srl-ethz/hydra-documentation/README.rst

Documentation for the Hydra MK1 Opensource project
=======================================

This GitHub repository includes all the files and instructions needed to build and run a Hydra MK1 3D printer.

Read the tutorial `here. <https://hydramk1.rtfd.io>`_
