srl-ethz/hydra-documentation/CAD/readme.rst

These are the CAD files of the Hydra MK1.

For your convenience the STL parts to be printed and the technical drawings to be machined have already been generated.

For more information on the machined parts, please refer to `this article. <https://hydramk1.readthedocs.io/en/latest/bom/machined.html>`_

For more information on the printed parts, please refer to `this article. <https://hydramk1.readthedocs.io/en/latest/bom/printed.html>`_
