srl-ethz/hydra-documentation/Firmware/readme.rst

These are the files that have to be edited and put on the virtual SD card of the raspberry Pi.

Please read the documentation `here. <https://hydramk1.readthedocs.io/en/latest/build/firmware.html#reprap-firmware>`_
