srl-ethz/hydra-documentation/docs/source/usage/overview.rst

################################
Hardware and Software Overview
################################

This section will give a more specific overview of the hardware and software components and their functions.

Motion System
===============
The motion system consists of the frame, the axis, including the motors, and the print bed.
The `Rat Rig <https://www.ratrig.com/>`_ is built up from 3030 aluminium profiles (Exception: The X-Axis consists of a 2020 profile). They are connected with aluminium plates in the corners, as well as 90-degree brackets for the back linear rail mounting. The Z-axis runs on three linear rails that are directly screwed to the inside of the outer profiles. It is driven via three threaded rods connected to NEMA 17 stepper motors via thrust bearings and couplers. The print bed is an aluminium plate that has three steel balls screwed into the underside. These steel balls rest between two steel rods that are inserted in 3D printed parts, running on the linear rails and connected to the threaded rods via a plastic coupler. 
The Y-axis consists of a 2020 extrustion that is mounted on two linear rails that are mounted to the underside of the top of the frame. A third linear rail is screwed to the top of the 2020 extrusion to serve as the X-axis. The X and Y axis are driven via two long belts in a core XY layout. The belts are driven by two NEMA 17 motors located in the back of the top frame.
To tension the belts a 3D printed tensioning system mounted on the X-carriage is used. 

Tool Changer
============

The `tool changer <https://e3d-online.com/pages/toolchanger>`_ is directly mounted to the X-carriage, and consists of the tool plate, that interfaces with the receivers, a shaft to lock in the receivers, and a stepper motor to drive the shaft. The receivers have a slanted middle section, so they are pulled towards the tool plate when the shaft turns. To always apply the same force pulling the receivers towards the tool plate, the shaft is spring-loaded.

Electronics
============

The machine can be interfaced with via the web interface, hosted by a Raspberry Pi 3B running `DuetPi <https://github.com/Duet3D/DuetPi>`_ . The main Reprap 3 firmware runs on the `Duet <https://www.duet3d.com/>`_ 3 6HC. It offers connections for the X/Y stepper motors, the three Z stepper motors, the heated bed temperature sensor, the heated bed control output, and the microswitches, which are used to home the printer. It offers an additional stepper driver output, several connectors for 12-24V power outputs, and inputs for temperature sensors. To accommodate for the additional extruders and the stepper needed for the tool changer, a Duet 3 Expansion Board 3HC and a Duet 3 Tool Board are used. These boards are connected to the mainboard using a CAN connection. All boards have to be supplied with 24V which is provided by a power supply that is included in the Rat Rig kit. To switch the 230V needed for the heated bed a solid-state relay is used.
For more information on the wiring in the back of the printer, please check the section "Electronics and Wiring" under "Building Instructions".

Duet Pi
========

The Raspberry Pi hosts a web interface, which can be used to easily interface with the printer. It also makes it possible to connect to the printer via SSH. This streamlines updates to the firmware of the printer.

Duet Firmware
==============

The Hydra MK1 uses the most recent RepRap firmware. To configure the printer several .g-files are needed in the virtual SD card repository (The SD card is virtual since it is using storage on the Raspberry Pi and not a physical SD card). You can find the files on the github repository. Some are detailed in the section "Firmware and Slicer" in "Building Instructions". Here only a brief overview is given:

:config.g: The config.g file contains the initialisation process of the printer. Here all inputs and outputs are defined. Additionally, the parameters for motors, heaters, and sensors are set, and the hotends are defined.
:home.g: Homes the respective axis. In case of homeall.g the X and Y-axis are homed simultaneously, with the Z-axis following and the C-axis (coupler) being homed last. homeall.g can be run via the gcode command G28.
:bed.g: This file is called via the gcode command G32. It probes the bed at three locations close to the Z-axis leadscrews and adjusts the three axis to accommodate for any tilt in the bed.
:tfree.g: This file is called when the respective tool is deselected. It drives back to the parking spot, disengages the coupler, and clears the print head.
:tpre.g: This file is called when a tool is selected. It drives to the parking spot and couples the tool. It then moves the print bed a fixed amount to make sure the print head has enough clearance, after which it will move out.
:tpost: This file is called after tpre.g. It preheats, the print head, sets the correct offset, and moves out a bit further.

Prusa Slicer
============

Slicing files for the Hydra MK1 can be done in any slicer that can accommodate multiple printheads. This guide provides config files for PrusaSlicer. In the slicer, different extruders can be chosen for parts of the structure and for each extruder a different material can be selected.

Tools
=========

Depending on the configuration of the machine you can have multiple different tools in the back of the machine, that can be collected by the tool changer. In the standard configuration, the printer features two filament printing heads and two pellet printing heads.
