srl-ethz/hydra-documentation/docs/source/index.rst

.. doc_demo documentation master file, created by
   sphinx-quickstart on Fri Dec  3 21:49:37 2021.
   You can adapt this file completely to your liking, but it should at least
   contain the root `toctree` directive.

####################################
The Hydra MK1 Documentation
####################################

.. toctree::
   :maxdepth: 2
   :caption: Introduction

   What is a Hydra MK1? <intro/whatis>
   What Components are Used in the Hydra MK1? <intro/components>
   
.. toctree::
   :maxdepth: 2
   :caption: Bill of Materials (BOM)
   
   Overview <bom/overview>
   Machined Parts <bom/machined>
   Printed Parts <bom/printed>
   Crimped Wires <bom/wires>

.. toctree::
   :maxdepth: 2
   :caption: Building instructions
   
   Rat Rig <build/ratrig>
   X Carriage and Toolchanger <build/carriage>
   Electronics and Wiring <build/electronics>
   Firmware and Slicer <build/firmware>
   
.. toctree::
   :maxdepth: 2
   :caption: Tools
   
   E3D Hemera <tools/hemera>
   Pellet Extruder v4 <tools/pellet>
   
.. toctree::
   :maxdepth: 2
   :caption: Usage
   
   Hardware and Software Overview <usage/overview>
   Powering Up and Connecting to the Printer <usage/power>
   Homing <usage/homing>
   Preheating and Swapping Tools <usage/preheat>
   Loading Material <usage/loading>
   Slicing and Printing <usage/slicing>
   
.. toctree::
   :maxdepth: 2
   :caption: Maintenance
   
   Updating Firmware <maintenance/update>
   Calibrating Tool Offsets <maintenance/offset>
   Calibrating Parking Spot <maintenance/parking>
   Unclogging Hemera <maintenance/unclogghemera>
   Unclogging Pellet Extruder <maintenance/uncloggpellet>
