srl-ethz/hydra-documentation/docs/source/tools/pellet.rst

################################
Pellet Extruder V4
################################

In case your pellet extruder came preassembled please disassemble it until it looks like the one in this image. This can be done intuitively or by following several steps of this build guide backwards.

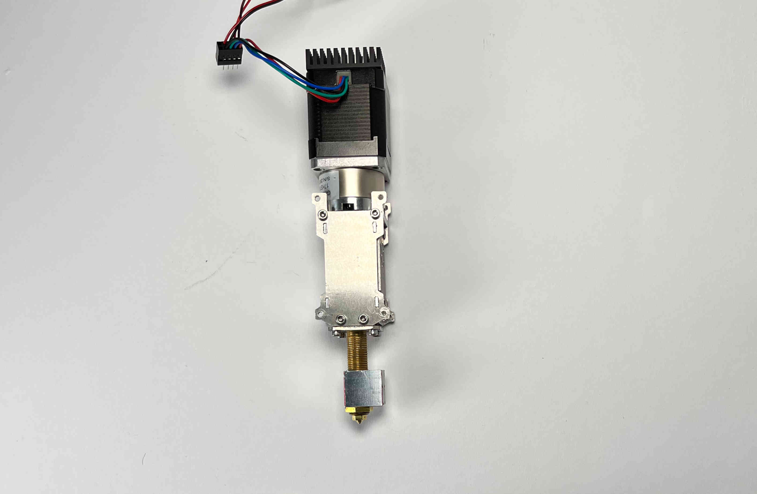
[picture p9: docs/source/tools/img/Pellet1.jpg]

   
Heating Element
===============

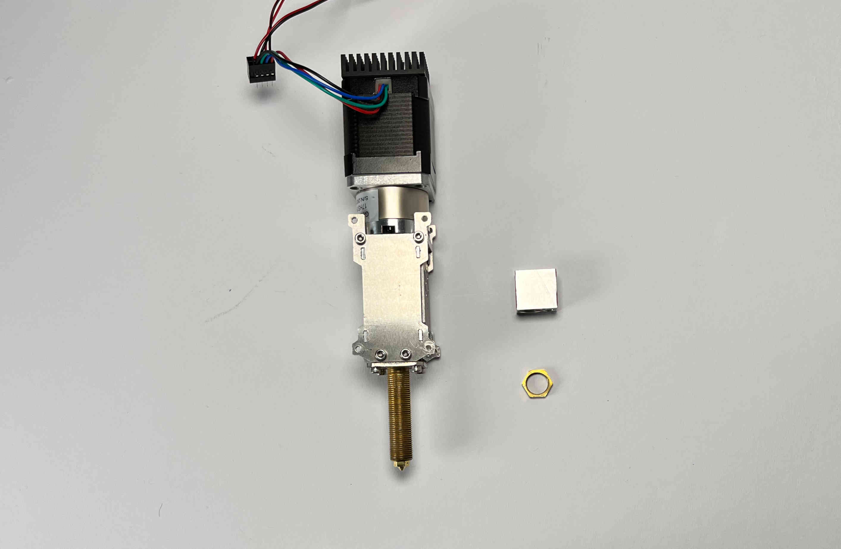
[picture p10: docs/source/tools/img/Pellet2.jpg]


| Remove the hex nut and the heater block from the hot end

| 

| 

| 

----------------------------

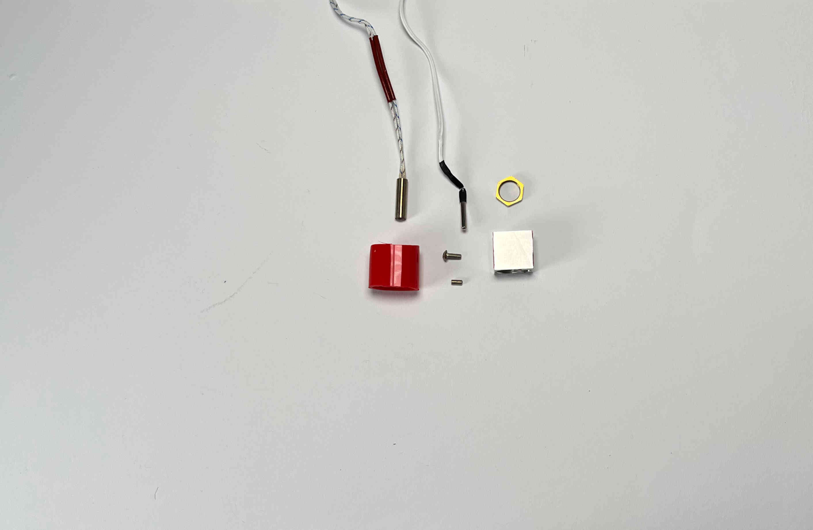
[picture p11: docs/source/tools/img/Pellet3.jpg]


| Prepare the heat cartridge, the thermistor and the silicone tube

| 

|

| 

----------------------------

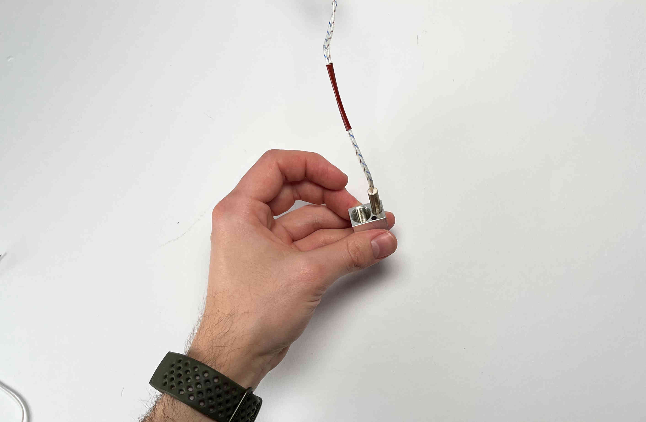
[picture p12: docs/source/tools/img/Pellet4.jpg]


| Insert the heat cartridge

|

| 

| 

| 

----------------------------

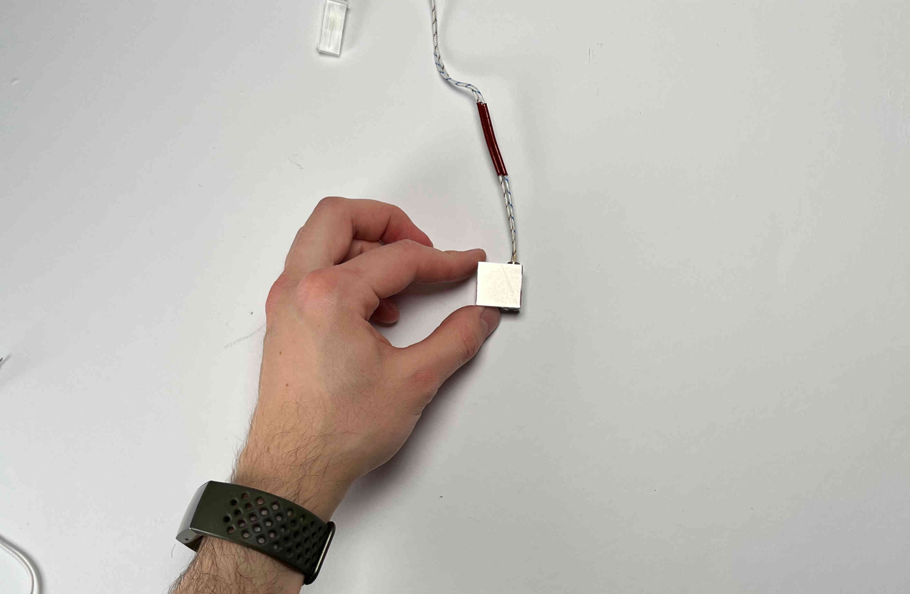
[picture p13: docs/source/tools/img/Pellet5.jpg]


| Make sure the heat cartridge is flush with the bottom of the heater block.

|

| 

| 

----------------------------

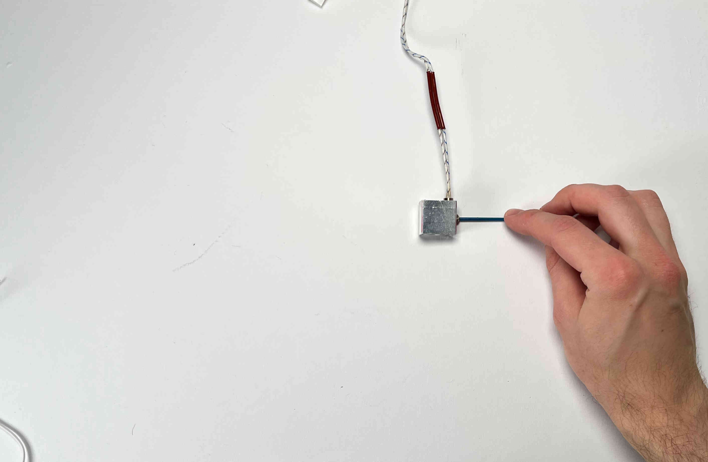
[picture p14: docs/source/tools/img/Pellet6.jpg]


| Carefully clamp the heat cartridge using the provided screw.

| 

| 

| 

----------------------------

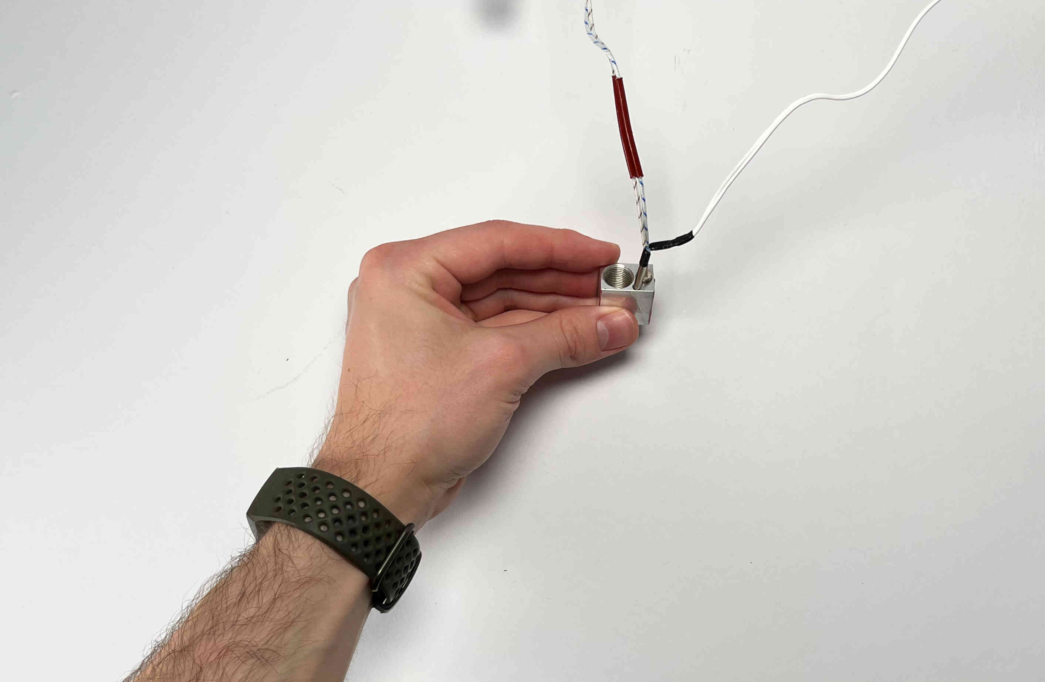
[picture p15: docs/source/tools/img/Pellet7.jpg]


| Insert the thermistor (It makes sense to check the thermistor by mearing its resistance. It should be around 100 kOhm)

|

| 

| 

----------------------------

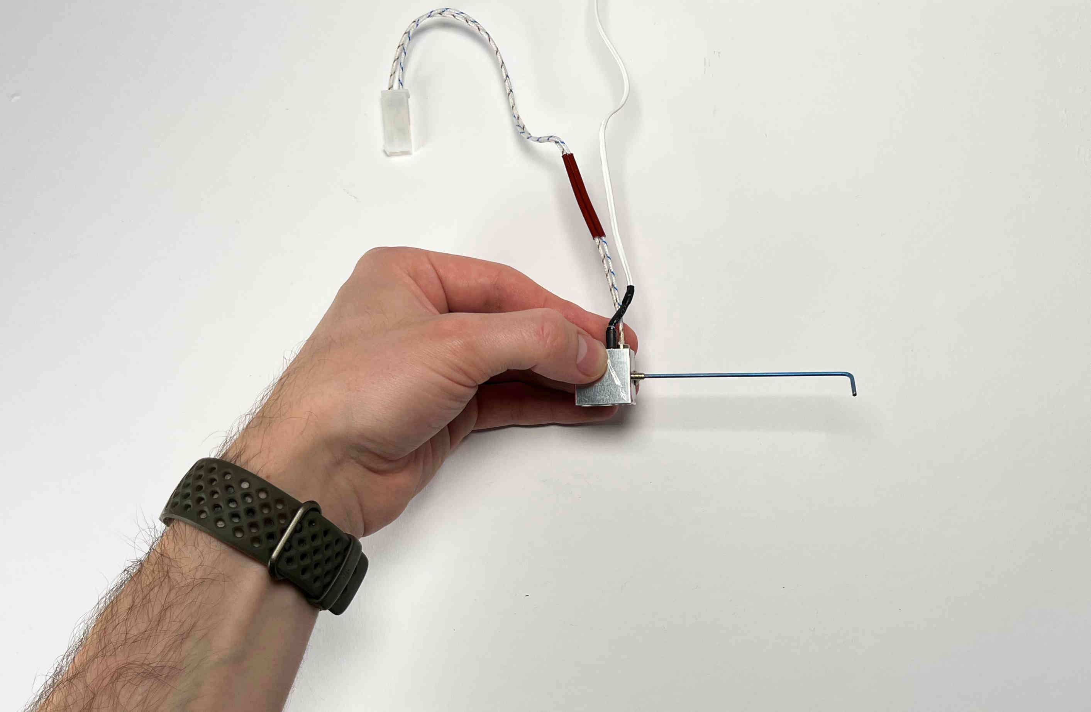
[picture p16: docs/source/tools/img/Pellet9.jpg]


| Carefully clamp the thermistor using the provided set screw.

| 

| 

|

| 

----------------------------

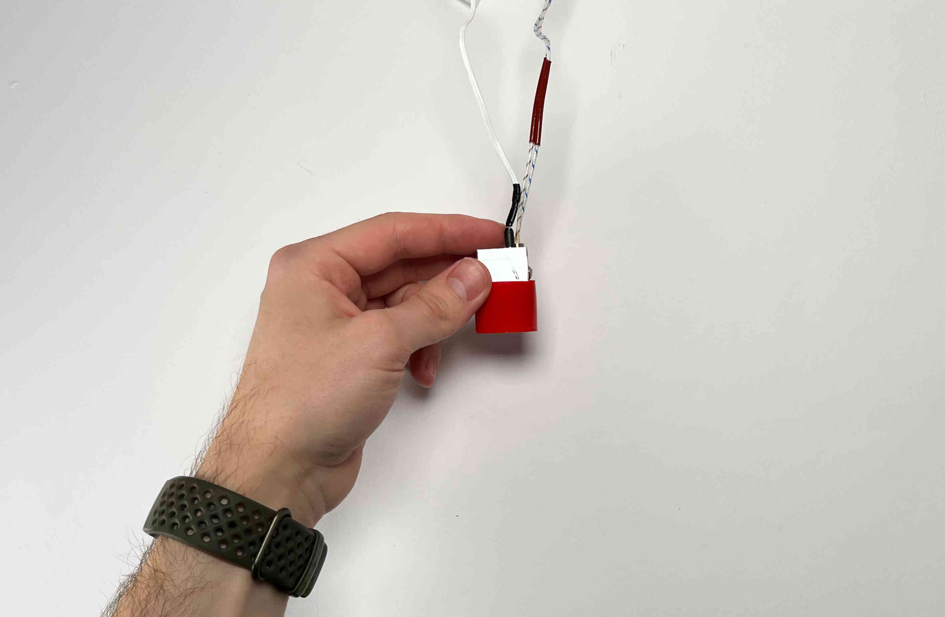
[picture p17: docs/source/tools/img/Pellet10.jpg]


| Cover the heater block with the silicone tube.

| 

| 

| 

|

----------------------------

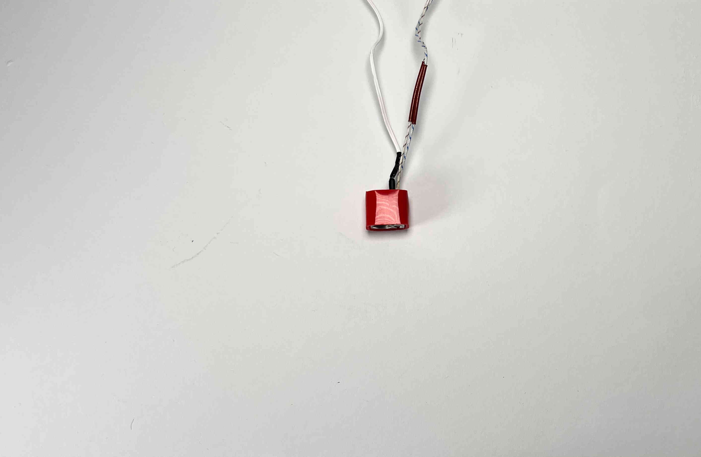
[picture p18: docs/source/tools/img/Pellet11.jpg]


| Make sure the silicone sock is flush with the lower side of the heater block.

| 

| 

|

----------------------------

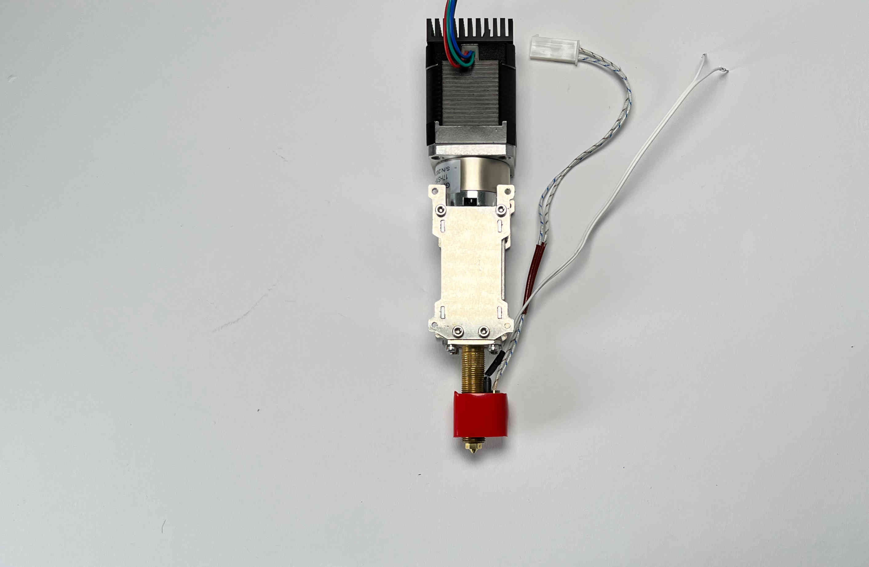
[picture p19: docs/source/tools/img/Pellet12.jpg]


| Carefully reinstall the heater block on the Pellet Extruder.

| 

| 

|

----------------------------

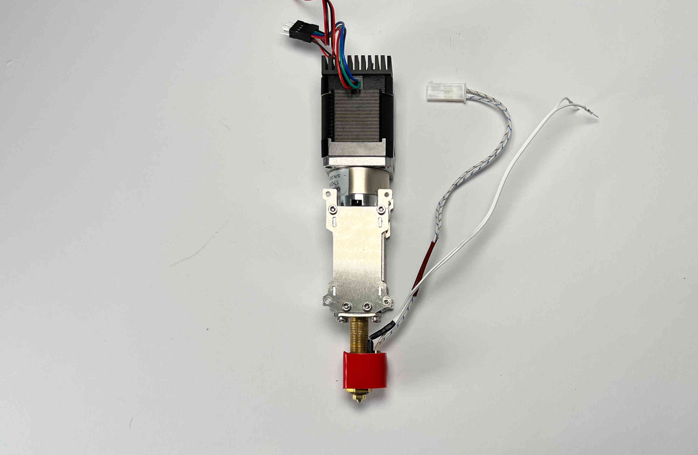
[picture p20: docs/source/tools/img/Pellet13.jpg]


| Tighten the heater block in place with the hex nut.

| 

| 

|

| 

----------------------------

Pellet Parking Spot
===================

Prepare the printed part “pellet_parking”, the machined part “pellet_bracket”, two M3 locking nuts, one M3x5 screw, two pins, the small magnet, and two M3x16 screws (The last three items are included in the “blank toolplate and dock” kit from E3D).

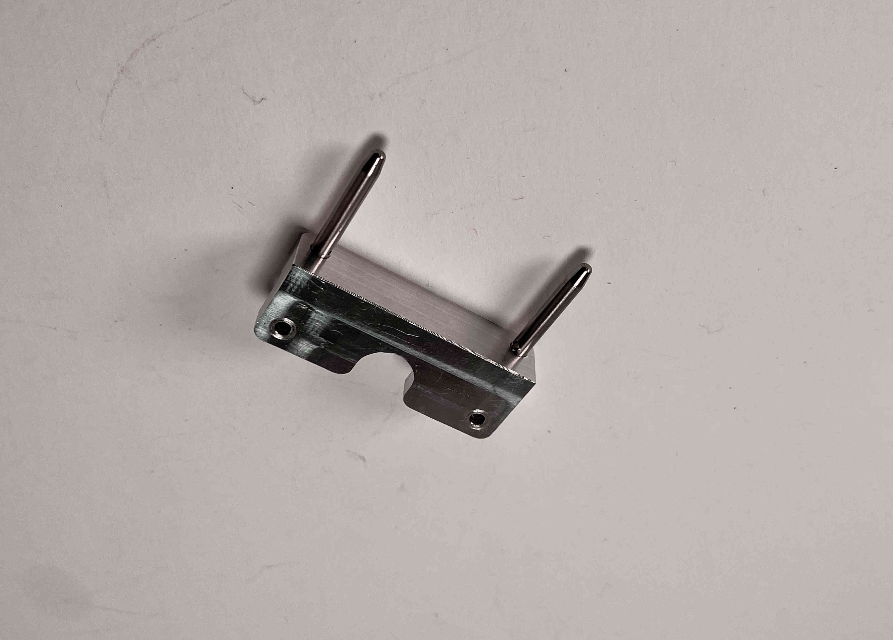
[picture p21: docs/source/tools/img/PelPark2.jpg]


| Screw the two pins into the pellet_bracket. If the fit is too tight carefully loosen up the outer hole with a 4mm drill bit. 

| 

|

| 

----------------------------

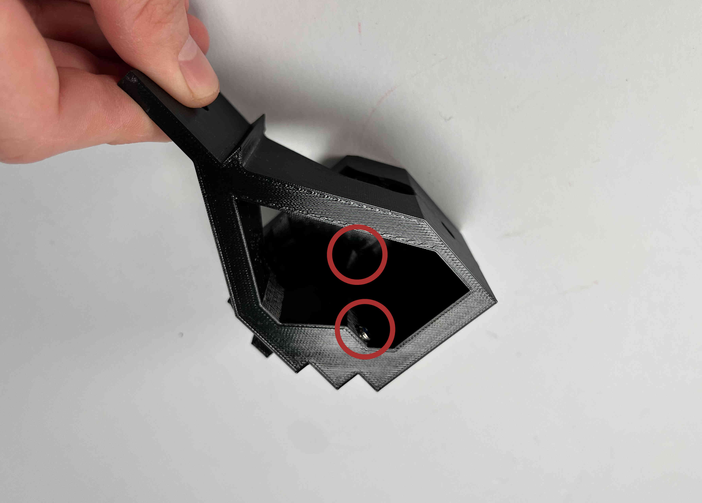
[picture p22: docs/source/tools/img/PelPark1.jpg]


| Insert two M3 locking nuts into the pellet_parking part

| 

| 

|

|

----------------------------

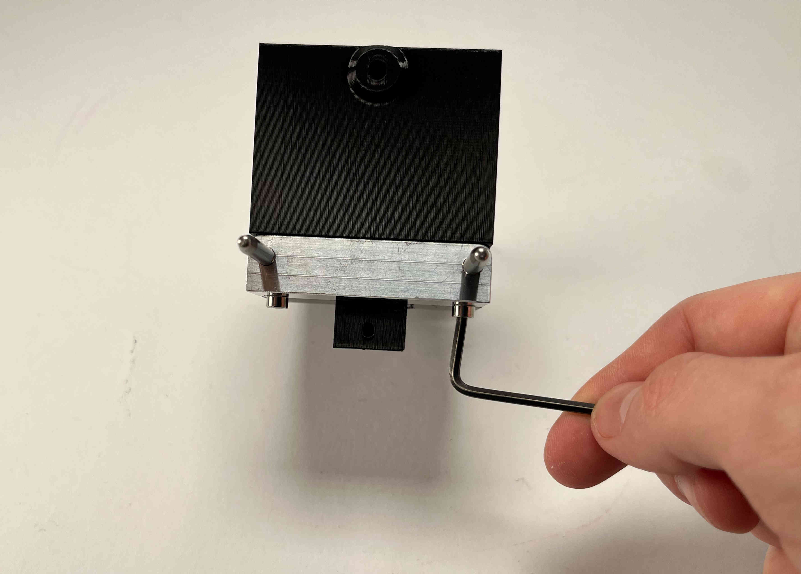
[picture p23: docs/source/tools/img/PelPark3.jpg]


| Tighten the bracket to the parking spot using the two M3x16 screws.

| 

|

| 

|

----------------------------

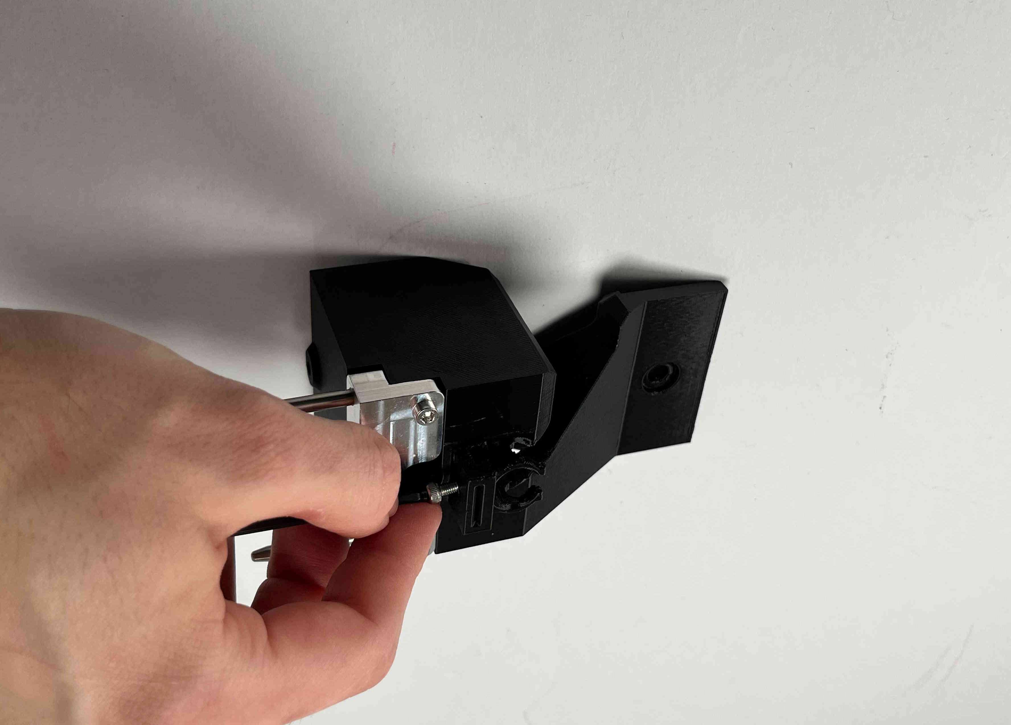
[picture p24: docs/source/tools/img/PelPark5.jpg]


| Carefully tap an M3 thread into the plastic part using the M3x5 screw. This is later used to clamp the cable brace.

| 

|

| 

----------------------------

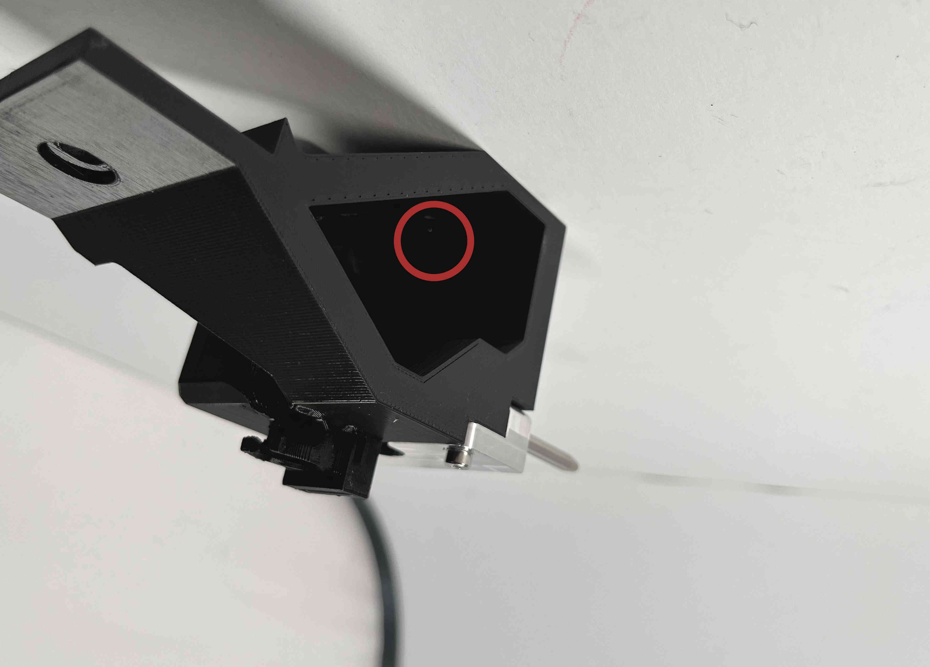
[picture p25: docs/source/tools/img/PelPark4.jpg]


| Push in the magnet until it is up against the outer plastic holding it in place. 

| 

| 

|

|

----------------------------

Receiving Bracket
==================

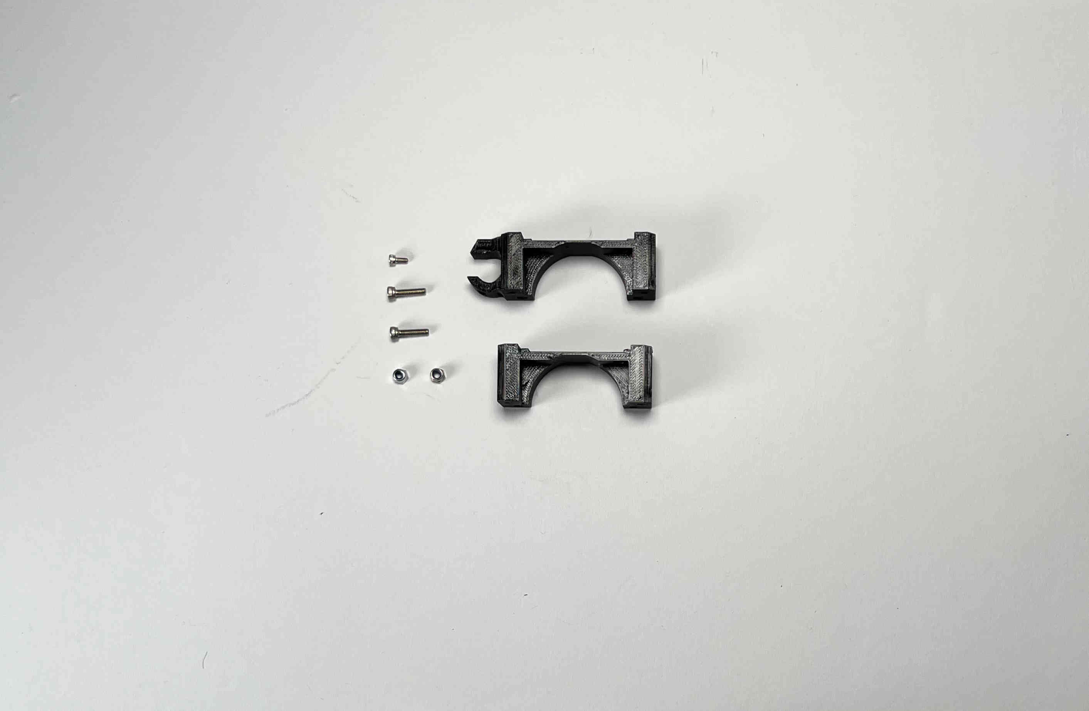
[picture p26: docs/source/tools/img/Pellet14.jpg]


| Prepare two M3 locking nuts, two M3x16 screws, one M3x5 screw, and the two parts of the “pellet_receiver”.

| 

| 

|

----------------------------

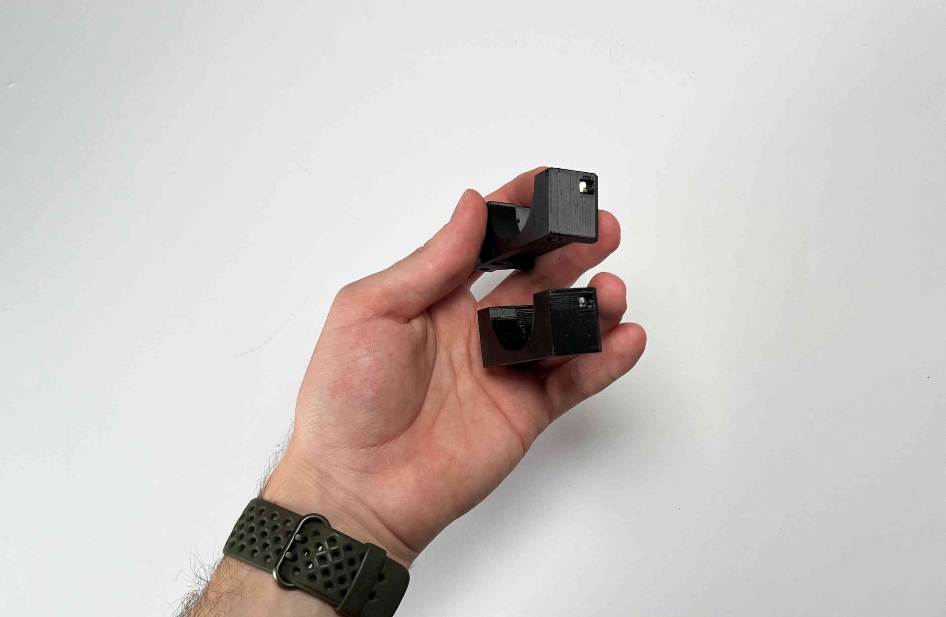
[picture p27: docs/source/tools/img/Pellet15.jpg]


| Insert one M3 locking nut into each of the two pieces of the “pellet_receiver” part.

| 

| 

|

----------------------------

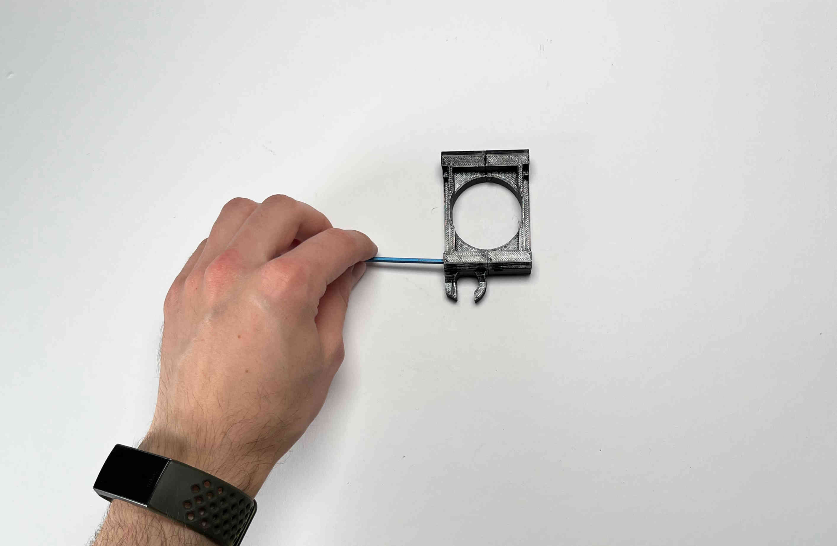
[picture p28: docs/source/tools/img/Pellet17.jpg]


| Place both parts upside down on a flat surface and join them using two M3x16 screws

| 

| 

|

----------------------------

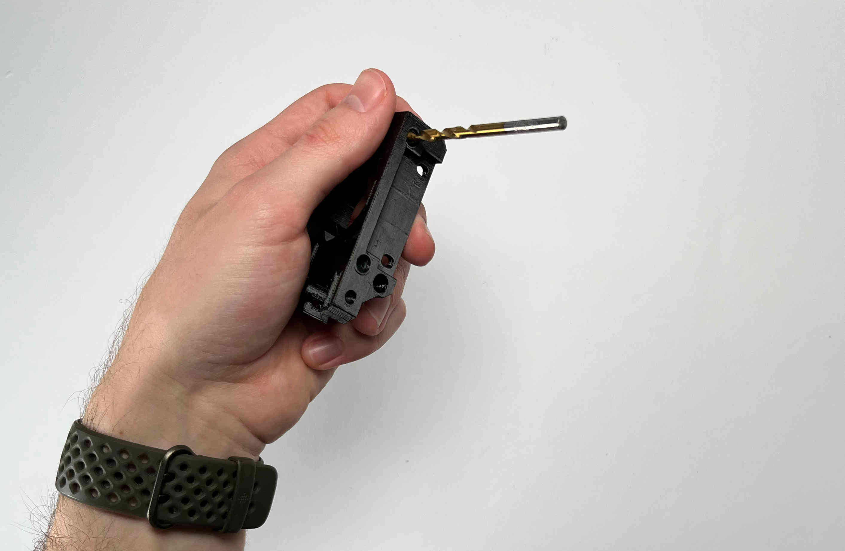
[picture p29: docs/source/tools/img/Pellet18.jpg]


| Using a 4mm drill bit carefully widen the receiver holes for the pins. Constantly check the fit using the already assembled parking spot

| 

| 

|

----------------------------

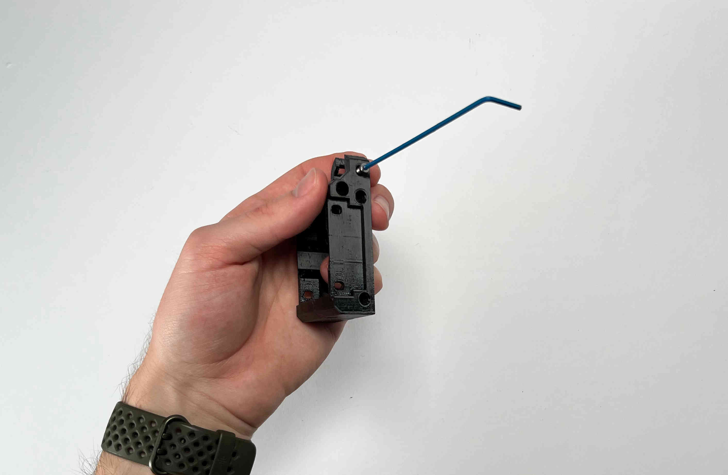
[picture p30: docs/source/tools/img/Pellet20.jpg]


| Carefully tap an M3 thread into the plastic part using the M3x5 screw. This will later be used to clamp the cable brace.

| 

| 

|

----------------------------

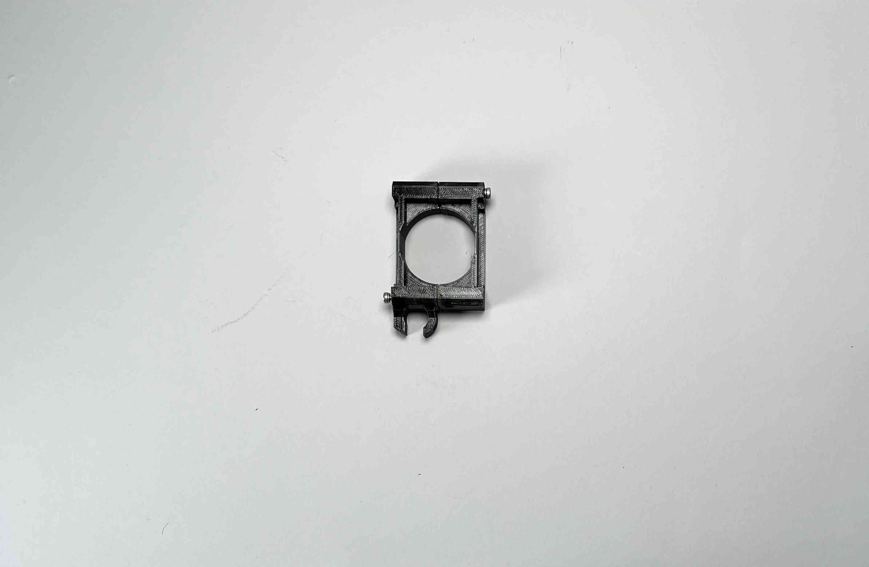
[picture p31: docs/source/tools/img/Pellet16.jpg]


| Unscrew the two parts and set them aside for future steps.

|

| 

| 

----------------------------
	
Body Assembly
=============

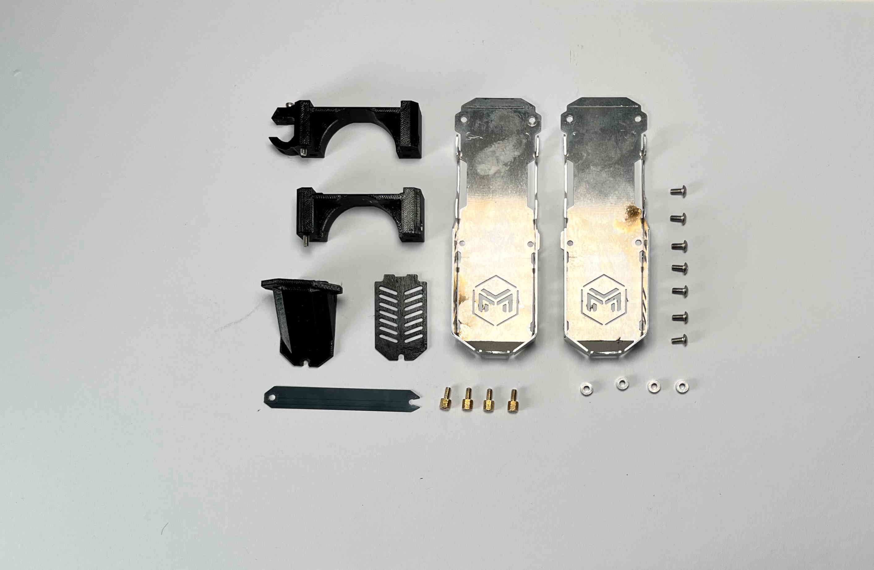
[picture p32: docs/source/tools/img/Pellet21.jpg]


| Prepare the two parts of the “pellet_receiver”, the “pellet_fan_grate”, the “pellet_guide”, the cut and predrilled steel strip, and the two outer aluminium brackets of the pellet head including the screws, that held it down.

|

| 

----------------------------

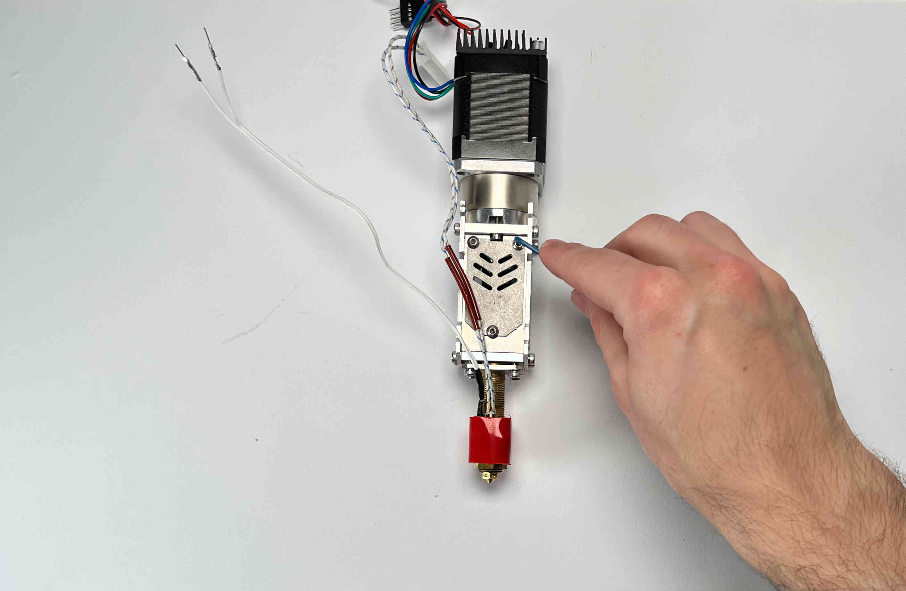
[picture p33: docs/source/tools/img/Pellet22.jpg]


| Remove the aluminium grate from the pellet extruder.

|

| 

| 

----------------------------

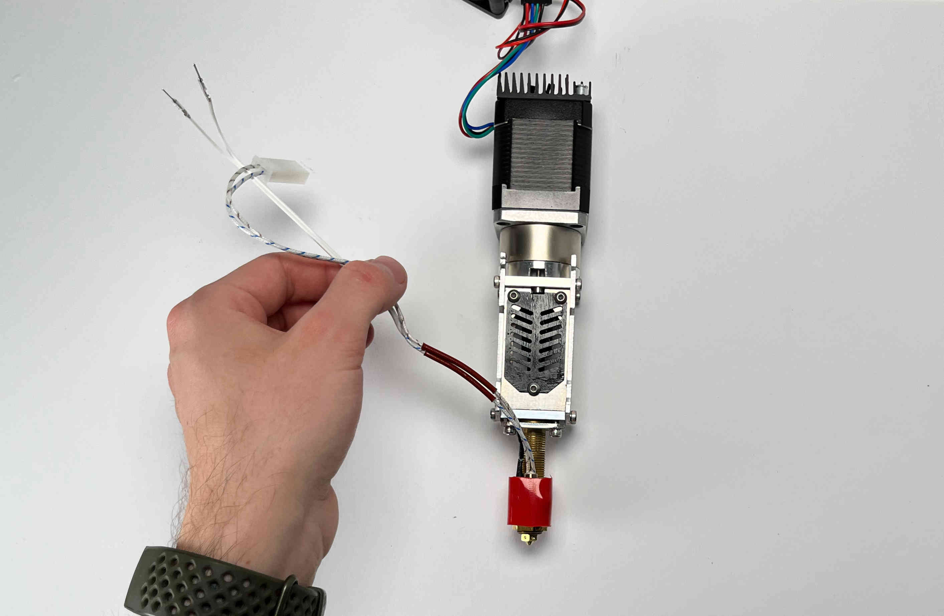
[picture p34: docs/source/tools/img/Pellet24.jpg]


| Add the “pellet_fan_grate” using the screws you just removed.

|

| 

| 

----------------------------

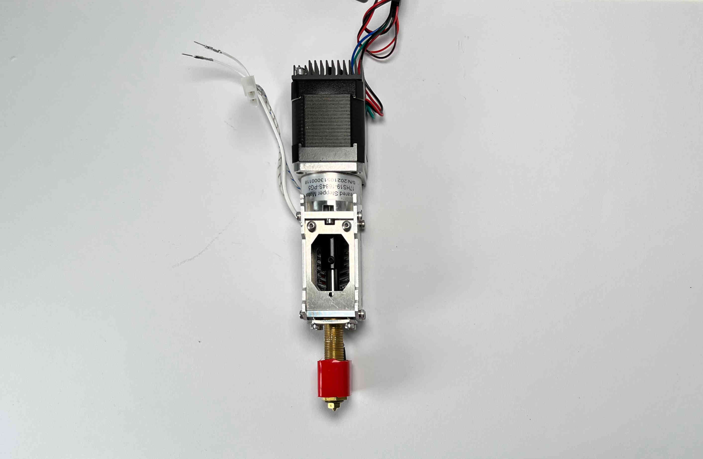
[picture p35: docs/source/tools/img/Pellet25.jpg]


| On the other side insert two of the same kind of screws. Do not tighten them yet.

|

| 

| 

----------------------------

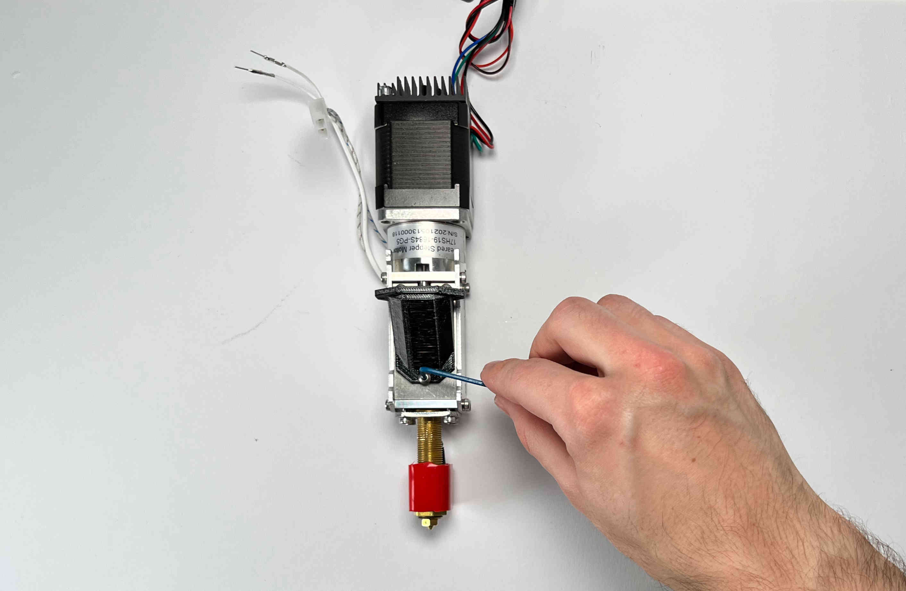
[picture p36: docs/source/tools/img/Pellet27.jpg]


| Align the "pellet_guide" using the two upper screws and fasten it down using all three screws.

|

| 

| 

----------------------------

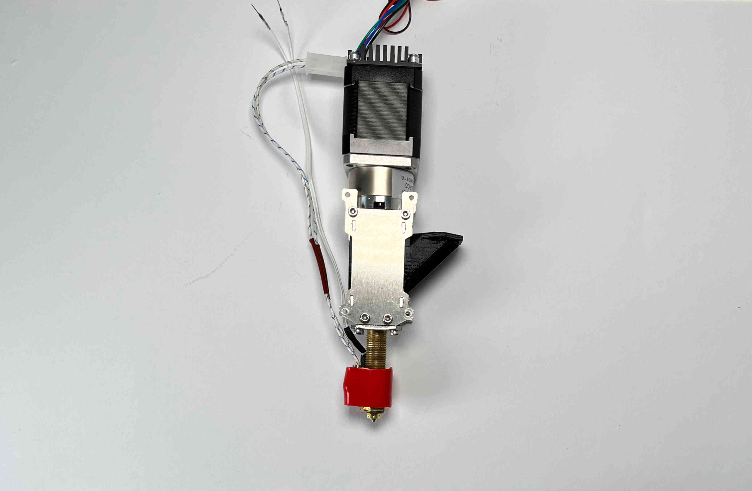
[picture p37: docs/source/tools/img/Pellet28.jpg]


| Place the pellet extruder on its side, so the pellet guide is facing the right, and the heater cables are facing the left.

|

| 

| 

----------------------------

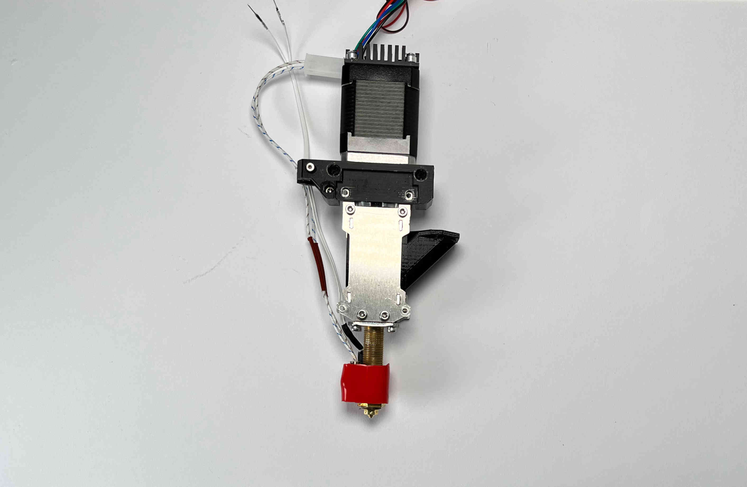
[picture p38: docs/source/tools/img/Pellet29.jpg]


| Place the “pellet_bracket_A” (the one with the cable brace) on the side of the extruder. 

|

| 

| 

----------------------------

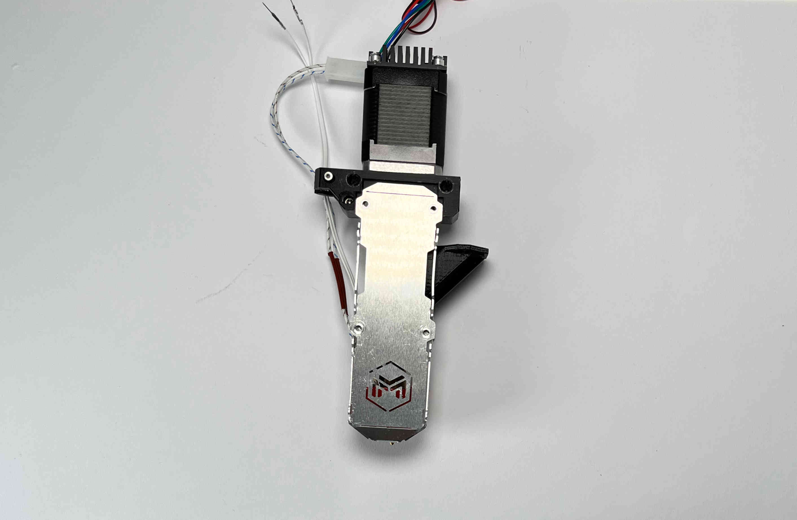
[picture p39: docs/source/tools/img/Pellet30.jpg]


| Place one of the outer aluminium brackets on top of the pellet_bracket_A.

|

| 

| 

----------------------------

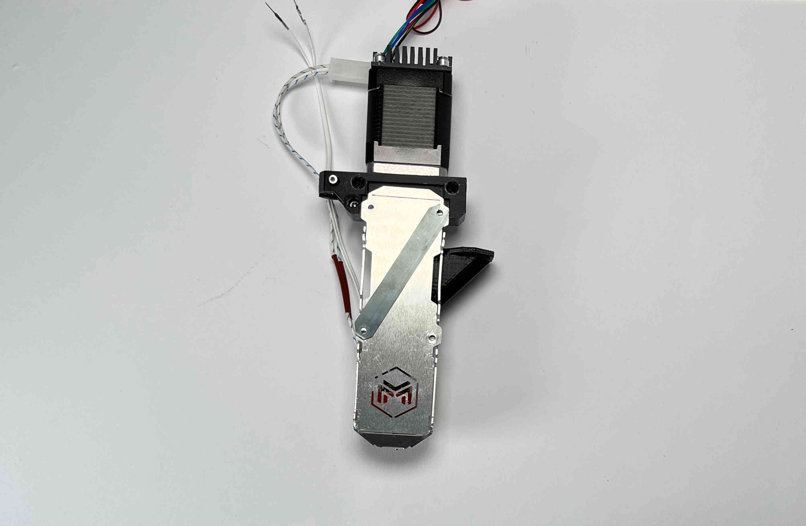
[picture p40: docs/source/tools/img/Pellet31.jpg]


| Place the steel strip on top of the aluminium bracket.

|

| 

| 

----------------------------

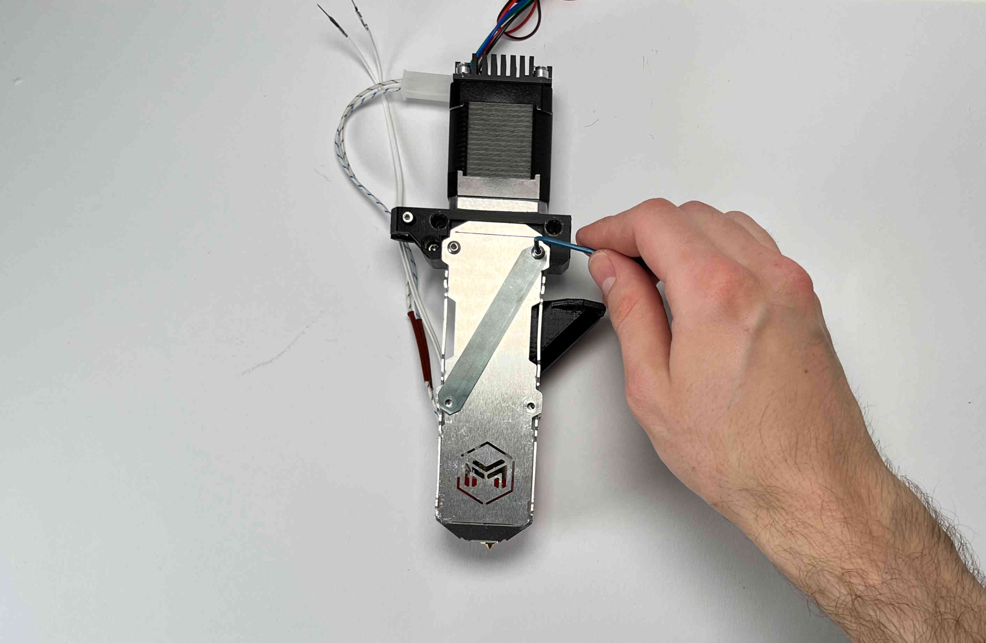
[picture p41: docs/source/tools/img/Pellet32.jpg]


| Insert the M3 screws. Do not tighten yet.

|

| 

| 

|

----------------------------
	
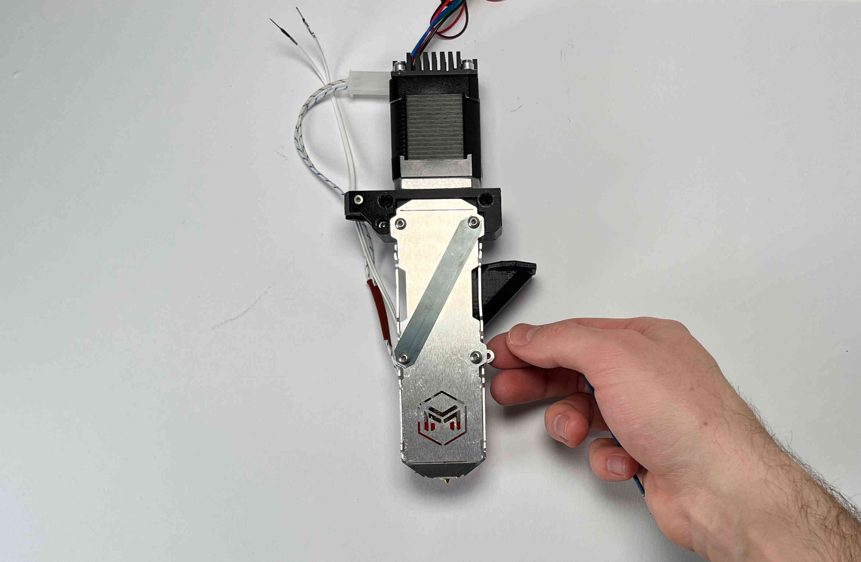
[picture p42: docs/source/tools/img/Pellet33.jpg]


| Insert two aluminium spacers and the other two M3 screws. Do not tighten yet.

|

| 

| 

----------------------------

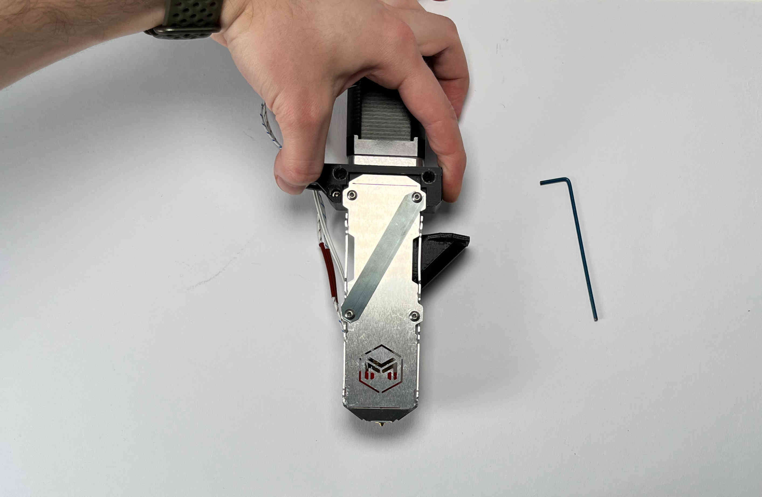
[picture p43: docs/source/tools/img/Pellet35.jpg]


| Push the pellet_bracket_A all the way up against the motor and tighten down the two upper M3 screws. This is essential for a good fit with the parking spot once installed on the printer.

|

| 

----------------------------

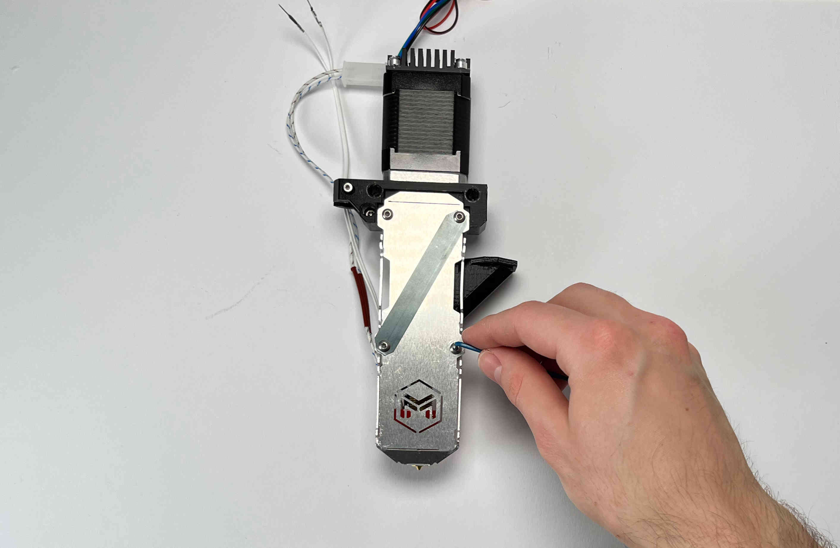
[picture p44: docs/source/tools/img/Pellet36.jpg]


| Tighten the other two screws.

|

| 

|

| 

----------------------------

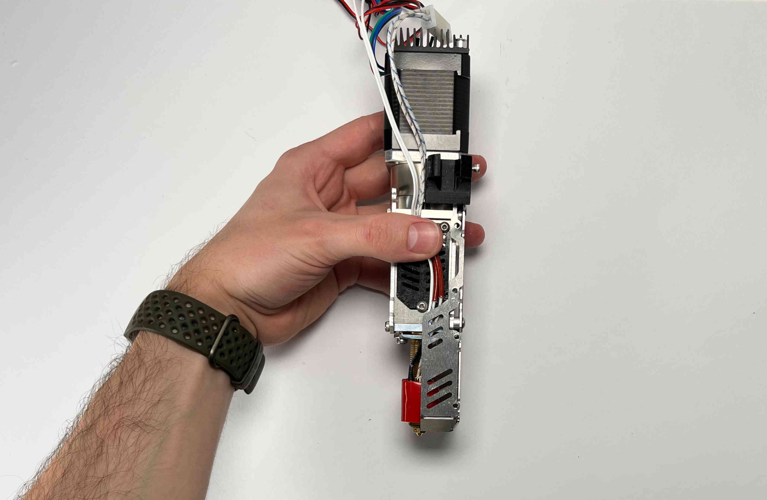
[picture p45: docs/source/tools/img/Pellet37.jpg]


| For future steps make sure the heater cables are tucked inside the aluminium bracket.

| 

| 

|

----------------------------

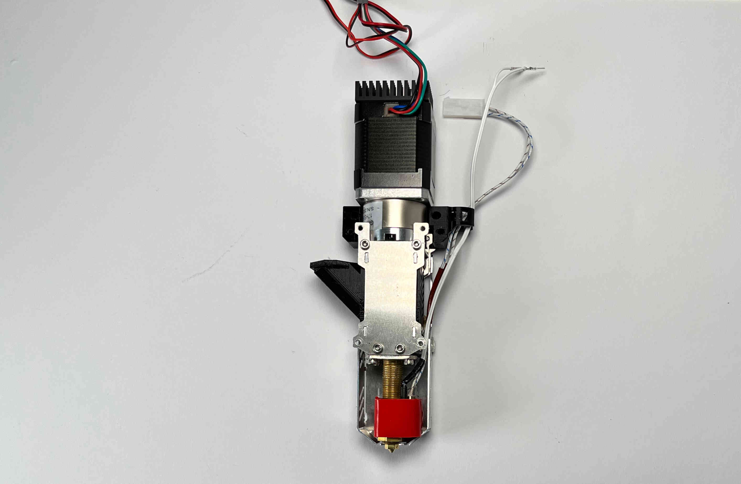
[picture p46: docs/source/tools/img/Pellet38.jpg]


| Turn the extruder around.

|

|

| 

| 

----------------------------

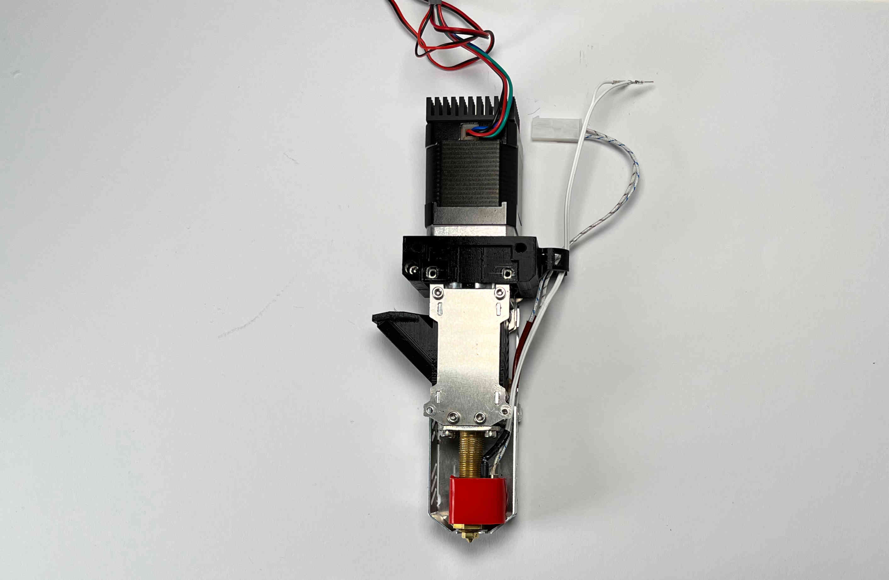
[picture p47: docs/source/tools/img/Pellet39.jpg]


| Place the “pellet_bracket_B” on the extruder.

|

|

| 

| 

----------------------------

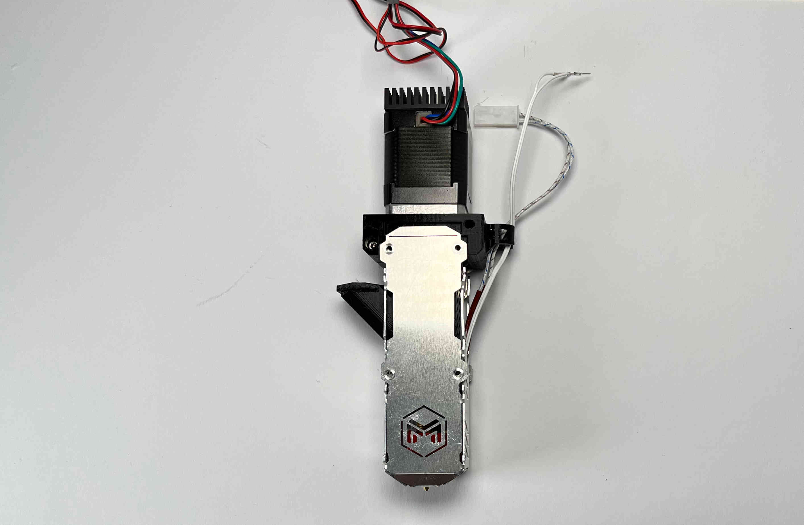
[picture p48: docs/source/tools/img/Pellet40.jpg]


| Place the other outer aluminium brackets on top of the pellet_bracket_B. Make sure the heater cables are still guided inside the lower part of the aluminium bracket.

|

| 

----------------------------

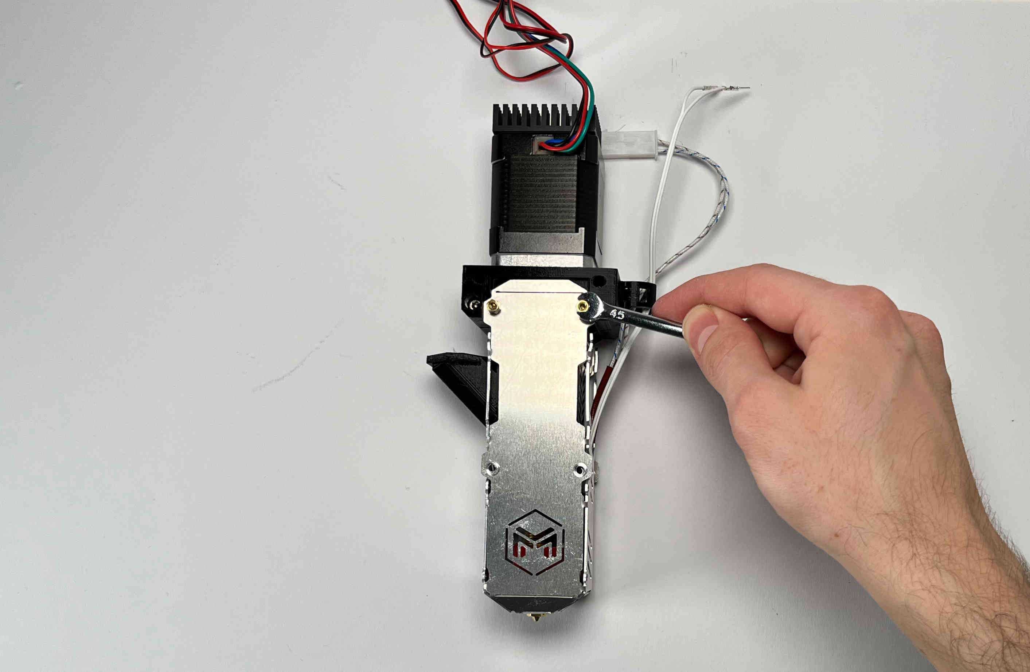
[picture p49: docs/source/tools/img/Pellet41.jpg]


| Insert the M3 standoffs. Do not tighten yet.

|

|

| 

| 

----------------------------

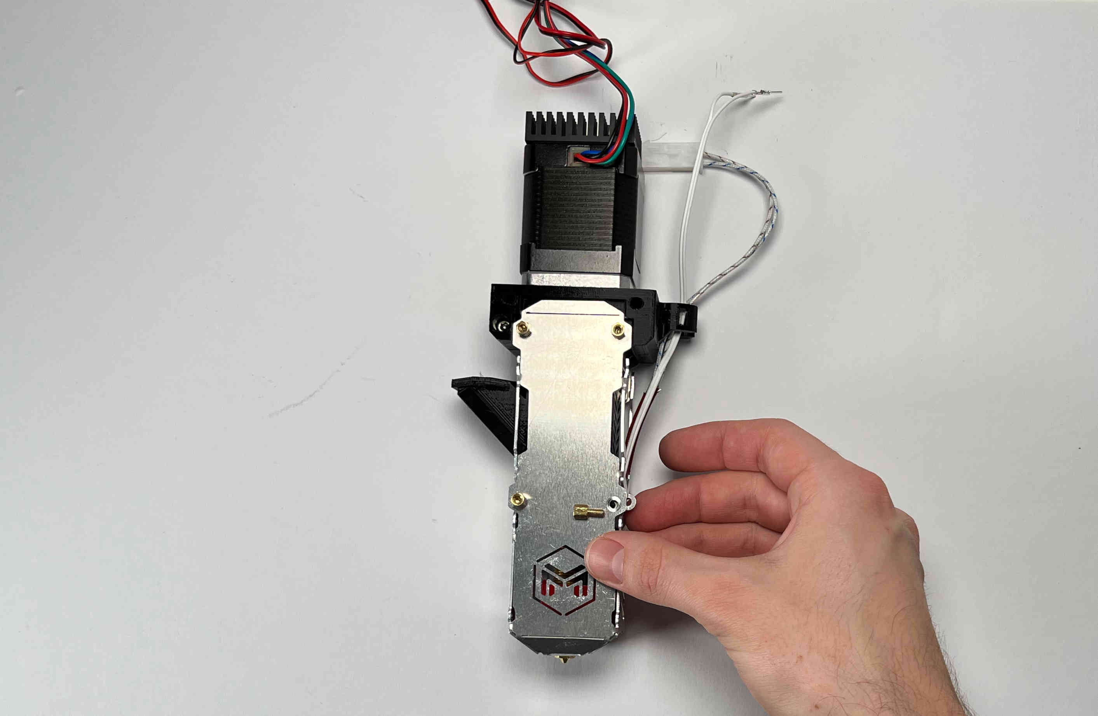
[picture p50: docs/source/tools/img/Pellet42.jpg]


| Insert two aluminium spacers and the other two M3 standoffs. Do not tighten yet.

|

| 

| 

----------------------------

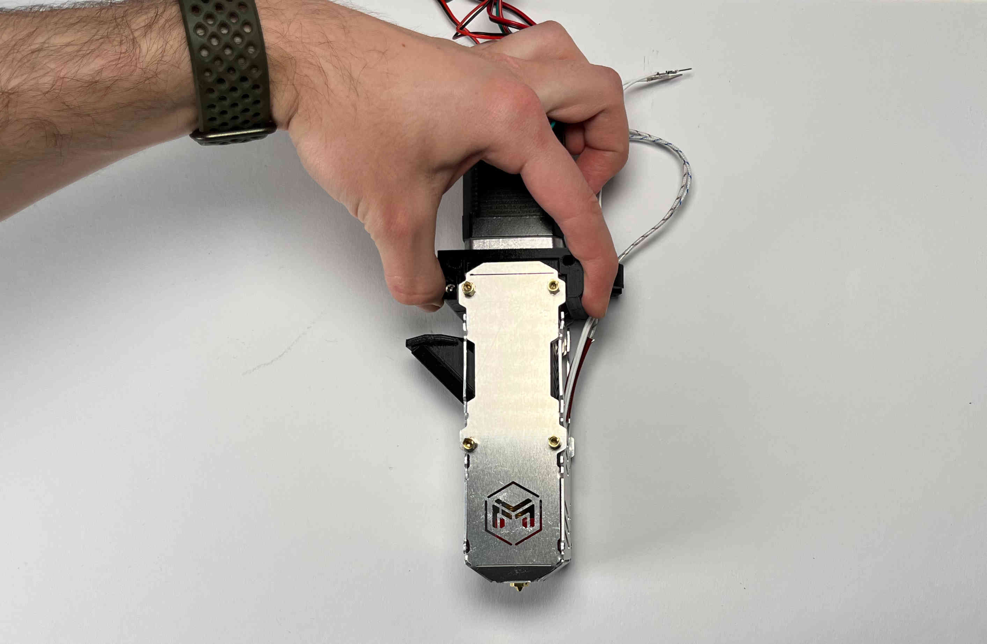
[picture p51: docs/source/tools/img/Pellet43.jpg]


| Push the pellet_bracket_B all the way up against the motor and tighten down the two upper M3 standoffs. 

|

|

|

----------------------------

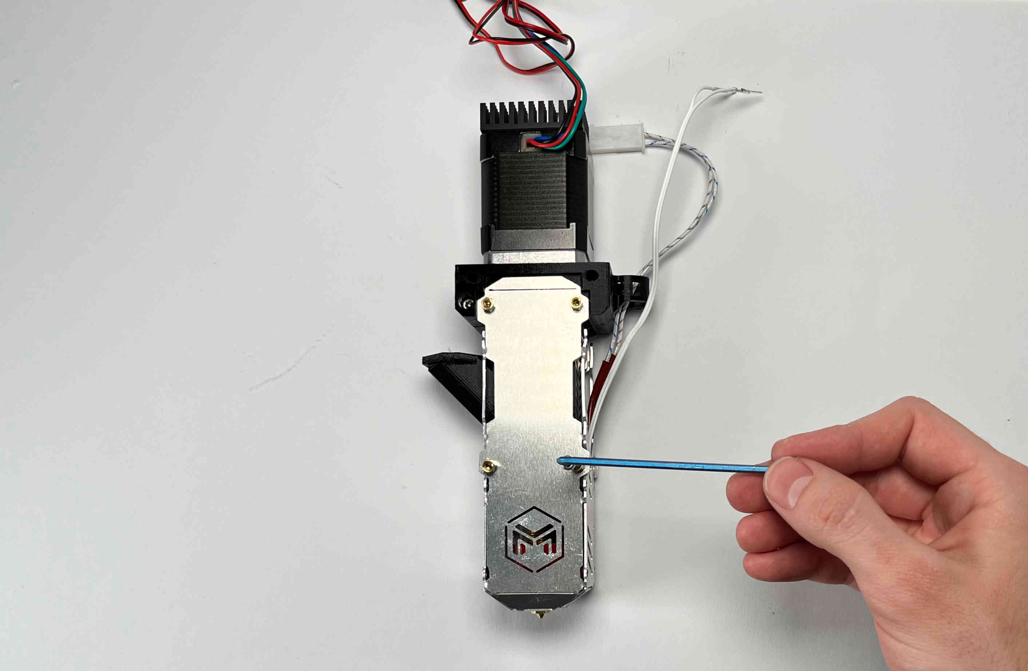
[picture p52: docs/source/tools/img/Pellet44.jpg]


| Tighten the other two standoffs. (TIP: if you don’t have a wrench handy, insert a short M3 screw into the standoffs and use it to tighten them down.)

|

|

| 

----------------------------

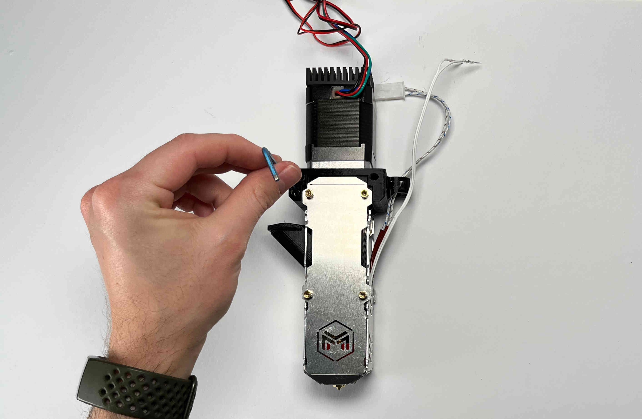
[picture p53: docs/source/tools/img/Pellet45.jpg]


| Tighten the two M3 screws inside the pellet bracket.

|

| 

| 

----------------------------
	
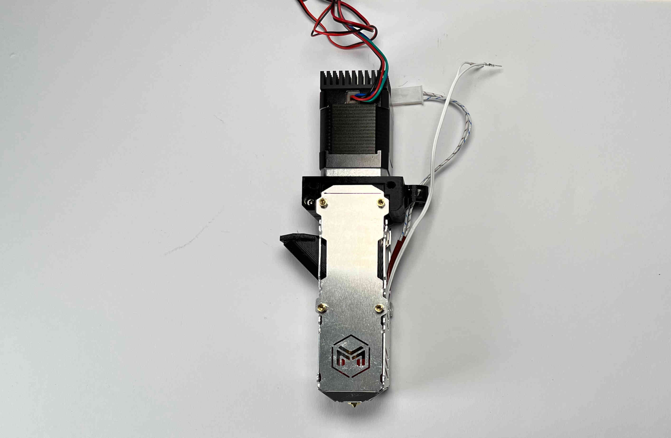
[picture p54: docs/source/tools/img/Pellet46.jpg]


| Note: there should be no gap between the motor and the bracket.

|

| 

| 

----------------------------

Fans
======

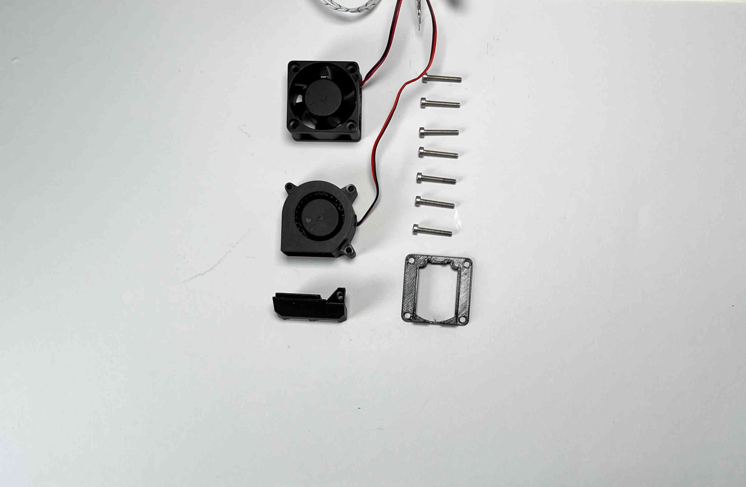
[picture p55: docs/source/tools/img/Pellet47.jpg]


| Prepare the “pellet_fan_shroud”, the “pellet_fan_guide”, the two fans, and the seven M3 screws that were holding down the fans.

|

| 

| 

----------------------------

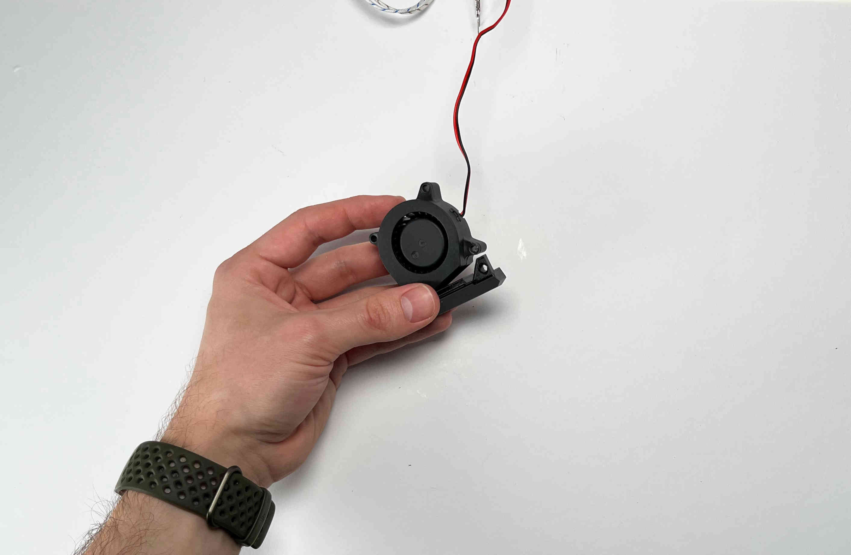
[picture p56: docs/source/tools/img/Pellet48.jpg]


| Insert the “pellet_fan_shroud” into the turbo/print fan.

|

| 

| 

----------------------------

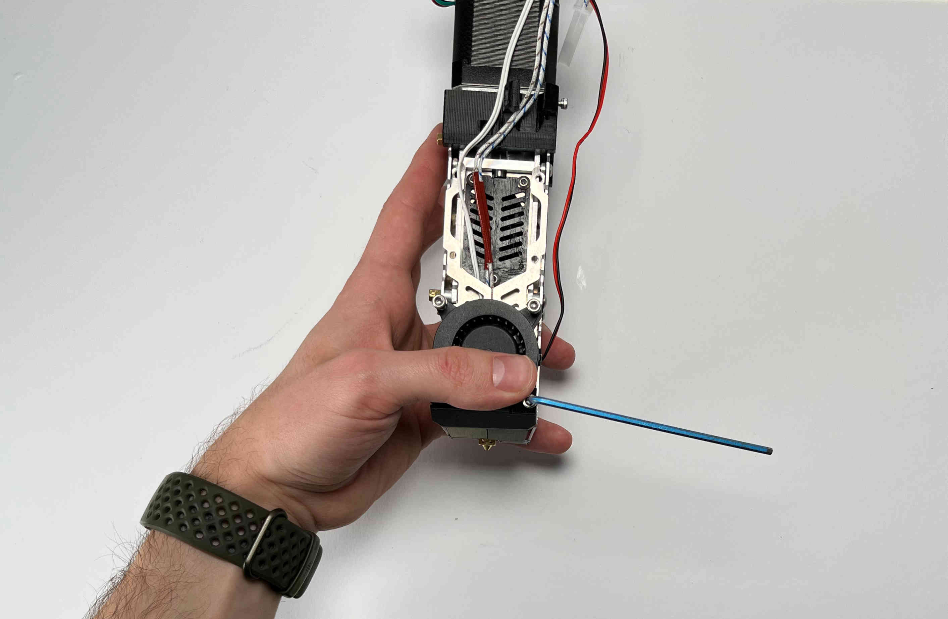
[picture p57: docs/source/tools/img/Pellet50.jpg]


| Fasten the print fan to the extruder using three M3 screws.

|

| 

| 

----------------------------

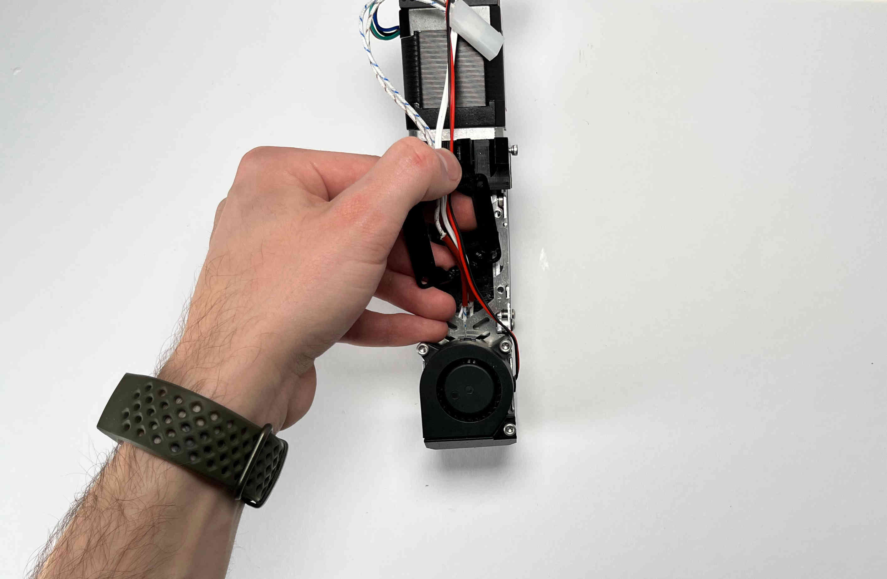
[picture p58: docs/source/tools/img/Pellet51.jpg]


| Take the “pellet_fan_guide” and rout the print fan cable and hot end cables through the notches.

|

| 

| 

--------------------------
	
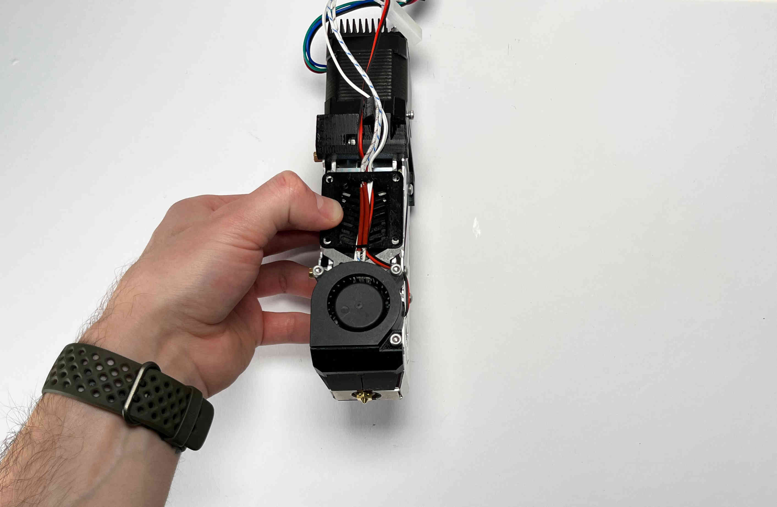
[picture p59: docs/source/tools/img/Pellet52.jpg]


| Place the fan guide on the extruder.

|

|

| 

| 

----------------------------
	
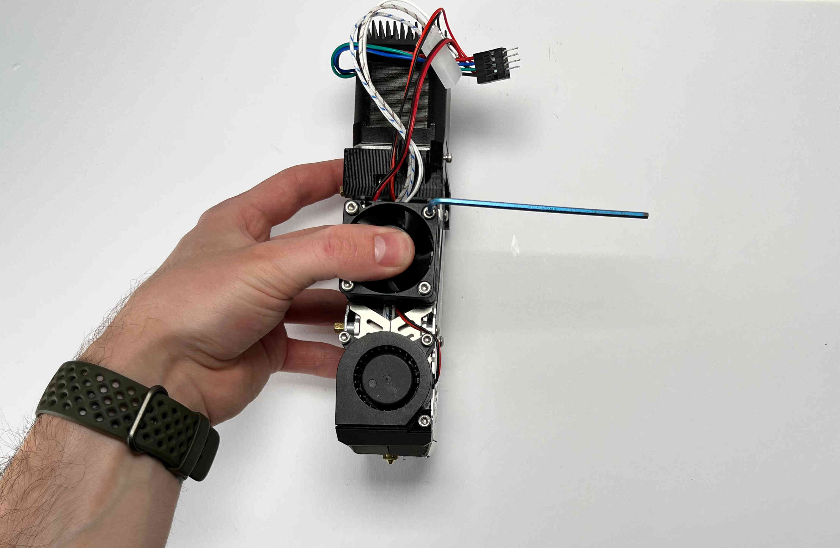
[picture p60: docs/source/tools/img/Pellet54.jpg]


| Place the fan on the fan guide making sure the cable is facing upwards and fasten using four M3 screws.

|

| 

| 

----------------------------

Receiver Plate
==============

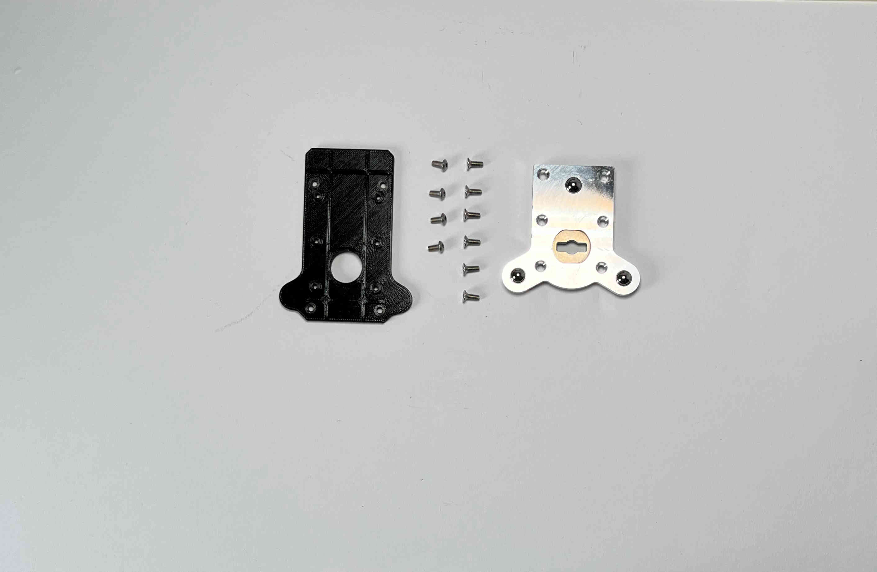
[picture p61: docs/source/tools/img/Pellet56.jpg]


| Prepare the “pellet_plate”, the M3 screws that were inserted into the standoffs, and the E3D Toolplate including its six countersunk mounting screws.

|

| 

| 

----------------------------

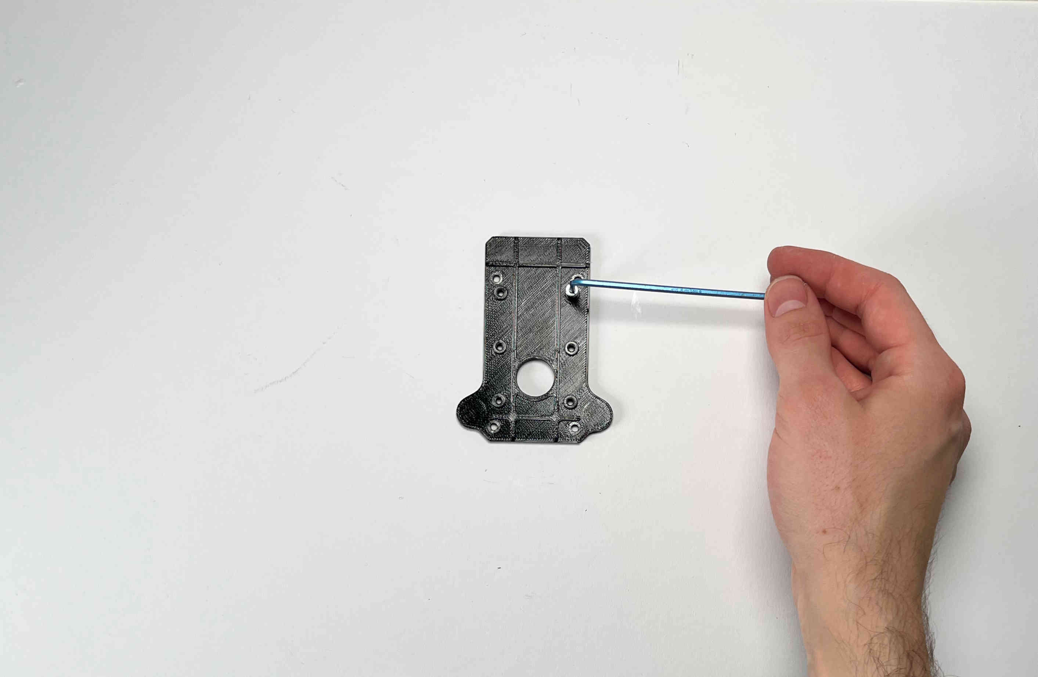
[picture p62: docs/source/tools/img/Pellet57.jpg]


| Tap into the plastic part using an M3 screw. (We recommend using a caphead screw to do this to avoid damaging the screw or allen key)

|

| 

| 

----------------------------

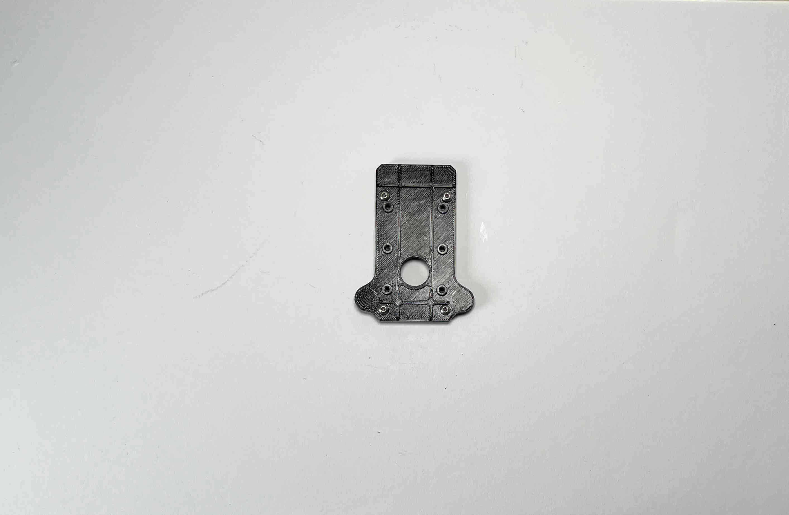
[picture p63: docs/source/tools/img/Pellet58.jpg]


| Insert the M3 screws from the pellet extruder in the pellet_plate.

|

| 

| 

----------------------------

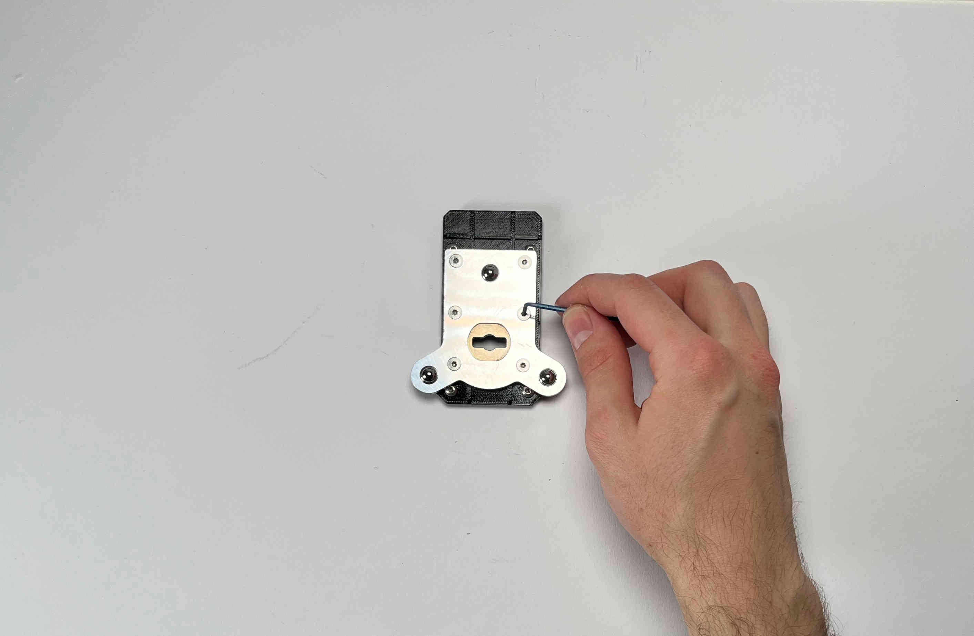
[picture p64: docs/source/tools/img/Pellet60.jpg]


| Place the toolplate on the pellet_plate and fasten it using the tapped holes and screws provided by E3D.

|

| 

| 

----------------------------

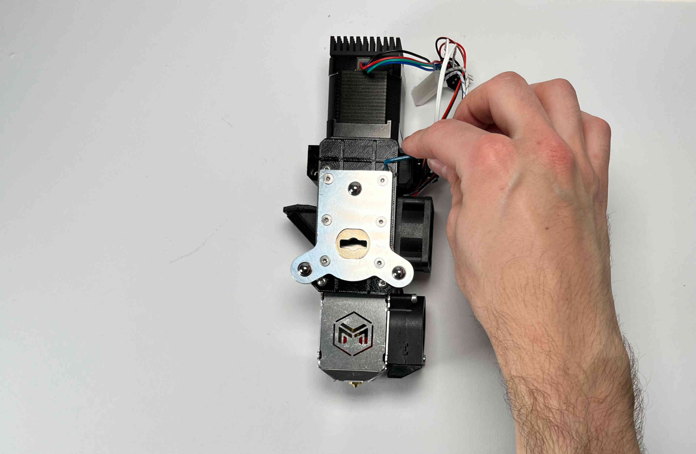
[picture p65: docs/source/tools/img/Pellet61.jpg]


| Fasten the plates onto the extruder using the standoffs. 

|

| 

| 

----------------------------

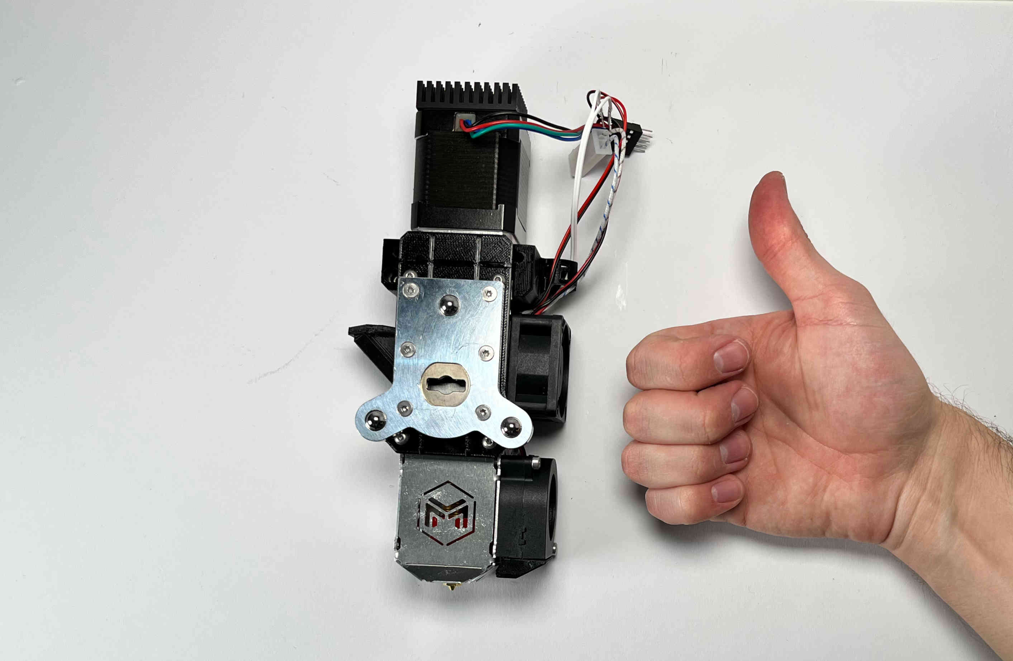
[picture p66: docs/source/tools/img/Pellet62a.jpg]


| Congratulations! Your Pellet Extruder V4 is ready to be mounted on the Hydra MK1.

|

| 

| 

----------------------------

We recommend shortening the cables and crimping connectors on the ends. This is so the printhead can easily be removed from the machine for maintenance.
