srl-ethz/hydra-documentation/docs/source/tools/hemera.rst

################################
E3D Hemera
################################

Please follow the hotend assembly instructions found `on the E3D website <https://e3d-online.zendesk.com/hc/en-us/articles/360017204078-Hemera-Direct-Assembly-Guide-New->`_ .
If you are using a different sized metal strip. You will have to modify the "bracket", "Cable relief", and "Parking spot" parts.

Main Tool
===========

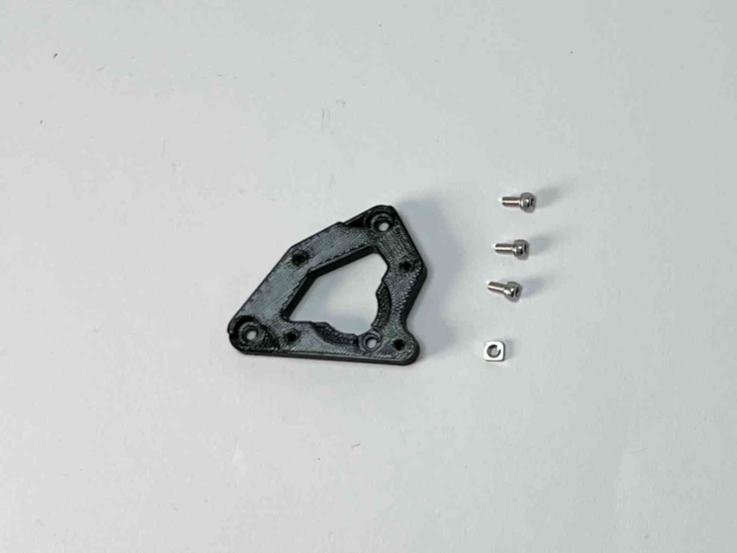
[picture p67: docs/source/tools/img/Hemera1.jpg]


| Prepare "Hemera adapter", three M3x6 caphead screws, and an M3 square nut.

|

| 

| 

| 

----------------------------

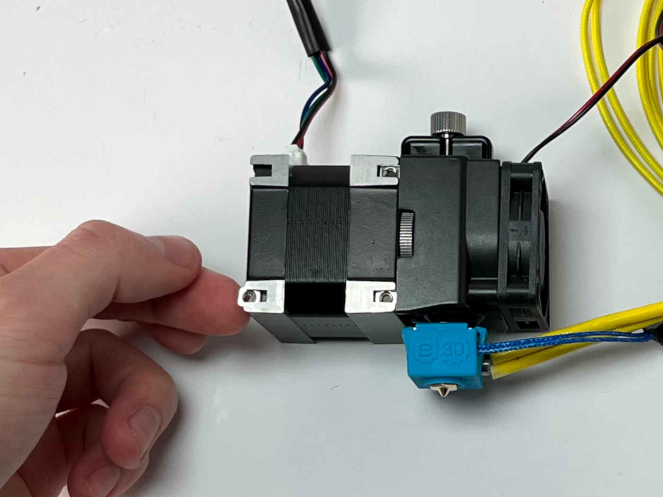
[picture p68: docs/source/tools/img/Hemera2.jpg]


| Insert the square nut into the T-slot on the extruder motor. Note the orientation of the assembly.

|

| 

| 

----------------------------

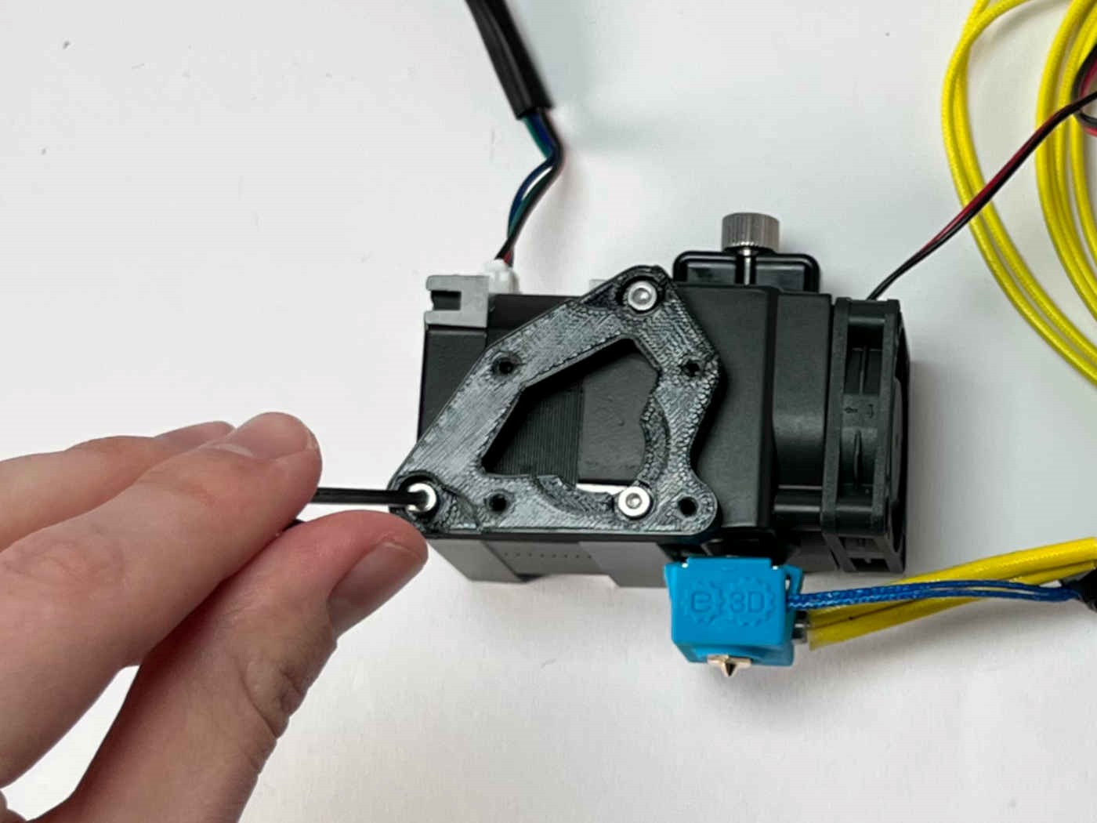
[picture p69: docs/source/tools/img/Hemera3.jpg]


| Fasten the adapter to the extruder motor using the M3 screws.

| 

| 

| 

----------------------------

.. WARNING:: Do not use longer screws! They could damage the extruder motor.

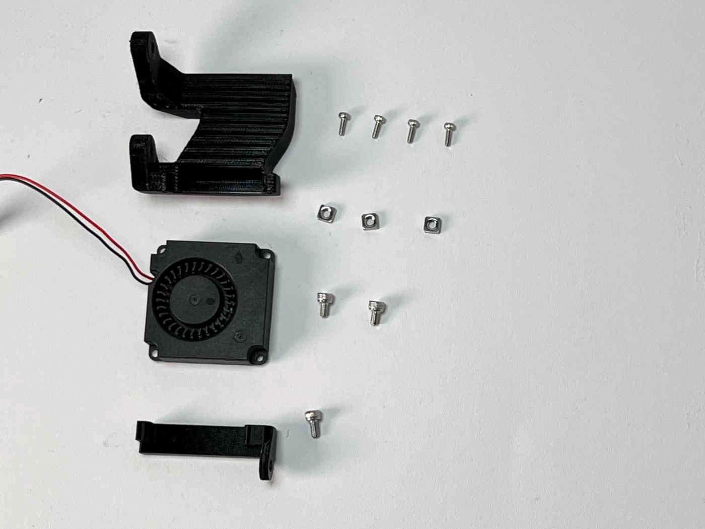
[picture p70: docs/source/tools/img/Hemera4.jpg]


| Prepare the print fan, the "PCF bracket", the "PCF duct", four M2x8 caphead screws, three M3 square nuts, two M3x5 caphead screws, and one M3x6 caphead screw.

| 

| 

| 

----------------------------

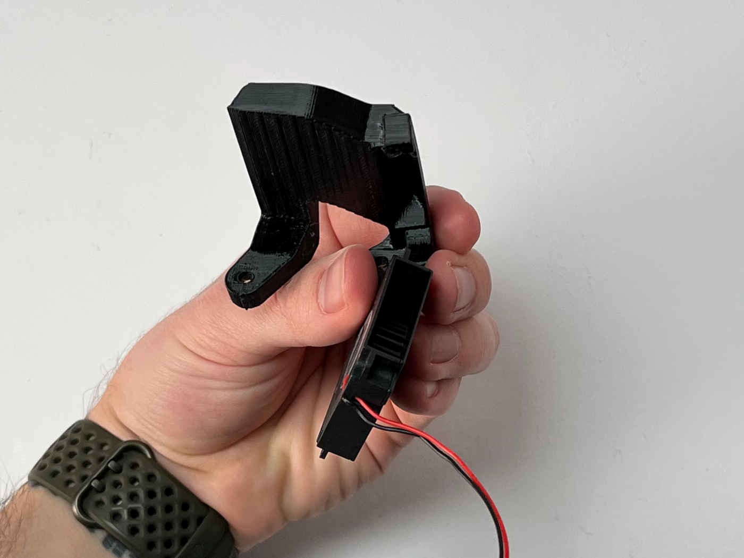
[picture p71: docs/source/tools/img/Hemera5.jpg]


| Note the orientation of the print fan.

| 

|

| 

| 

----------------------------

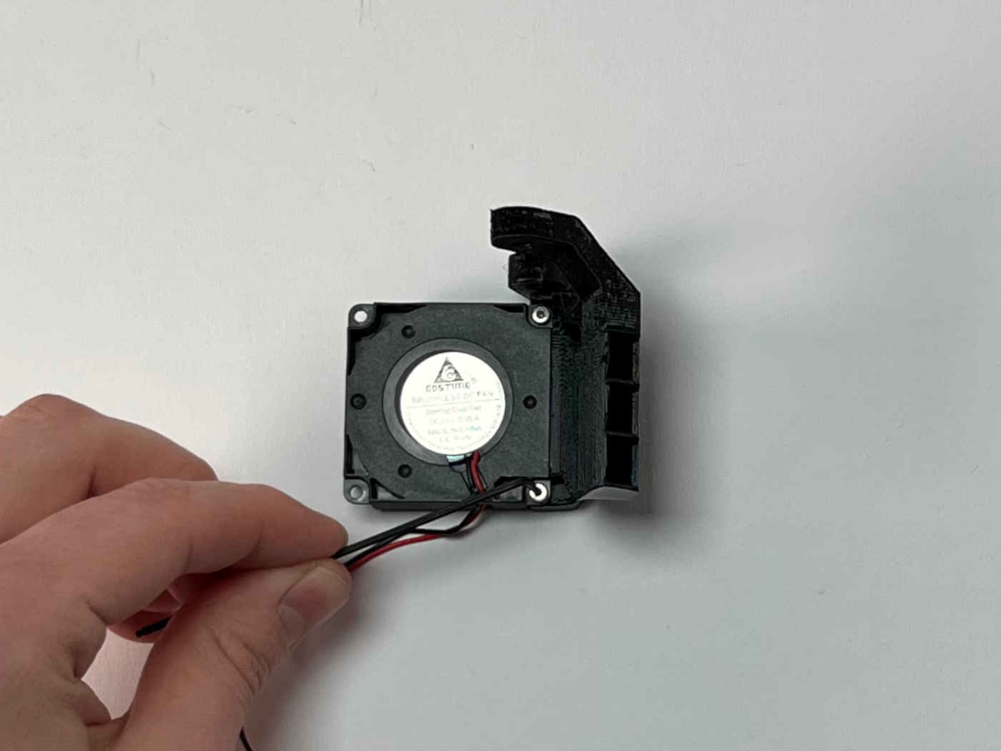
[picture p72: docs/source/tools/img/Hemera6.jpg]


| Attach the print fan to the PCF duct using two M2x8 screws. 

| 

| 

| 

|

----------------------------

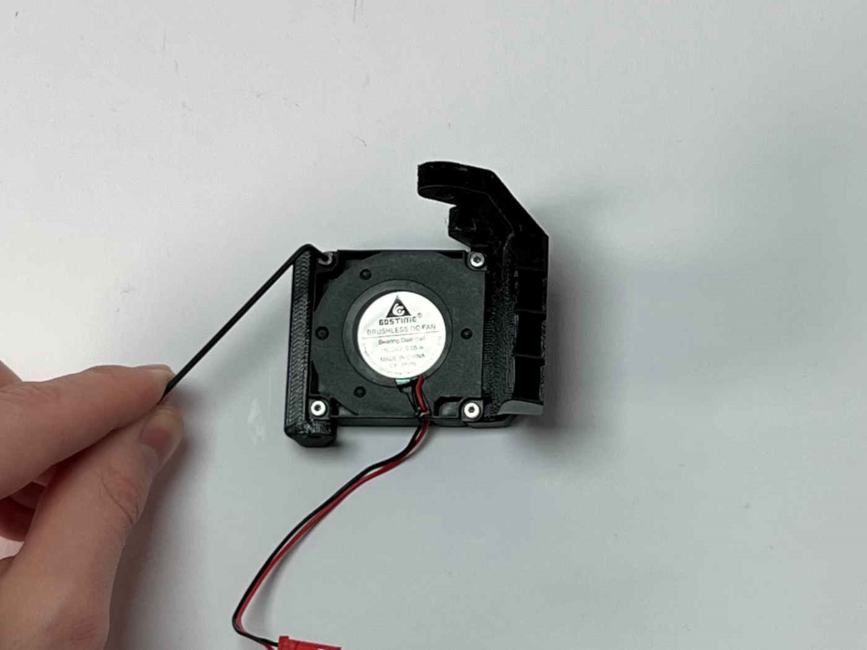
[picture p73: docs/source/tools/img/Hemera7.jpg]


| Attach the PCF bracket using two M2x8 screws.

| 

|

| 

| 

----------------------------

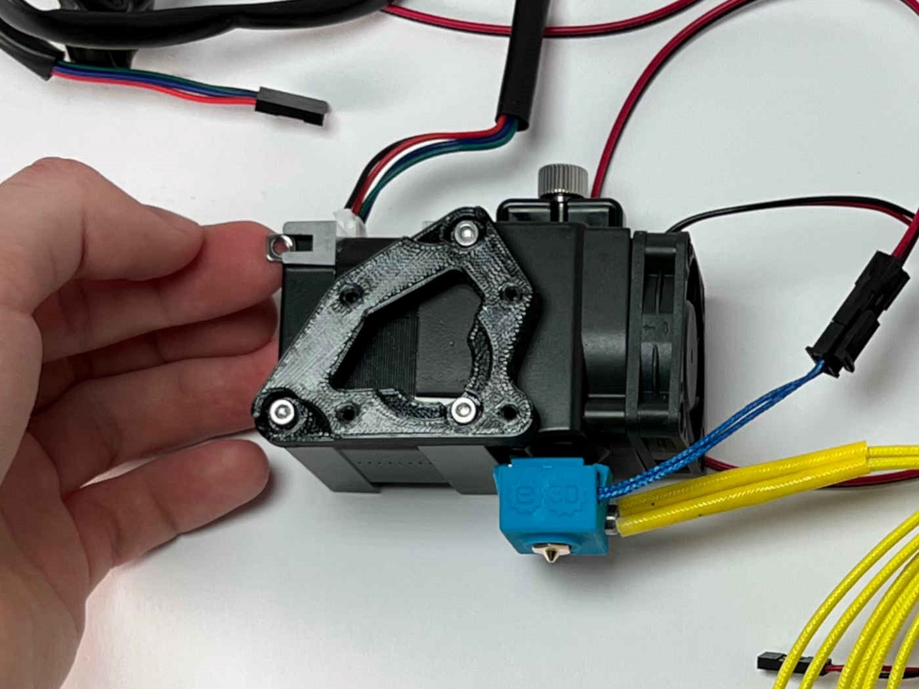
[picture p74: docs/source/tools/img/Hemera8.jpg]


| Insert the square nuts into the remaining T-slots on the extruder motor.

| 

| 

| 

|

----------------------------

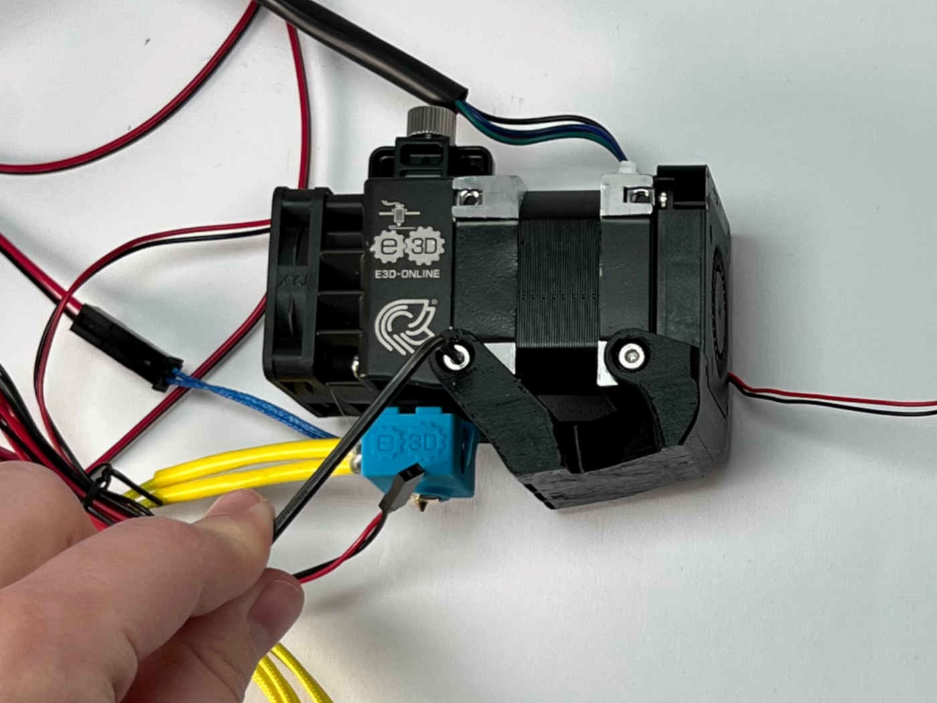
[picture p75: docs/source/tools/img/Hemera9.jpg]


| Attack the PCF duct to the extruder motor using two M3x5 screws.

| 

| 

|

| 

----------------------------

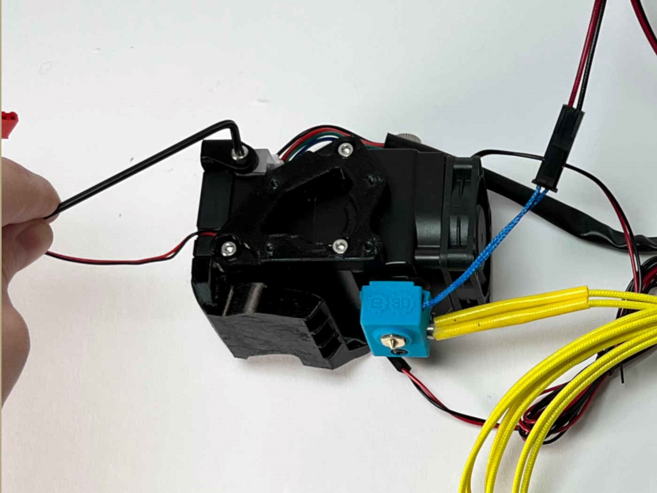
[picture p76: docs/source/tools/img/Hemera10.jpg]


| Attach the PCF bracket to the extruder motor using the M3x6 screw.

| 

| 

|

| 

----------------------------

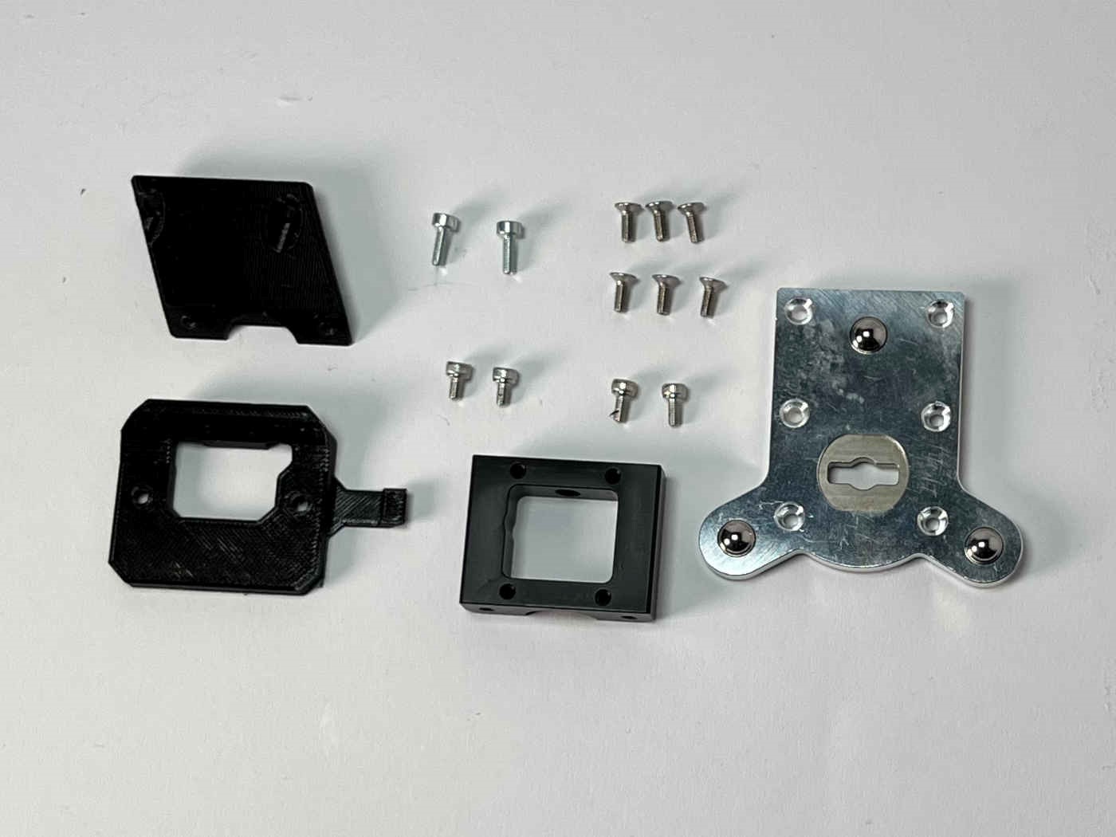
[picture p77: docs/source/tools/img/Hemera11.jpg]


| Prepare the Toolchanger Toolplate, including the six countersunk screws for fastening, the Toolchanger receiver, the "brace", the "bracket", two M3x8 caphead screws, two M3x6 caphead screws, and two M3x5 caphead screws.

| 

| 

----------------------------

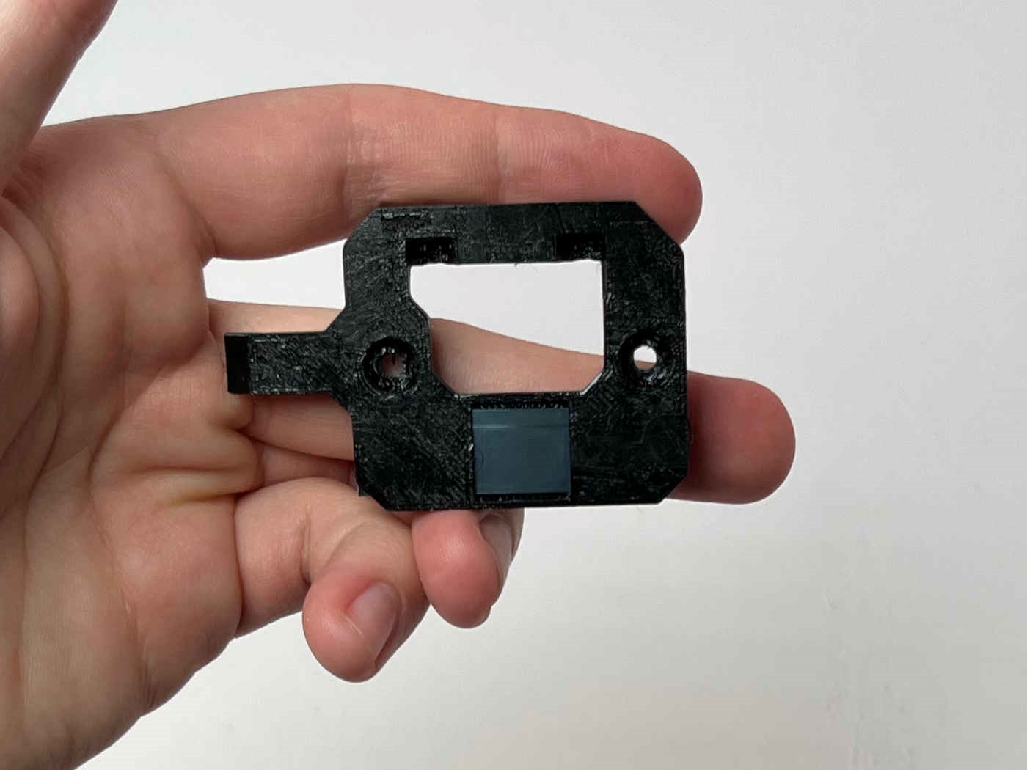
[picture p78: docs/source/tools/img/Hemera12.jpg]


| Insert a short length of the metal strip into the bracket part through the slot on the side. This will be used to hold the tool in its parked spot with a magnet.

| 

| 

| 

----------------------------

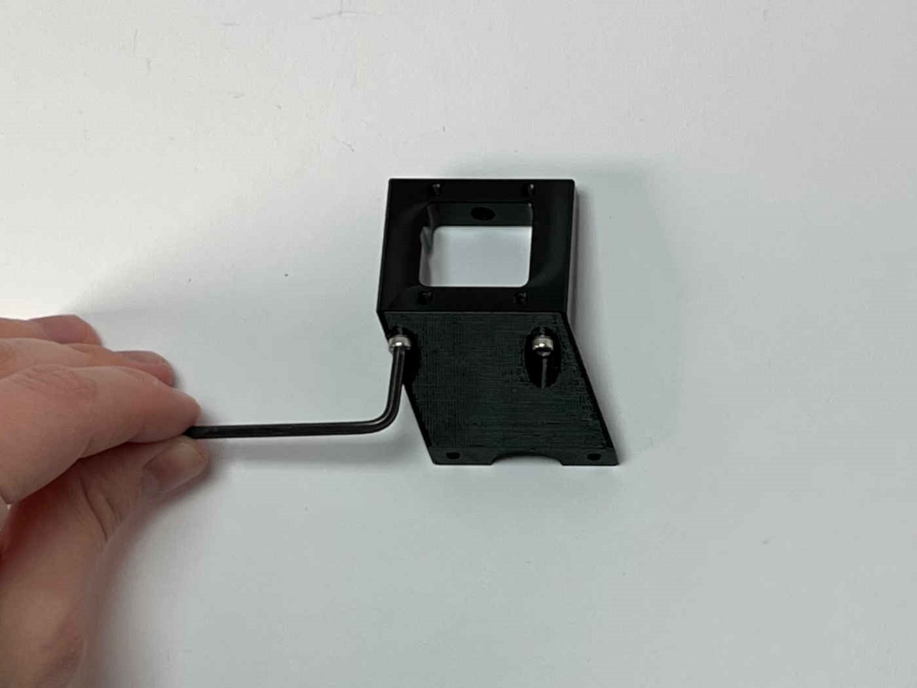
[picture p79: docs/source/tools/img/Hemera13.jpg]


| Attach the brace to the receiver using the two M3x6 screws.

| 

| 

| 

|

----------------------------

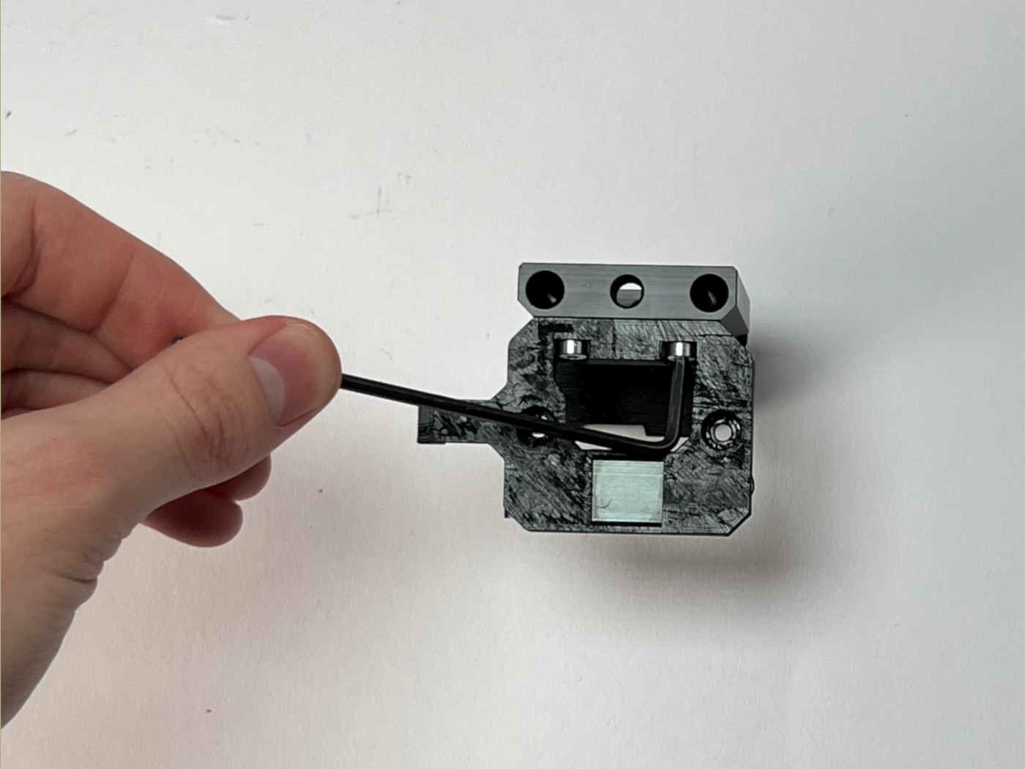
[picture p80: docs/source/tools/img/Hemera14.jpg]


| Attach the bracket to the receiver using the two M3x6 screws.

| 

| 

| 

|

----------------------------

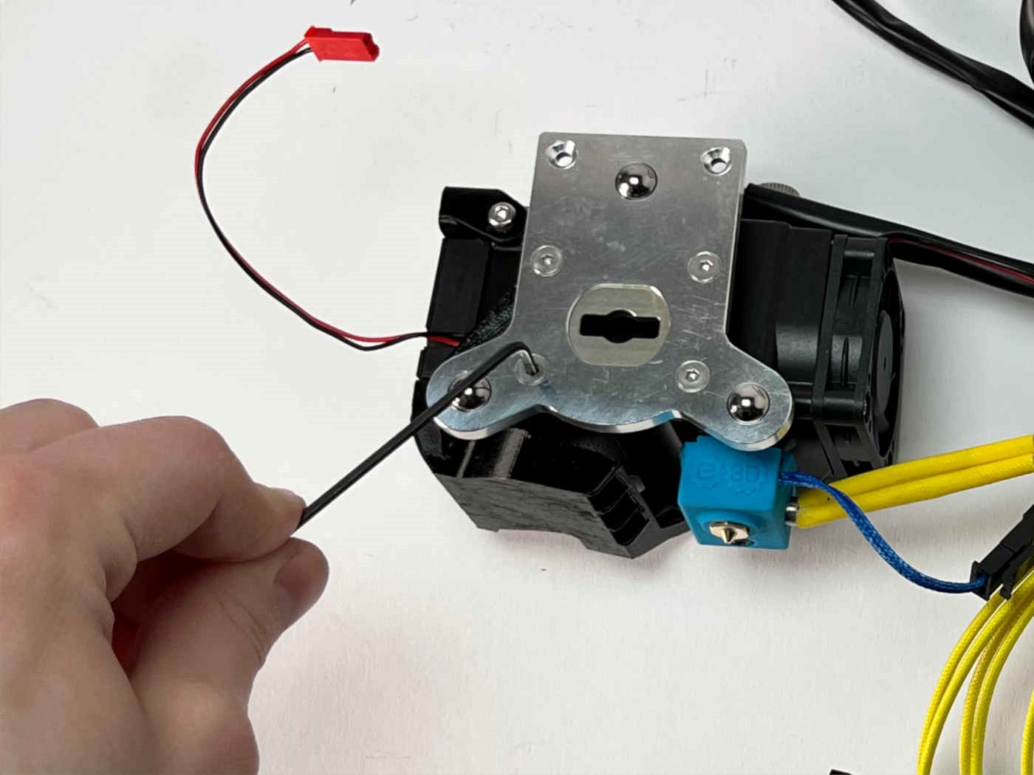
[picture p81: docs/source/tools/img/Hemera15.jpg]


| Attach the toolplate to the adapter using four of the provided countersunk screws.

| 

| 

|

| 

----------------------------

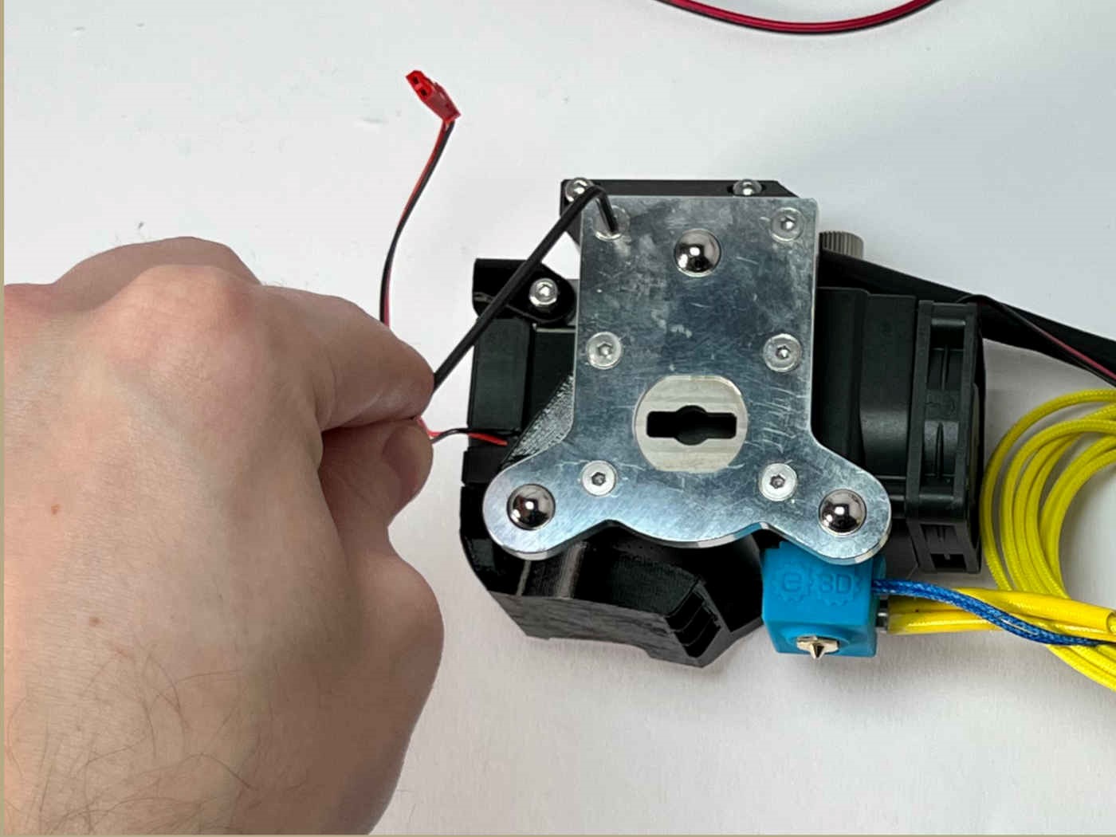
[picture p82: docs/source/tools/img/Hemera16.jpg]


| Attach the brace to the toolplate using the two remaining countersunk screws.

| 

| 

| 

|

----------------------------

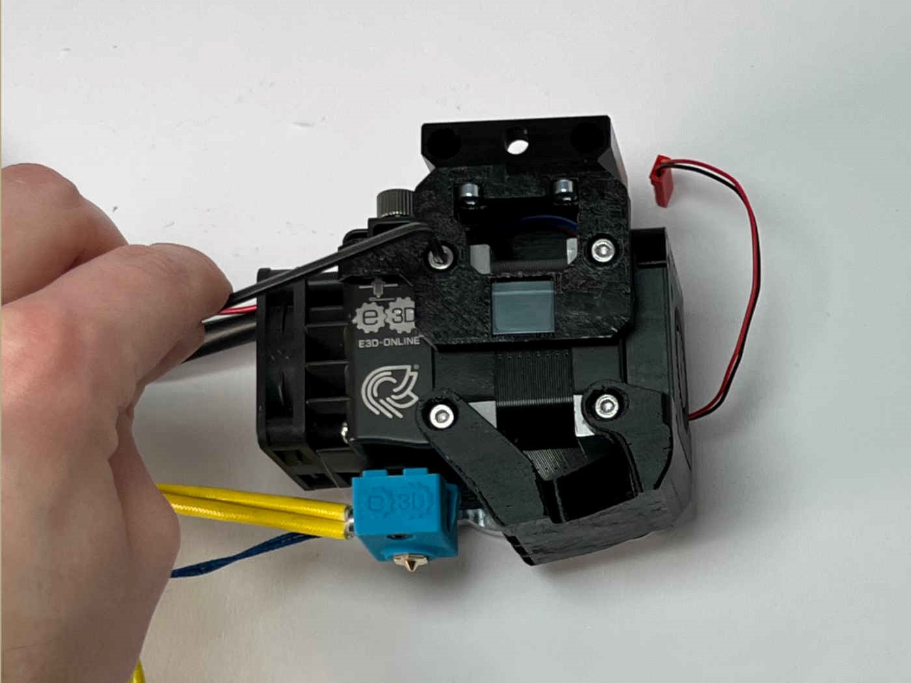
[picture p83: docs/source/tools/img/Hemera17.jpg]


| Attach the bracket to the extruder moto using the two M3x5 screws.

| 

| 

| 

|

----------------------------

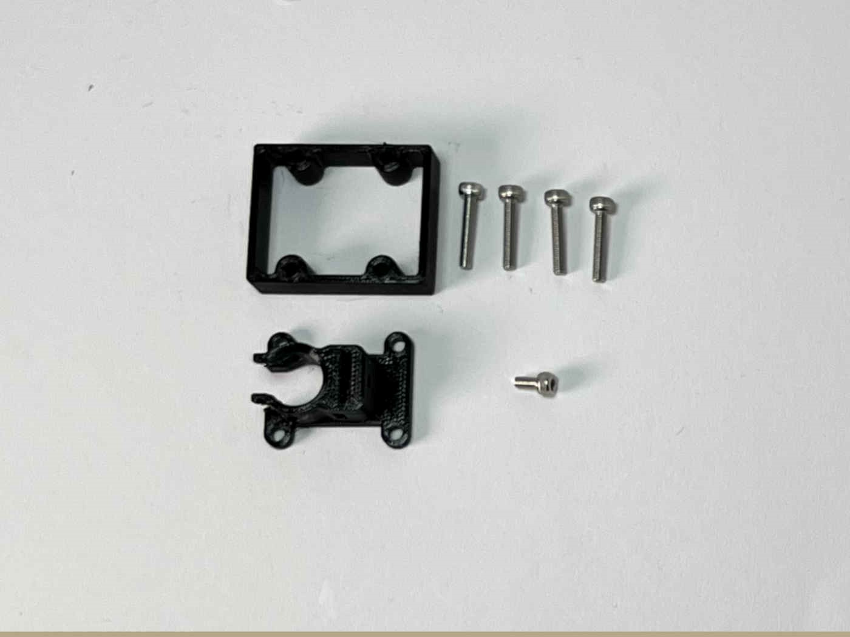
[picture p84: docs/source/tools/img/Hemera18.jpg]


| Prepare the "Receiver Top", the "Cable Relief", Four M3x16 caphead screws, and one M3x5 caphead screw.

| 

| 

| 

----------------------------

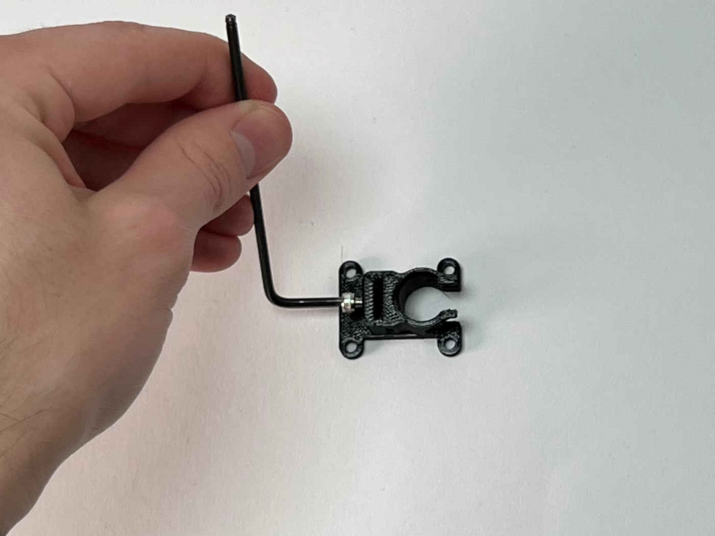
[picture p85: docs/source/tools/img/Hemera19.jpg]


| Tap the M3x5 screw into the cable relief. This will be used to hold the metal strip later.

| 

|

| 

| 

----------------------------

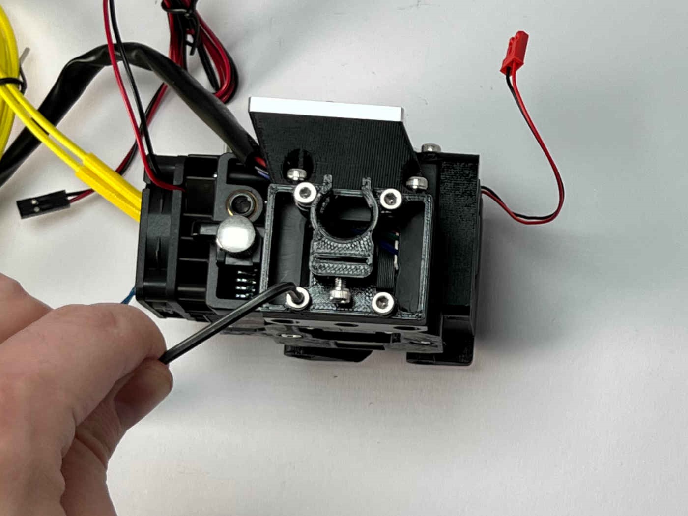
[picture p86: docs/source/tools/img/Hemera20.jpg]


| Attach the cable relief on top of the receiver top to the receiver using the four M3x16 screws. note the orientation of the cable relief. The slot for the metal strip should be facing away from the toolplate.

| 

| 

| 

Parking spot
====================

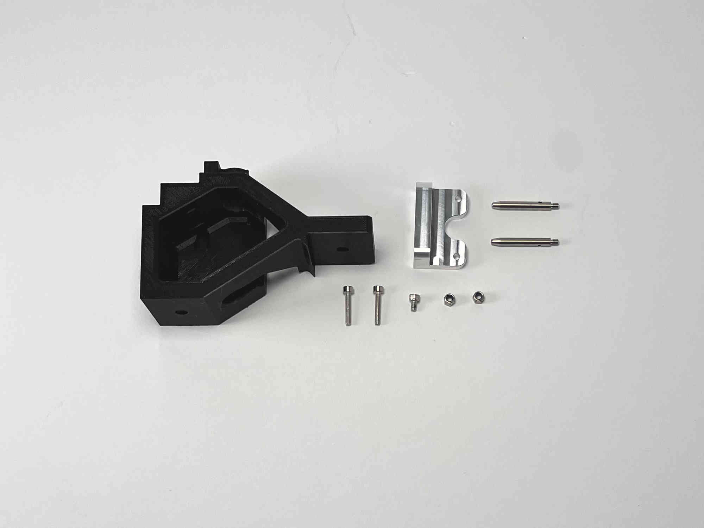
[picture p87: docs/source/tools/img/HemeraPark1.jpg]


| Prepare the "Hemera_Parking_spot", one M3x5 caphead screw, two m3 locking nuts, the parking bracket, two pins, the small magnet, and two M3x16 screws (The last four items are included in the "blank toolplate and dock" kit from E3D).

| 

| 

----------------------------

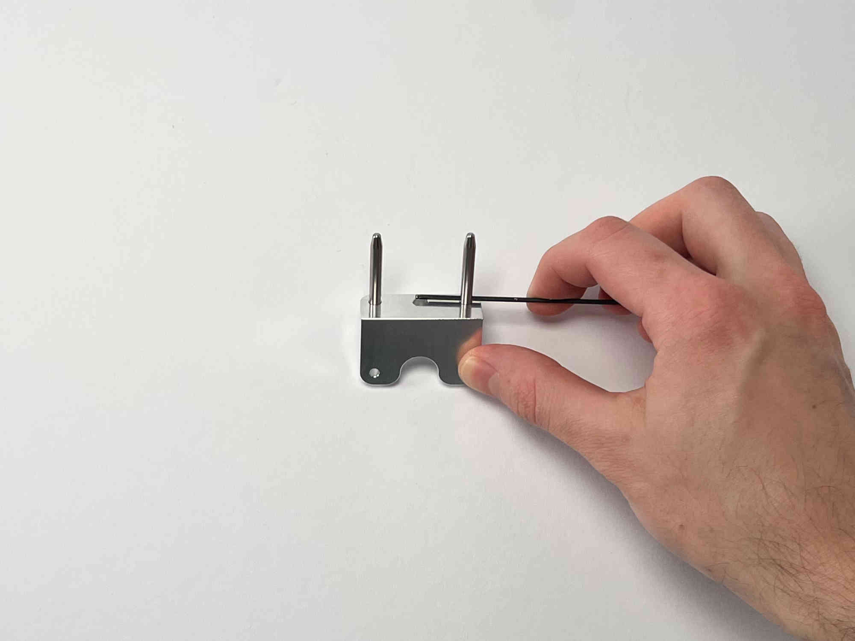
[picture p88: docs/source/tools/img/HemeraPark2.jpg]


| Attach the two pins to the bracket and tighten by slotting a small allenkey through the hole in the pin.

| 

| 

| 

----------------------------

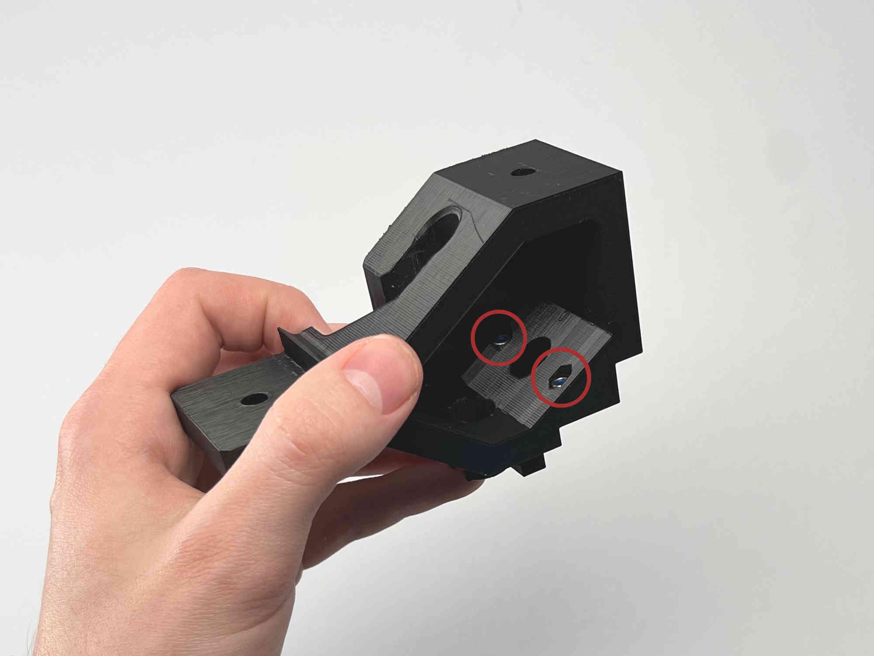
[picture p89: docs/source/tools/img/HemeraPark3.jpg]


| Insert the two M3 nuts into the slots on the parking spot.

| 

|

| 

| 

----------------------------

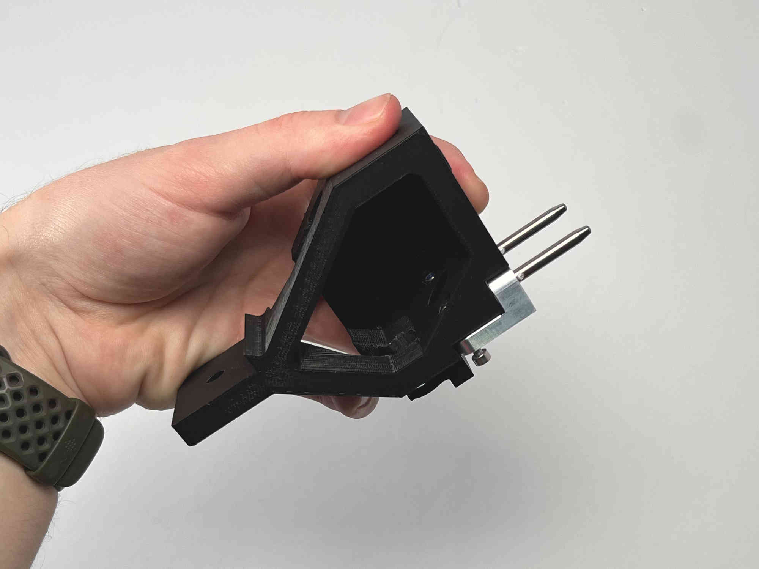
[picture p90: docs/source/tools/img/HemeraPark4.jpg]


| While still holding the part upside down attach the bracket by inserting the two M3x16 screws.

| 

|

| 

| 

----------------------------

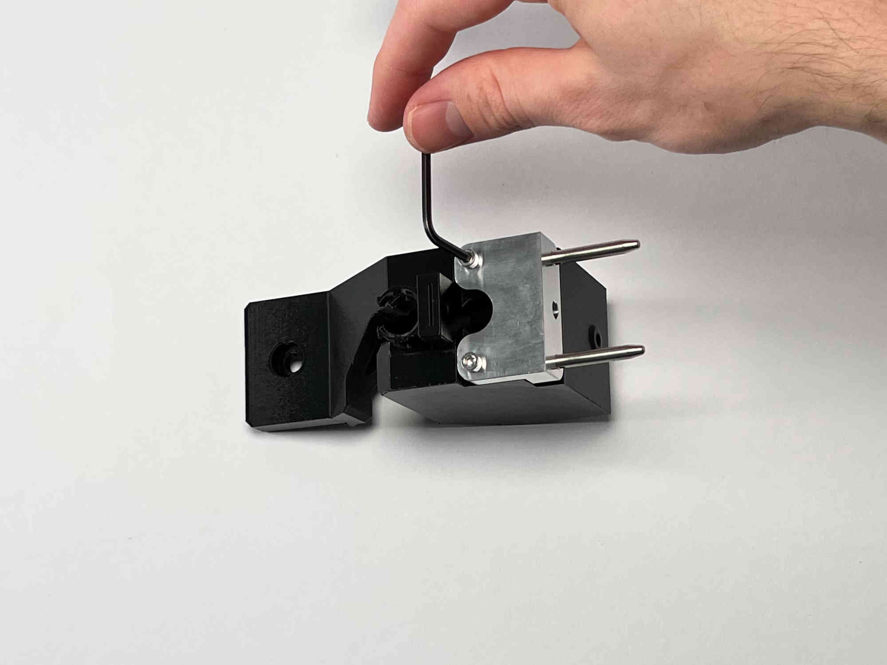
[picture p91: docs/source/tools/img/HemeraPark5.jpg]


| Tighten the M3 screws.

|

| 

| 

| 

----------------------------

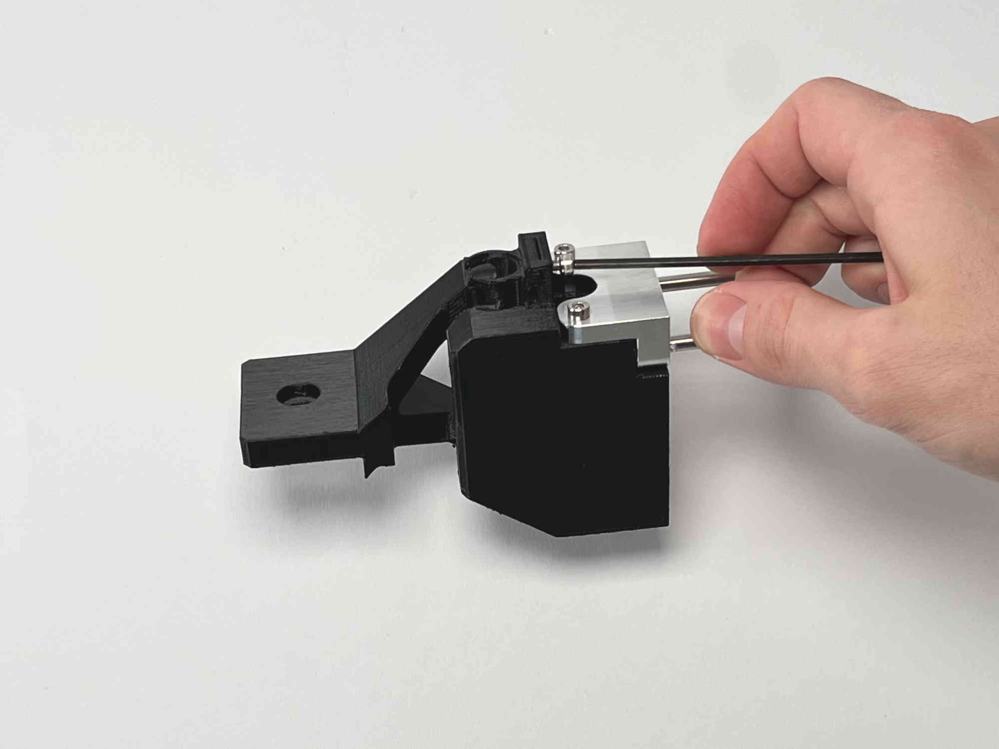
[picture p92: docs/source/tools/img/HemeraPark6.jpg]


| Thread the M3x5 screw into the top of the part. This will later be used to clamp the cable brace.

| 

|

| 

| 

----------------------------

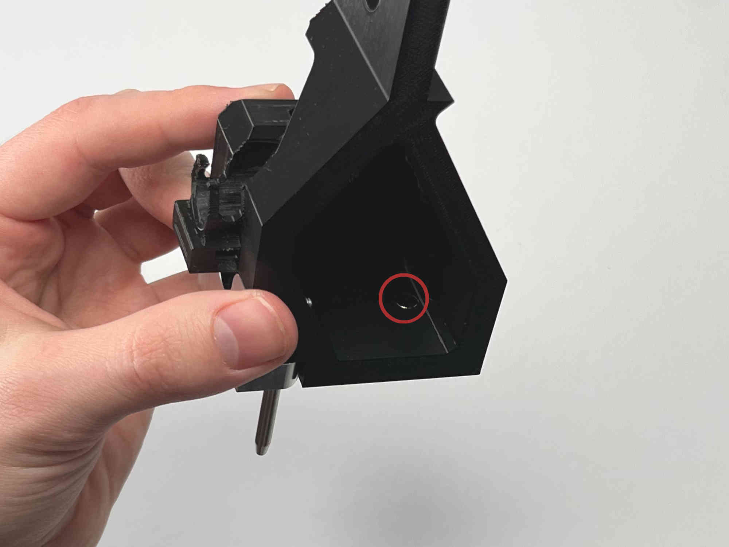
[picture p93: docs/source/tools/img/HemeraPark7.jpg]


| Insert the magnet into the slot in the middle of the part.

| 

| 

|

| 

----------------------------

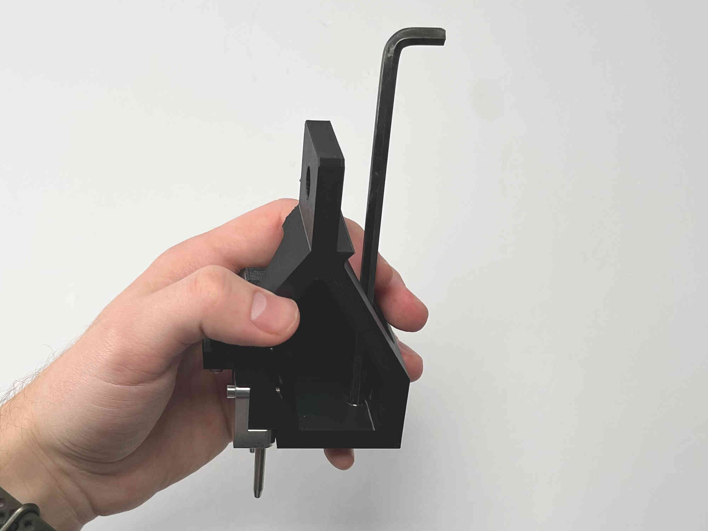
[picture p94: docs/source/tools/img/HemeraPark8.jpg]


| Press the magnet all the way to the front. This can easily be done by using an allenkey or similar object.

| 

| 

| 

----------------------------

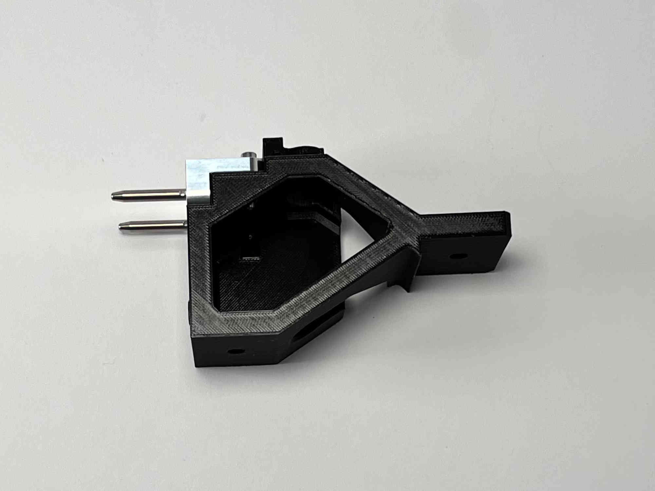
[picture p95: docs/source/tools/img/HemeraPark9.jpg]


| You are now ready to mount the parking spot on the machine. Please follow the guide in the RatRig assembly.

| 

| 

|
