srl-ethz/hydra-documentation/docs/source/intro/img/HydraIso.png

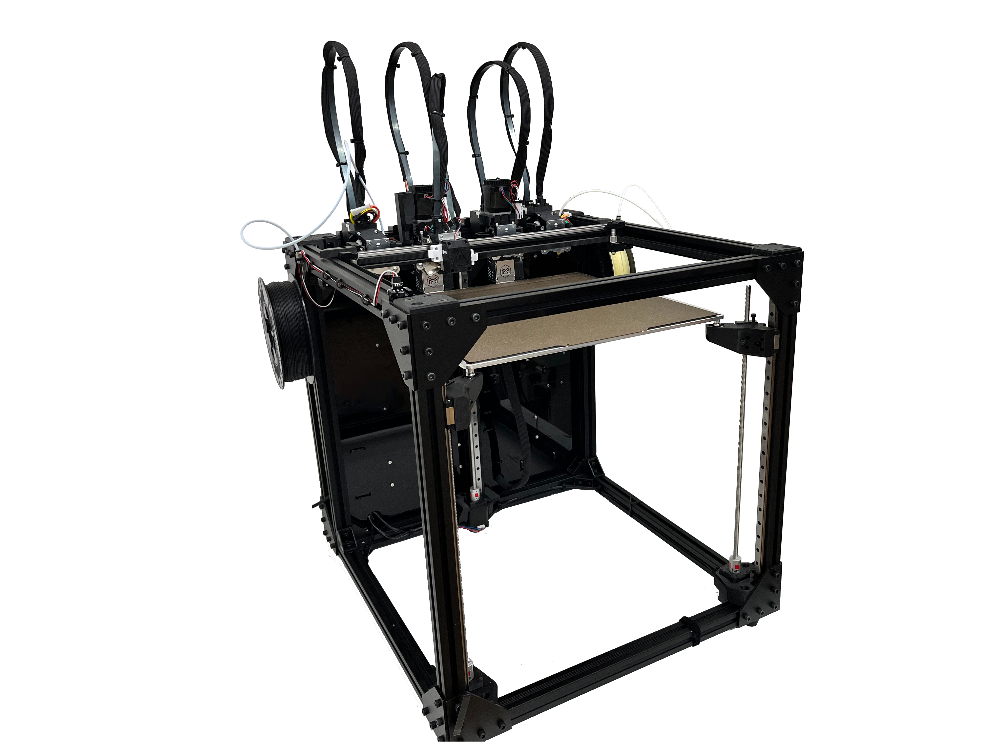
docs/source/intro/img/HydraIso.png
