srl-ethz/hydra-documentation/docs/source/tools/img/Pellet8.jpg

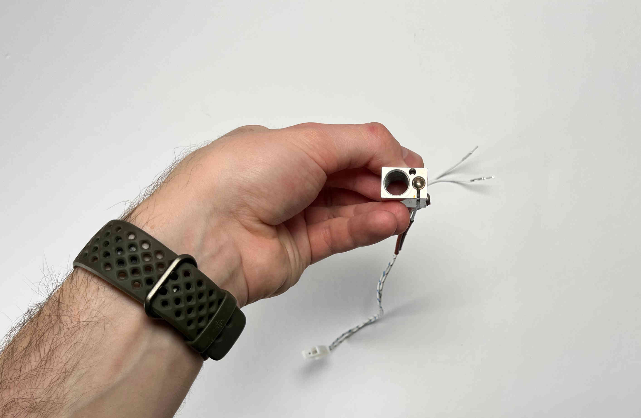
docs/source/tools/img/Pellet8.jpg
