srl-ethz/hydra-documentation/docs/source/tools/img/Pellet19.jpg

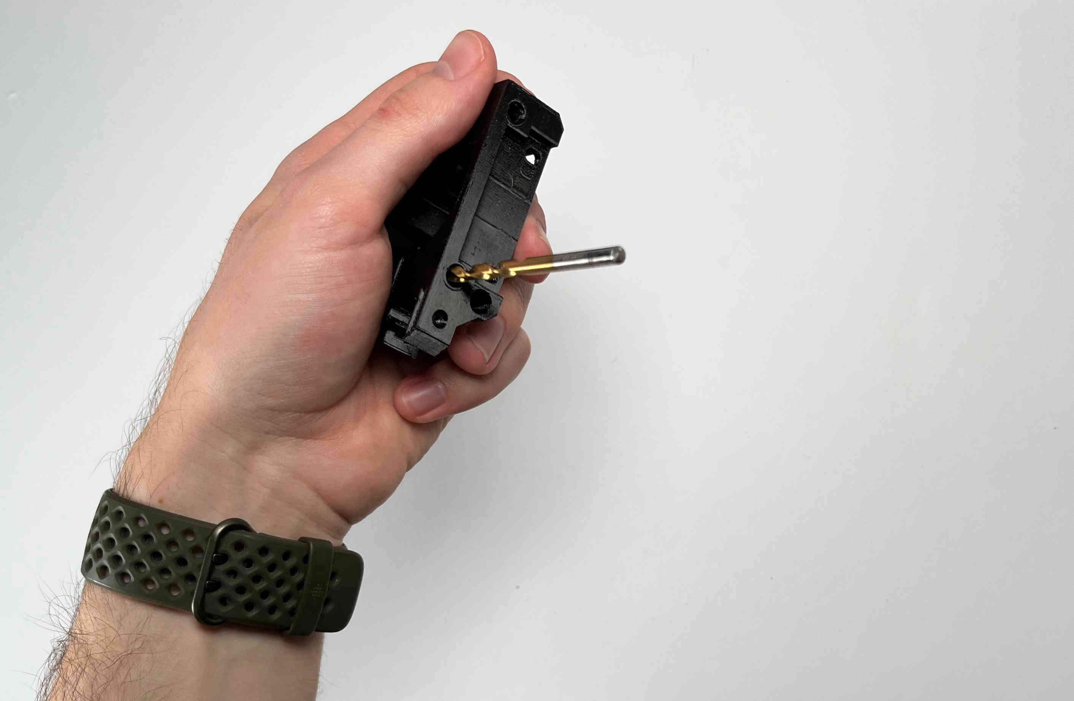
docs/source/tools/img/Pellet19.jpg
