srl-ethz/hydra-documentation/docs/source/tools/img/Pellet23.jpg

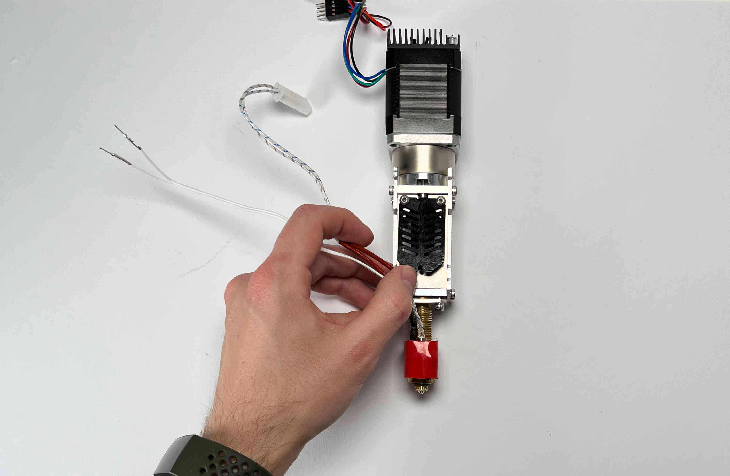
docs/source/tools/img/Pellet23.jpg
