srl-ethz/hydra-documentation/docs/source/tools/img/Pellet26.jpg

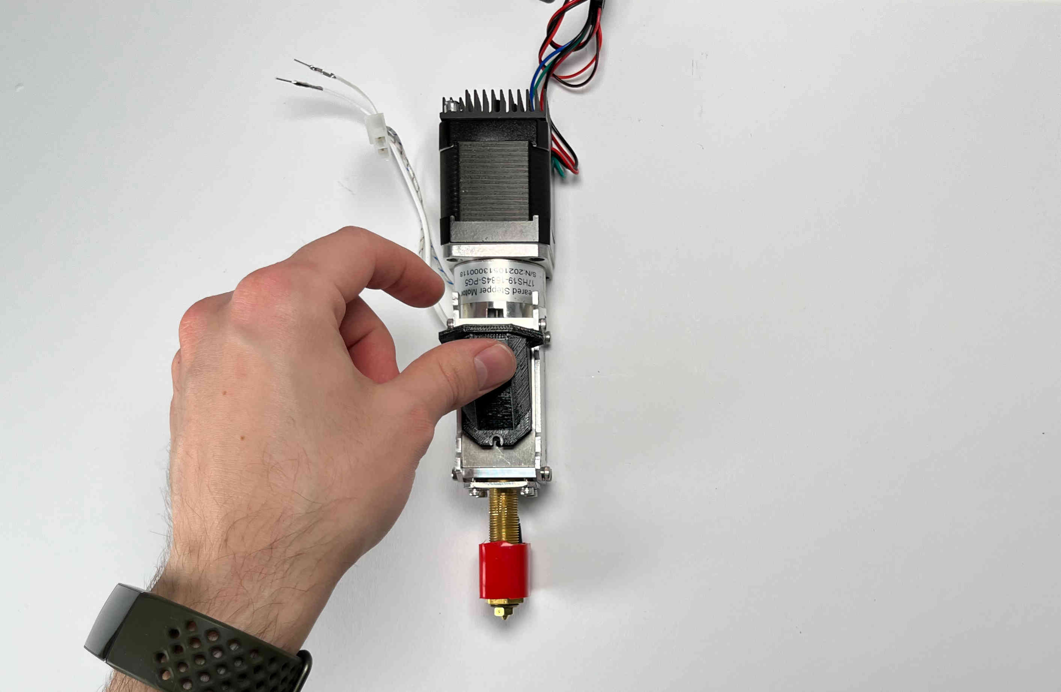
docs/source/tools/img/Pellet26.jpg
