srl-ethz/hydra-documentation/docs/source/tools/img/Pellet34.jpg

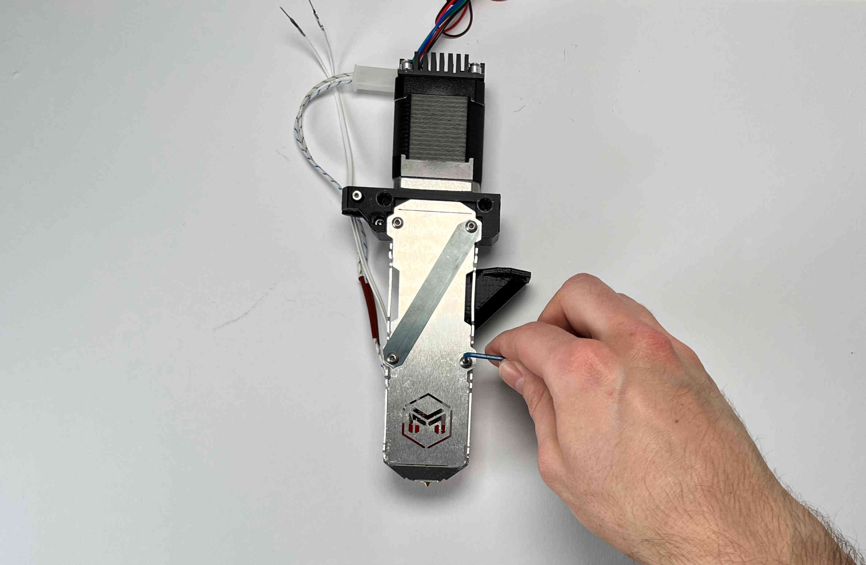
docs/source/tools/img/Pellet34.jpg
