srl-ethz/hydra-documentation/docs/source/tools/img/Pellet49.jpg

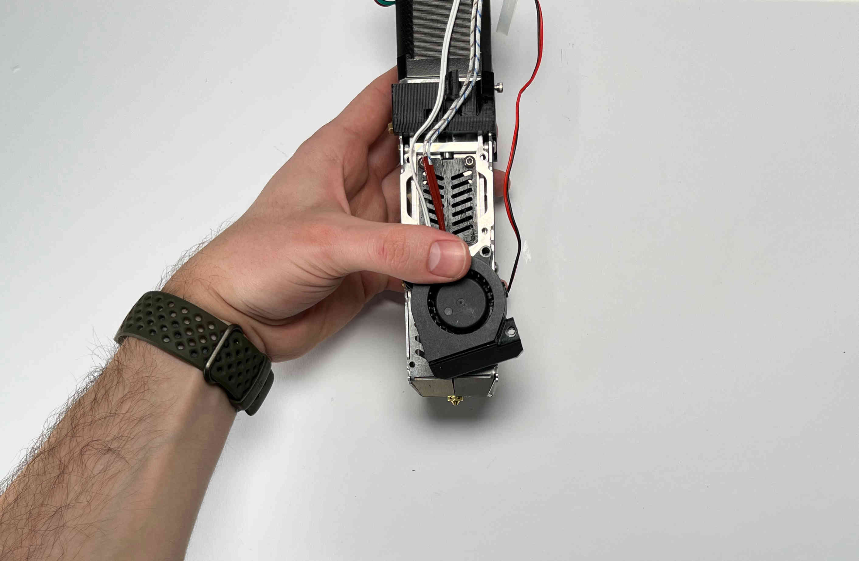
docs/source/tools/img/Pellet49.jpg
