srl-ethz/hydra-documentation/docs/source/tools/img/Pellet53.jpg

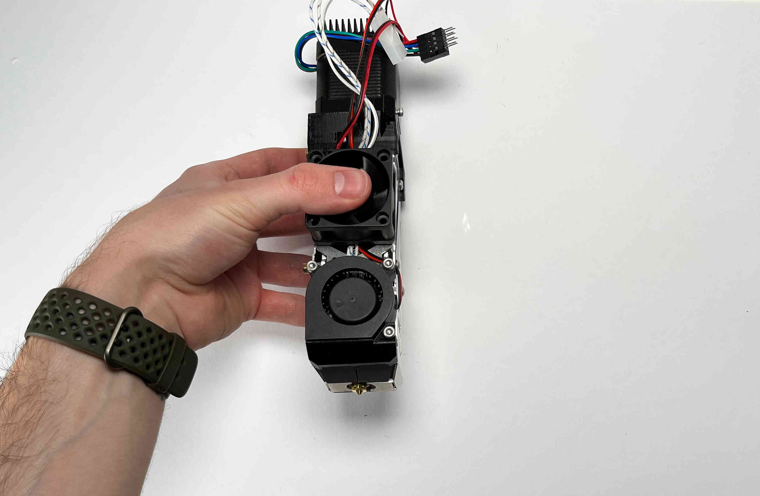
docs/source/tools/img/Pellet53.jpg
