srl-ethz/hydra-documentation/docs/source/tools/img/Pellet55.jpg

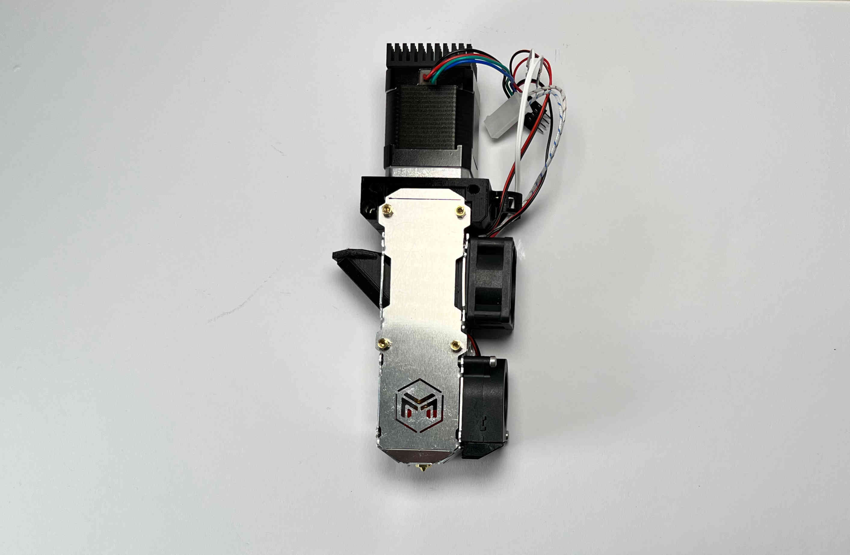
docs/source/tools/img/Pellet55.jpg
