srl-ethz/hydra-documentation/docs/source/tools/img/Pellet59.jpg

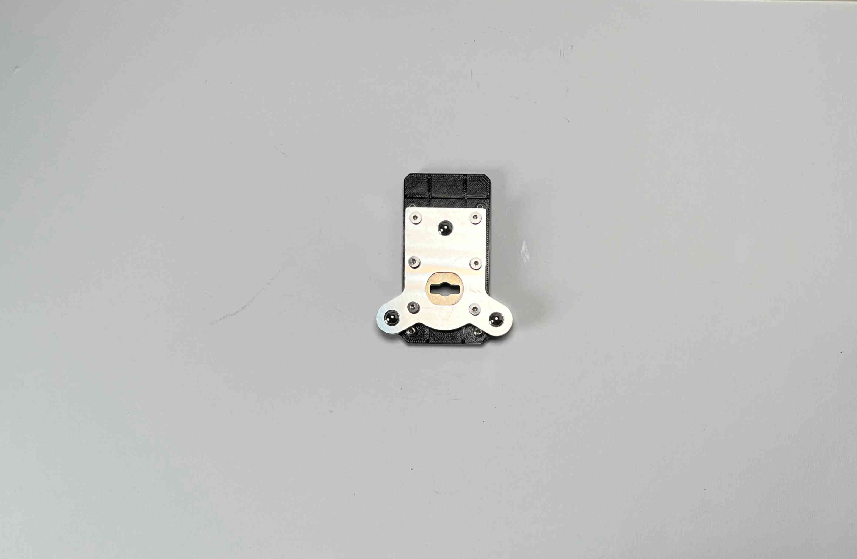
docs/source/tools/img/Pellet59.jpg
