srl-ethz/hydra-documentation/docs/source/tools/img/Pellet62b.jpg

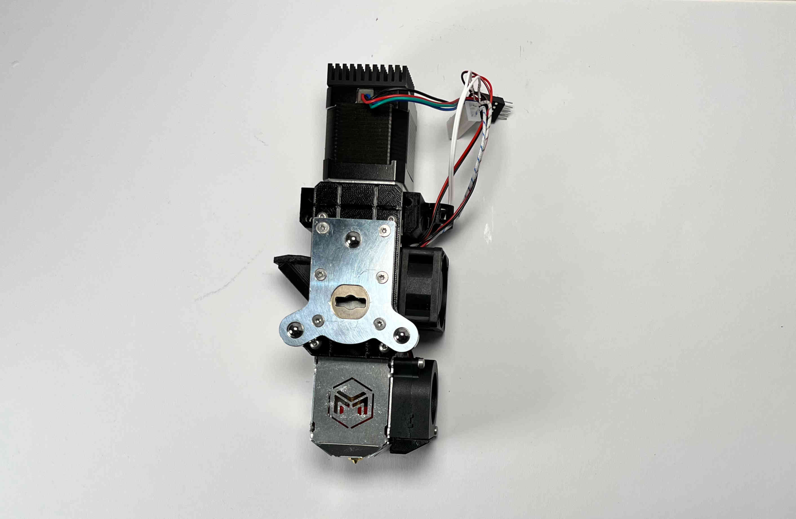
docs/source/tools/img/Pellet62b.jpg
