srl-ethz/hydra-documentation/CAD/Machined Parts/V4_PelletClamp_TD.pdf

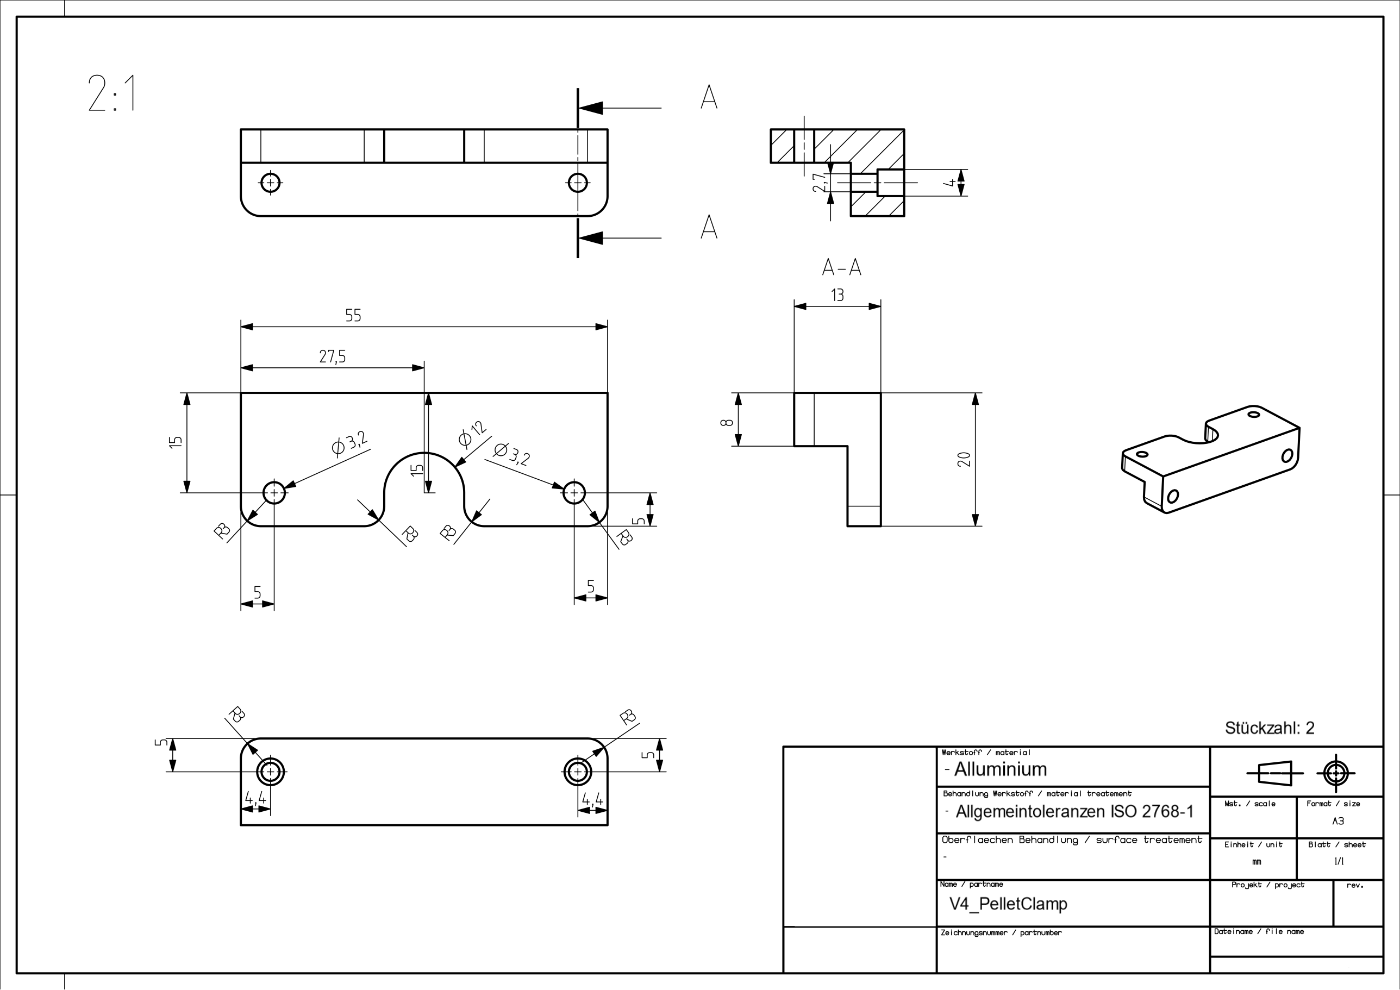
[picture p112: page 1]
