srl-ethz/hydra-documentation/CAD/Machined Parts/TC_Plate.step

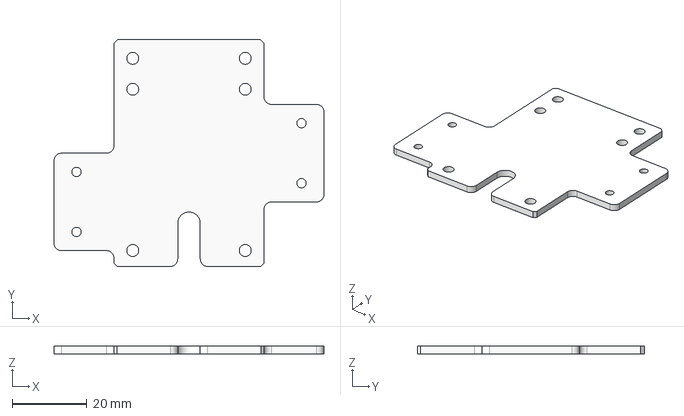
[picture p113: CAD file, 2022-01-28]
CAD/Machined Parts/TC_Plate.step
72.0 x 60.5 x 2.00 mm
