srl-ethz/hydra-documentation/CAD/STLs/TC_Top_Block.stl

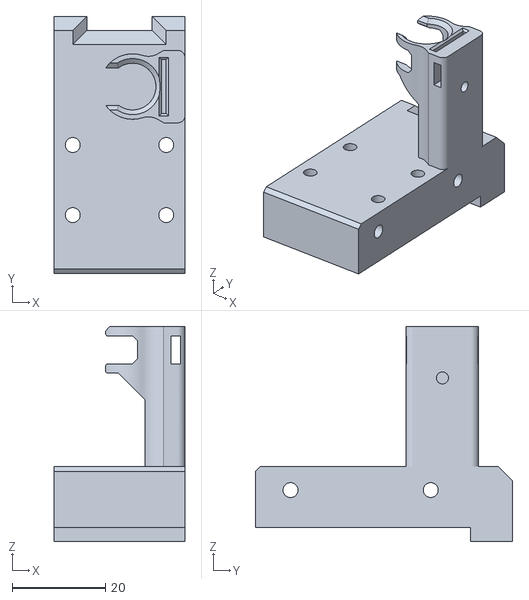
[picture p114: CAD file, 2022-02-17]
CAD/STLs/TC_Top_Block.stl
28.0 x 55.0 x 46.0
