srl-ethz/hydra-documentation/Calibration/X_Y_Calibration_Comb.stl

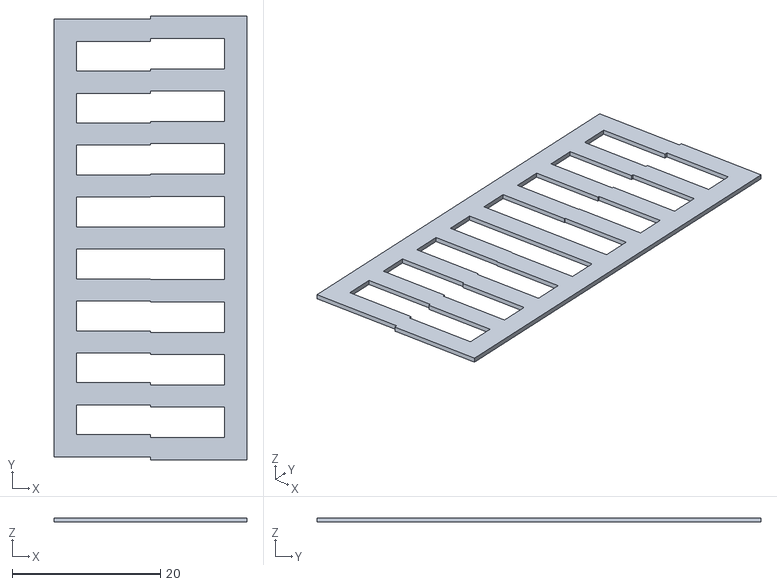
[picture p115: CAD file, 2022-02-28]
Calibration/X_Y_Calibration_Comb.stl
26.0 x 59.8 x 0.6
