srl-ethz/hydra-documentation/CAD/Machined Parts/V4_PelletClamp.step

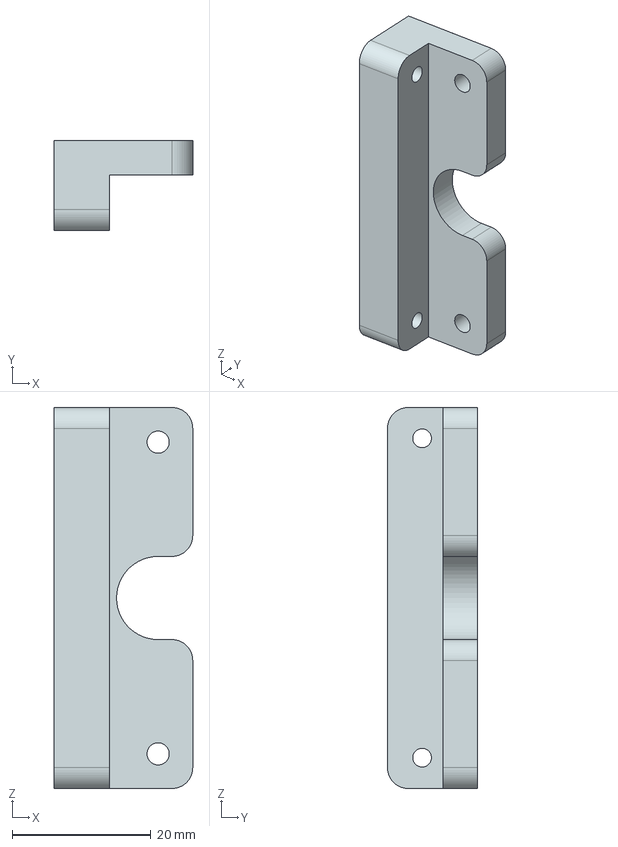
[picture p116: CAD file, 2022-01-28]
CAD/Machined Parts/V4_PelletClamp.step
20.0 x 13.0 x 55.0 mm
