srl-ethz/hydra-documentation/CAD/STLs/Hemera_PCF_Bracket.stl

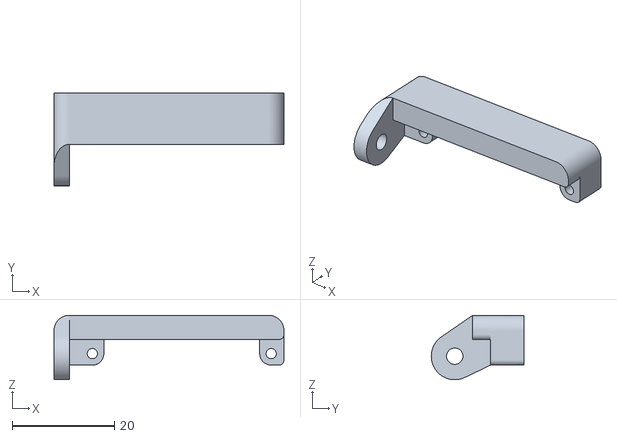
[picture p117: CAD file, 2022-02-17]
CAD/STLs/Hemera_PCF_Bracket.stl
45.0 x 18.1 x 12.6
