srl-ethz/hydra-documentation/CAD/Machined Parts/TC_Shaft.step

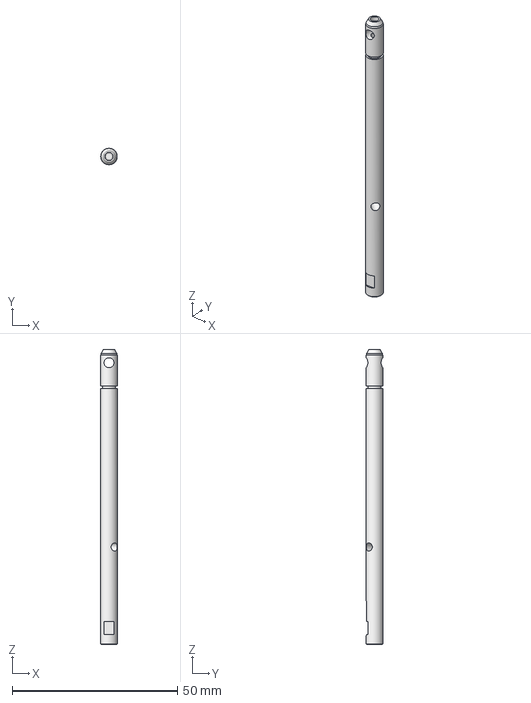
[picture p118: CAD file, 2022-01-28]
CAD/Machined Parts/TC_Shaft.step
5.00 x 5.00 x 89.2 mm
