srl-ethz/hydra-documentation/CAD/STLs/TC_Tensioner.stl

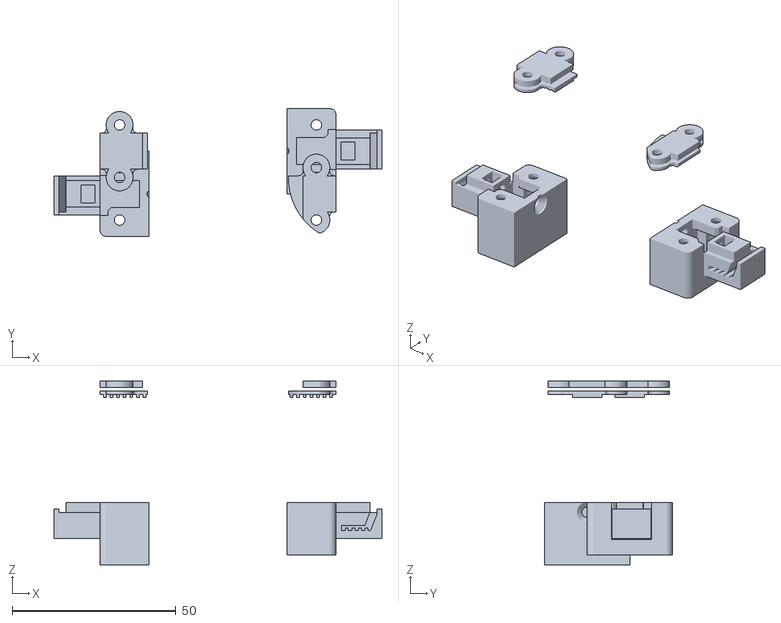
[picture p119: CAD file, 2022-02-17]
CAD/STLs/TC_Tensioner.stl
100.0 x 39.0 x 56.0
