srl-ethz/hydra-documentation/CAD/STLs/V4_Plate.stl

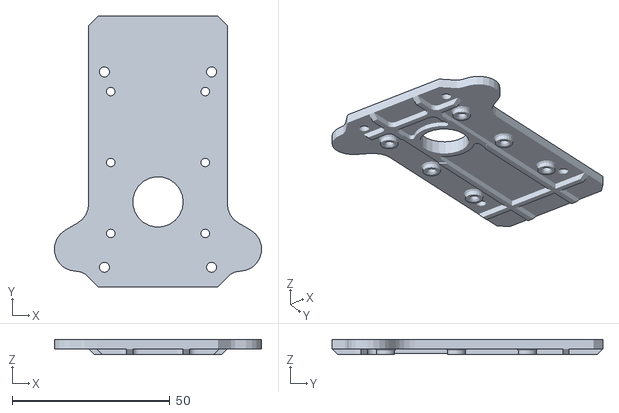
[picture p120: CAD file, 2022-02-17]
CAD/STLs/V4_Plate.stl
65.7 x 86.0 x 4.80
