srl-ethz/hydra-documentation/CAD/STLs/V4_Hopper.stl

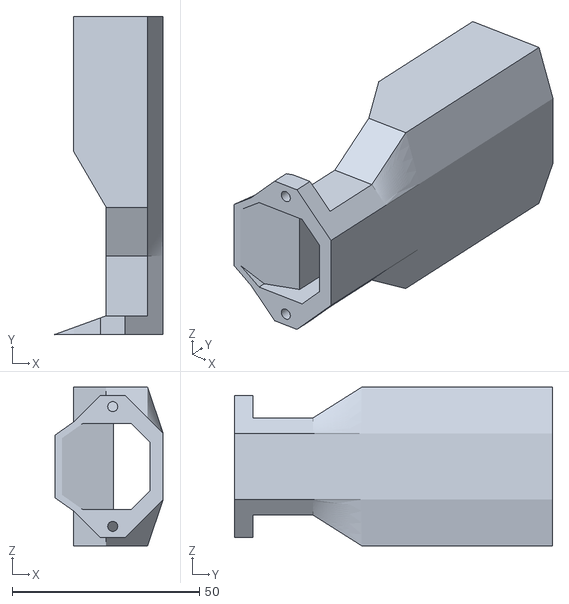
[picture p121: CAD file, 2022-02-17]
CAD/STLs/V4_Hopper.stl
29.0 x 85.0 x 42.4
