srl-ethz/hydra-documentation/CAD/STLs/TC_Brace.stl

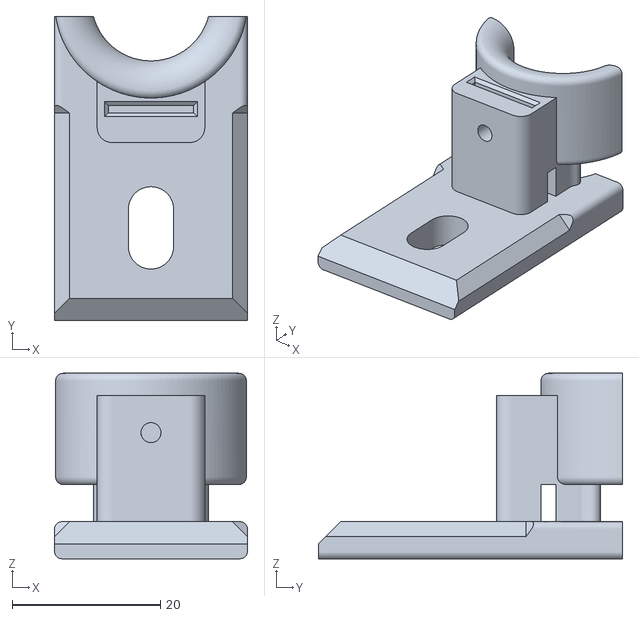
[picture p122: CAD file, 2022-02-17]
CAD/STLs/TC_Brace.stl
26.0 x 41.0 x 25.0
