srl-ethz/hydra-documentation/CAD/STLs/TC_Cover.stl

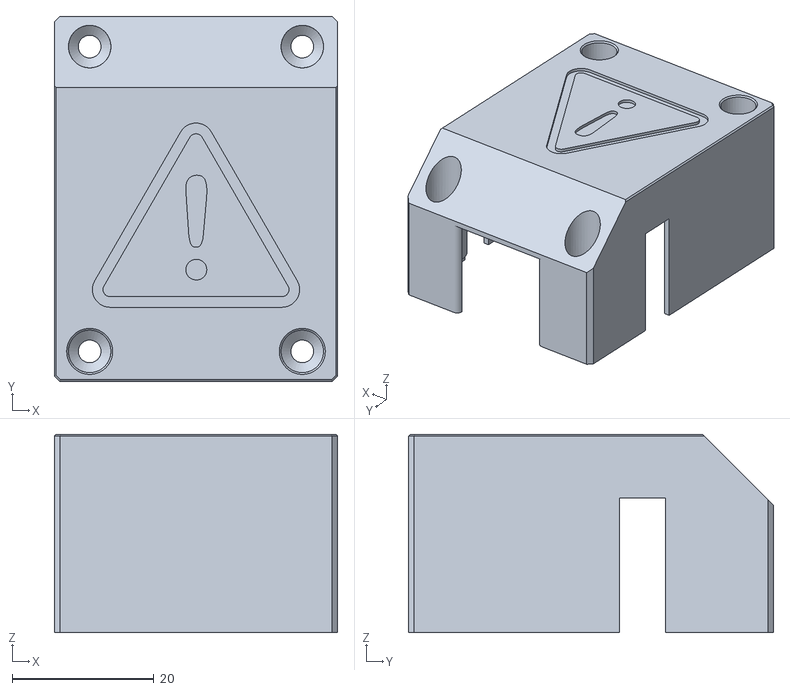
[picture p123: CAD file, 2022-02-17]
CAD/STLs/TC_Cover.stl
40.0 x 51.5 x 28.0
