srl-ethz/hydra-documentation/CAD/STLs/V4_Dock.stl

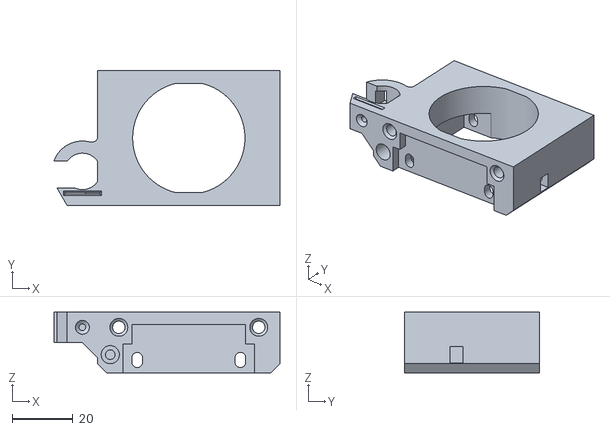
[picture p124: CAD file, 2022-02-17]
CAD/STLs/V4_Dock.stl
74.5 x 44.4 x 20.0
