srl-ethz/hydra-documentation/CAD/STLs/CableClip_Large.stl

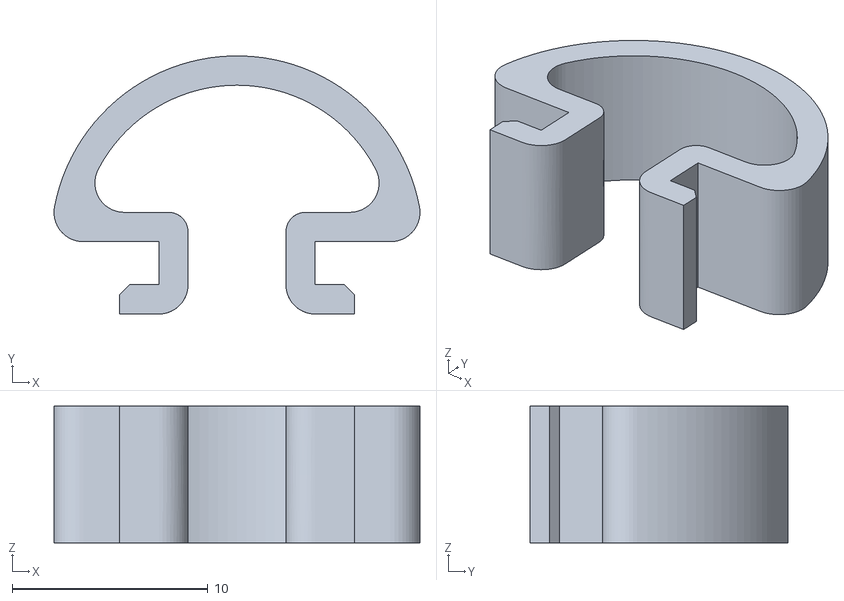
[picture p125: CAD file, 2022-02-17]
CAD/STLs/CableClip_Large.stl
18.7 x 13.2 x 7.00
