srl-ethz/hydra-documentation/CAD/STLs/Hemera_PCF_Duct_-_V6.stl

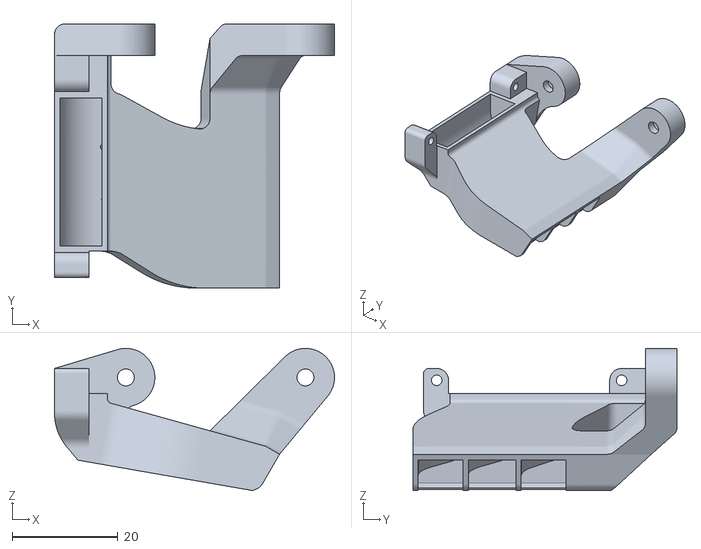
[picture p126: CAD file, 2022-02-17]
CAD/STLs/Hemera_PCF_Duct_-_V6.stl
53.0 x 50.0 x 26.9
