srl-ethz/hydra-documentation/CAD/STLs/V4_Hopper_Adapter_V2.stl

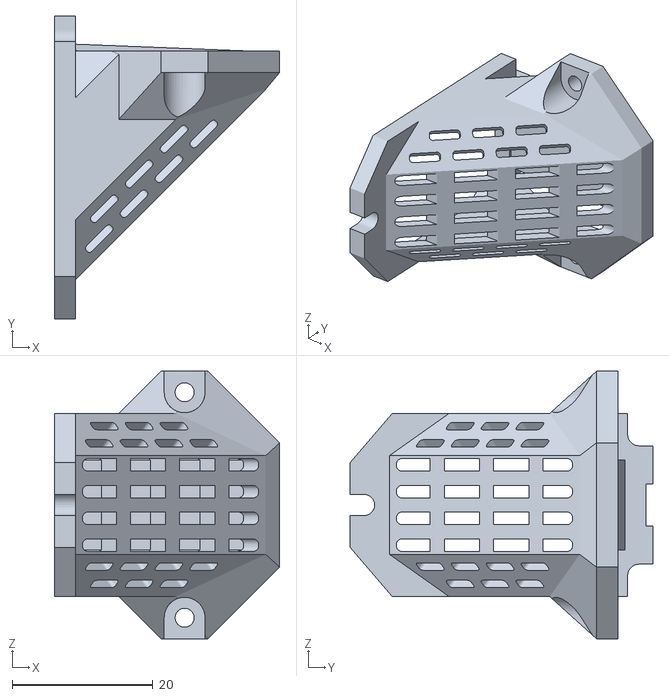
[picture p127: CAD file, 2022-02-17]
CAD/STLs/V4_Hopper_Adapter_V2.stl
32.0 x 43.0 x 38.0
