srl-ethz/hydra-documentation/CAD/STLs/V4_fanduct.stl

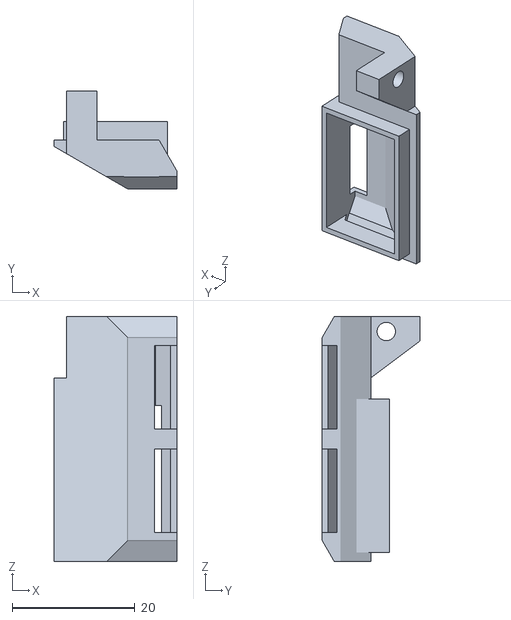
[picture p128: CAD file, 2022-02-17]
CAD/STLs/V4_fanduct.stl
20.0 x 16.0 x 40.0
