srl-ethz/hydra-documentation/CAD/STLs/V4_CoolingGrid.stl

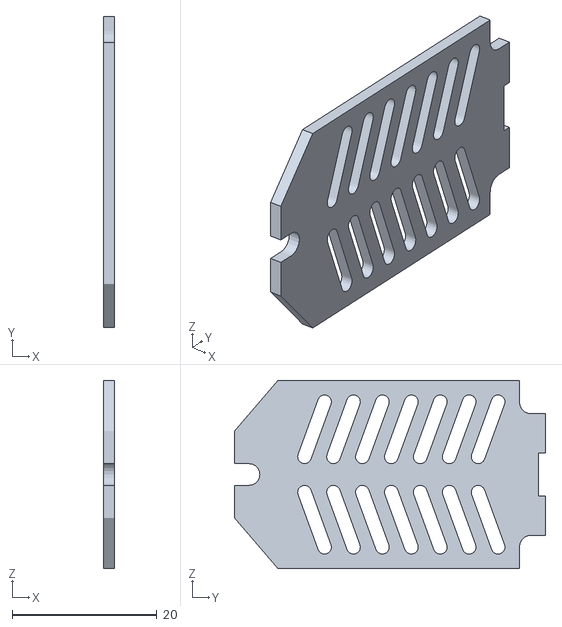
[picture p129: CAD file, 2022-02-17]
CAD/STLs/V4_CoolingGrid.stl
1.50 x 43.0 x 26.0
