srl-ethz/hydra-documentation/CAD/STLs/V4_Hopper_Adapter.stl

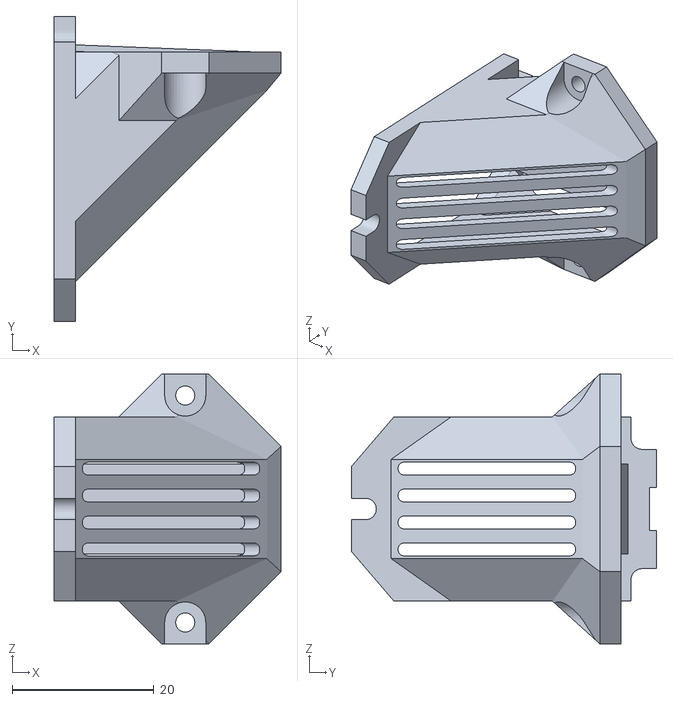
[picture p130: CAD file, 2022-02-17]
CAD/STLs/V4_Hopper_Adapter.stl
32.0 x 43.0 x 38.0
