srl-ethz/hydra-documentation/CAD/STLs/V4_ParkingSpot.stl

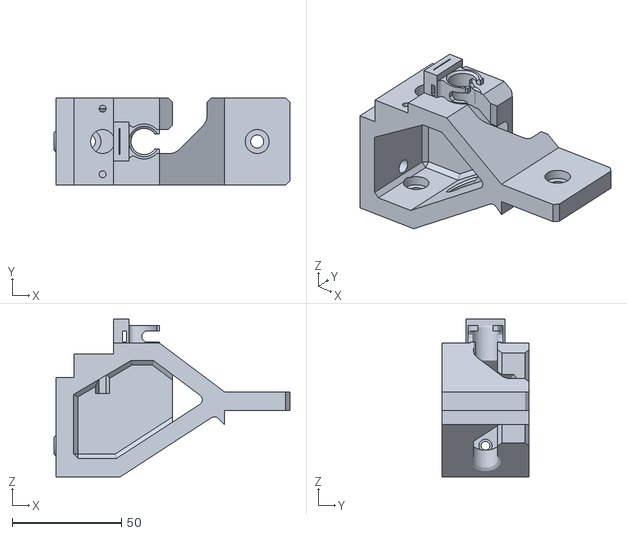
[picture p131: CAD file, 2022-02-17]
CAD/STLs/V4_ParkingSpot.stl
108.0 x 40.0 x 72.3
