srl-ethz/hydra-documentation/CAD/STLs/HemeraBracket.stl

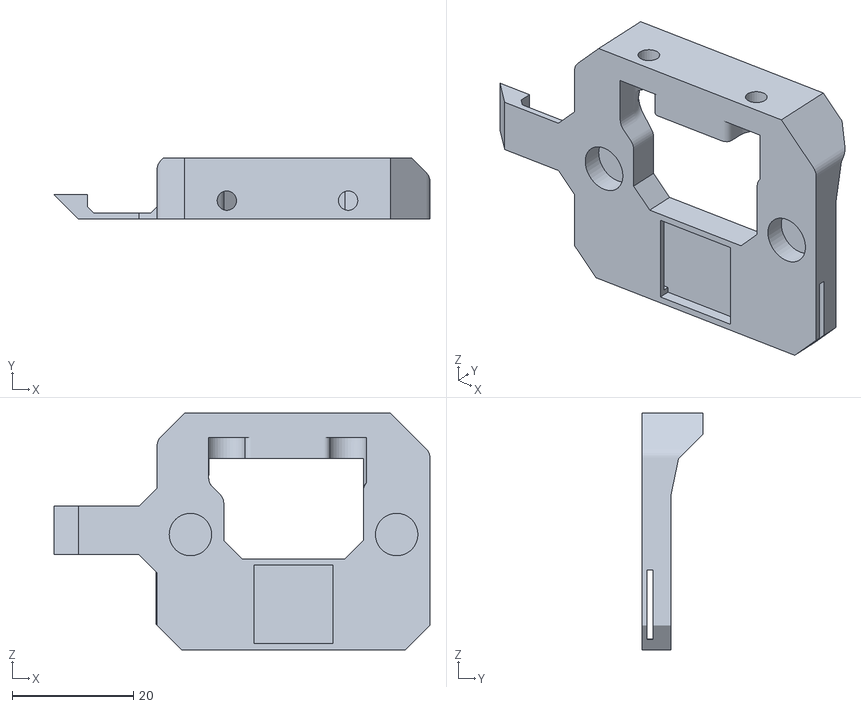
[picture p132: CAD file, 2022-02-17]
CAD/STLs/HemeraBracket.stl
62.0 x 10.0 x 39.0
