srl-ethz/hydra-documentation/CAD/STLs/Hemera_Brace.stl

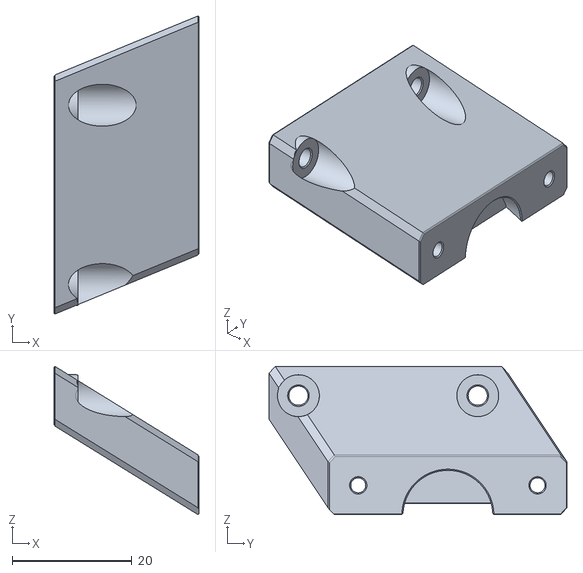
[picture p133: CAD file, 2022-02-17]
CAD/STLs/Hemera_Brace.stl
24.2 x 49.8 x 24.8
