srl-ethz/hydra-documentation/CAD/STLs/FilamentHolder.stl

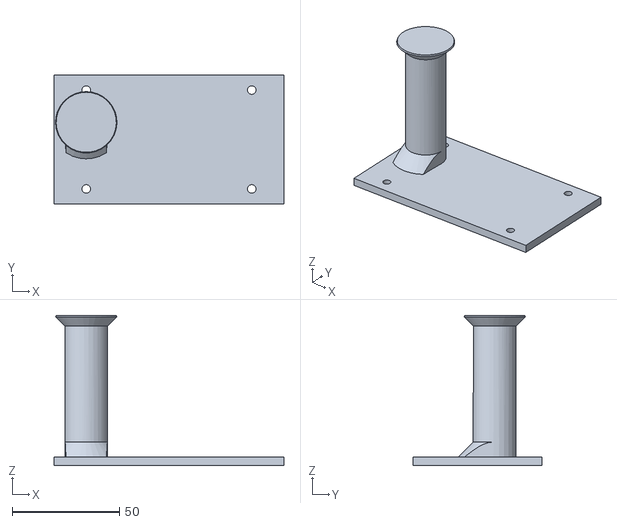
[picture p134: CAD file, 2022-02-17]
CAD/STLs/FilamentHolder.stl
107.0 x 60.0 x 70.0
