srl-ethz/hydra-documentation/CAD/STLs/CableClip_Small.stl

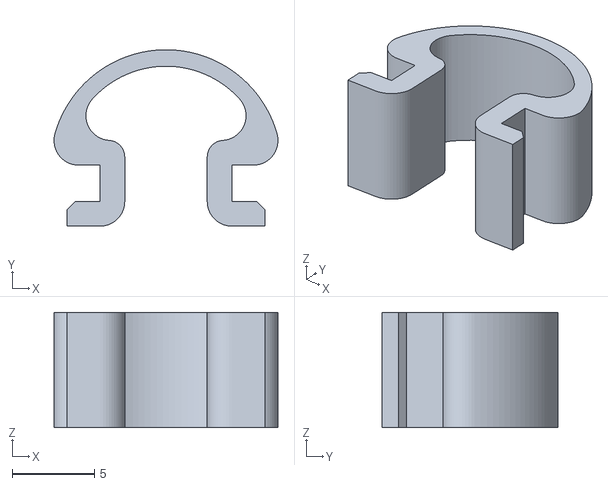
[picture p135: CAD file, 2022-02-17]
CAD/STLs/CableClip_Small.stl
13.6 x 10.7 x 7.00
