srl-ethz/hydra-documentation/CAD/STLs/V4_CoolingV2.stl

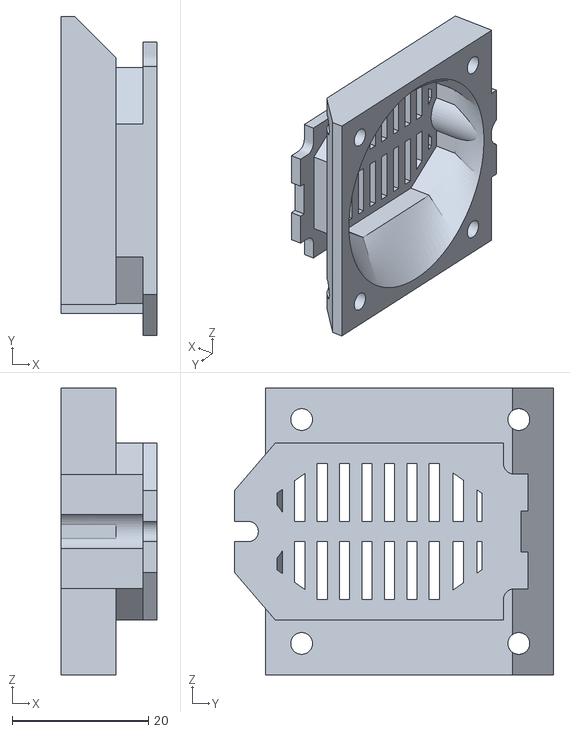
[picture p136: CAD file, 2022-02-17]
CAD/STLs/V4_CoolingV2.stl
14.0 x 46.8 x 42.0
