srl-ethz/hydra-documentation/CAD/STLs/Hemera_Receiver_Top.stl

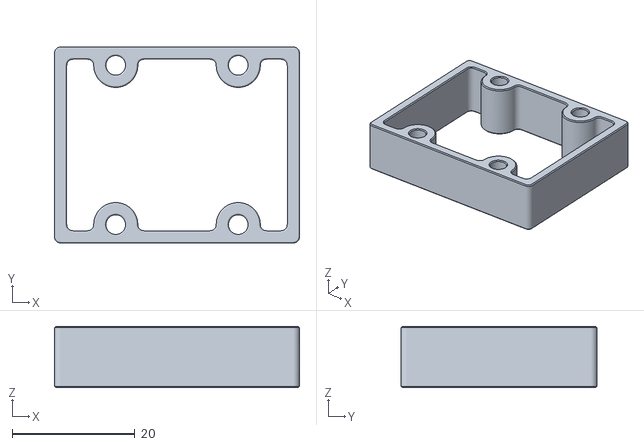
[picture p137: CAD file, 2022-02-17]
CAD/STLs/Hemera_Receiver_Top.stl
40.0 x 32.0 x 10.0
