srl-ethz/hydra-documentation/CAD/STLs/TC_XY_Block.stl

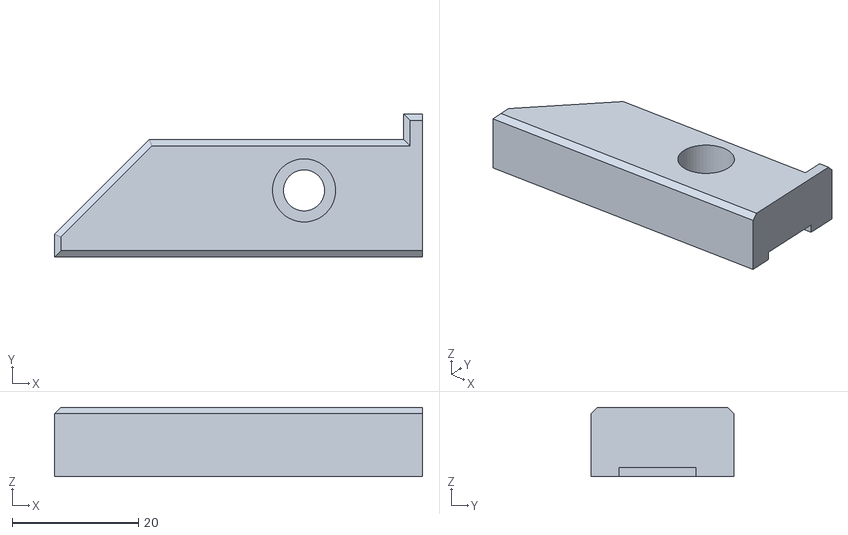
[picture p138: CAD file, 2022-02-17]
CAD/STLs/TC_XY_Block.stl
58.2 x 22.6 x 11.0
