srl-ethz/hydra-documentation/CAD/STLs/HemeraParkingSpot.stl

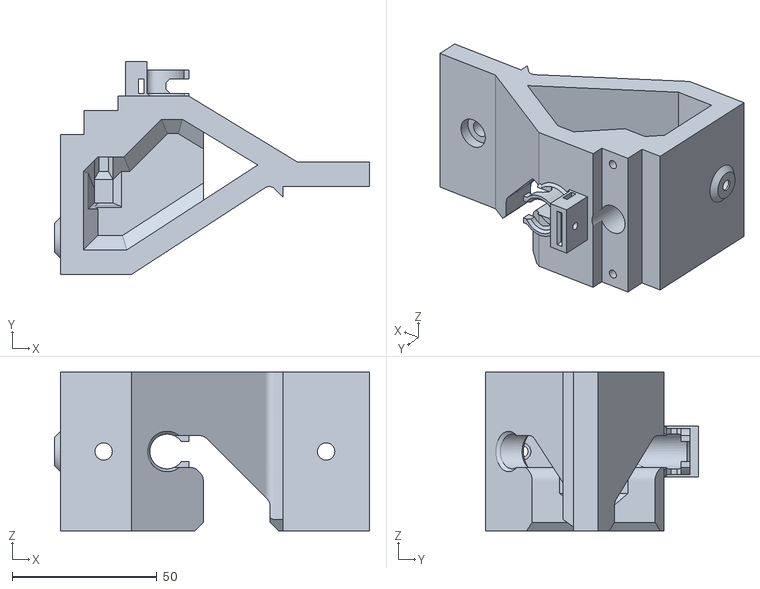
[picture p139: CAD file, 2022-02-17]
CAD/STLs/HemeraParkingSpot.stl
109.0 x 73.7 x 55.0
