srl-ethz/hydra-documentation/CAD/STLs/Hemera_Adapter.stl

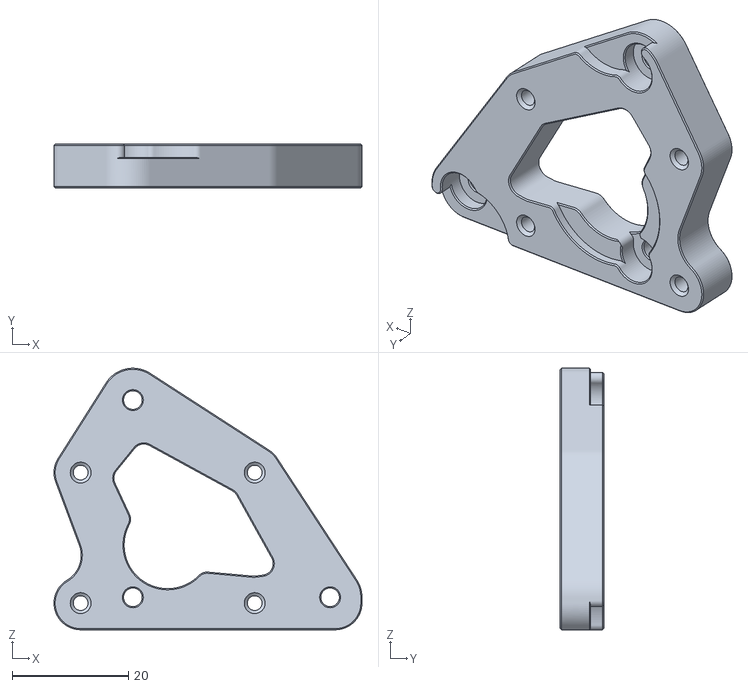
[picture p140: CAD file, 2022-02-17]
CAD/STLs/Hemera_Adapter.stl
53.1 x 7.50 x 45.1
