srl-ethz/hydra-documentation/CAD/STLs/V4_CoolingShroud.stl

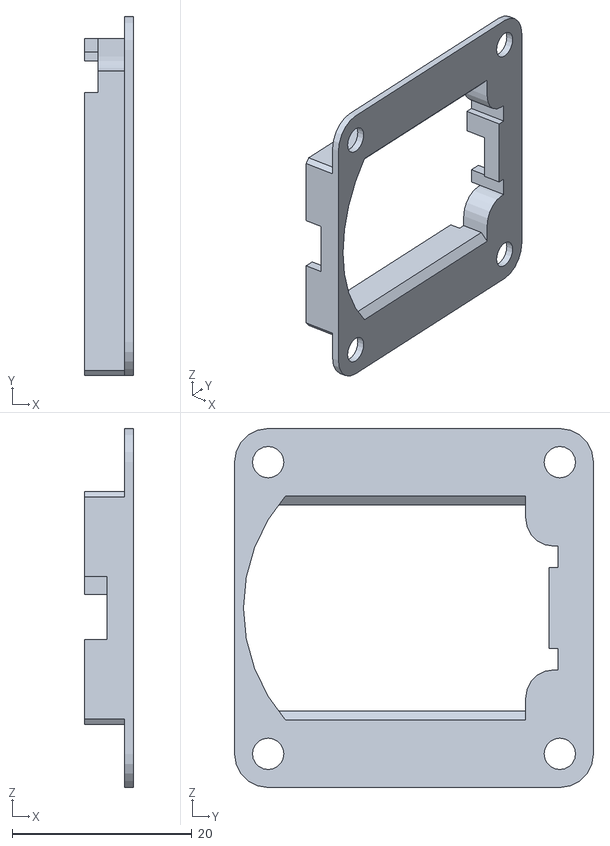
[picture p141: CAD file, 2022-02-17]
CAD/STLs/V4_CoolingShroud.stl
5.50 x 40.0 x 40.0
