srl-ethz/hydra-documentation/CAD/STLs/Hemera_Cable_Relief.stl

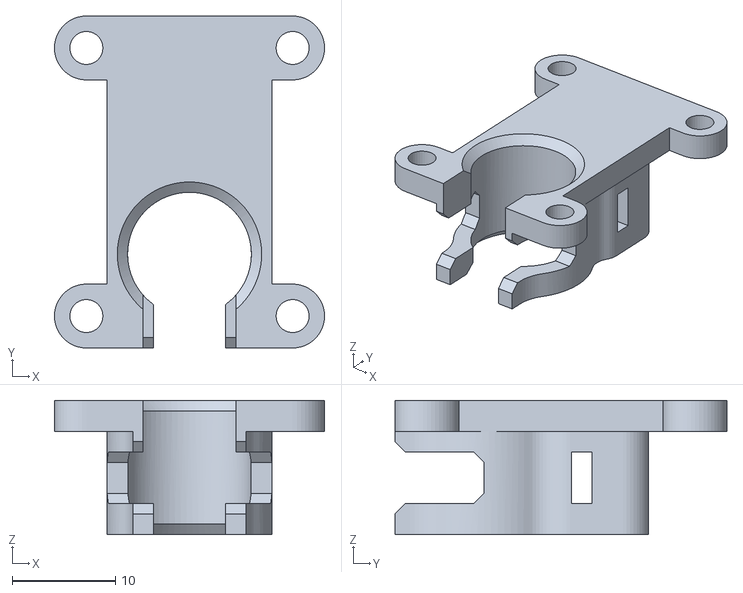
[picture p142: CAD file, 2022-02-17]
CAD/STLs/Hemera_Cable_Relief.stl
26.2 x 32.2 x 13.0
