srl-ethz/hydra-documentation/CAD/STLs/FilamentGuide.stl

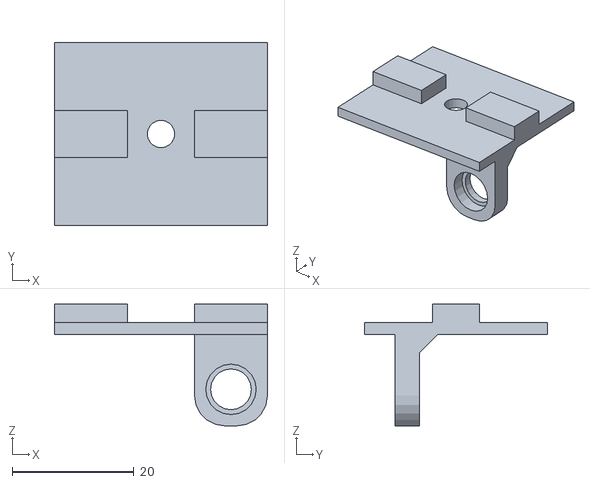
[picture p143: CAD file, 2022-02-17]
CAD/STLs/FilamentGuide.stl
35.0 x 30.0 x 20.0
