srl-ethz/hydra-documentation/CAD/STLs/Y_Switch_Holder.stl

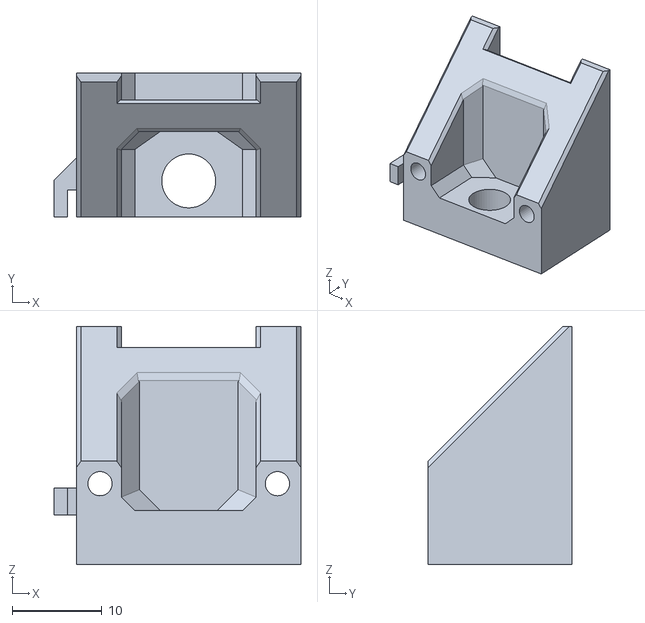
[picture p144: CAD file, 2022-02-17]
CAD/STLs/Y_Switch_Holder.stl
27.5 x 16.0 x 26.5
