srl-ethz/hydra-documentation/docs/source/bom/printed.rst

################################
Printed Parts
################################

For the Motion System and tool changer you will need to print the following parts. It is recommended to print several parts in PETG as they will either be exposed to raised temperatures or mechanical stress. The other parts can also be printed in PETG or a material that is easier to print such as PLA. Optimal orientation and support structures can be found in the TC.3mf file. If you are using a different cable brace, please adapt the "TC Top Block" and "" parts.

============================= ===================
Part Name                     Material
============================= ===================
TC Cover                      PETG
TC Tensioner                  PETG
TC Top Block                  PETG
TC XY Block                   PETG
TC Brace                      PETG/PLA
Y Switch Holder               PETG
Cable Clip Large (10x)        PETG/PLA
Cable Clip Small (5x)         PETG/PLA
============================= ===================

For each Hemera tool the following 3D printed parts are needed. If you are using a different kind of cable brace, please adapt the "Hemera Parking Spot" and "Hemera Cable Relief" parts. If you are using a second Hemera tool, mirror the "Filament Guide" and Filament Holder" parts for the second side.

============================= ===================
Part Name                     Material
============================= ===================
Hemera Adapter                PETG
Hemera Brace                  PETG
Hemera Cable Relief           PETG
Hemera PCF Bracket            PETG
Hemera PCF Duct - V6          PETG
Hemera Receiver Top           PETG
Hemera Bracket                PETG
Hemera Parking Spot           PETG/PLA
Filament Guide                PETG/PLA
Filament Holder               PETG/PLA
============================= ===================

For Each Pellet Extruder V4 please print the following parts. If you are using a different kind of cable brace, please adapt the "V4 Parking Spot" and "V4 Dock" parts.

============================= ===================
Part Name                     Material
============================= ===================
V4 Cooling Grid               PETG
V4 Cooling Shroud             PETG
V4 Dock                       PETG
V4 Fanduct                    PETG
V4 Hopper                     PETG
V4 Hopper Adapter             PETG
V4 Parking Spot               PETG/PLA
V4 Plate                      PETG
============================= ===================

After the parts are printed, remove any support material.

Make sure your cable brace fits in the slots. If not, you can either clear the slots with an Exacto knife or heat the metal strip and insert it into the recess. Check whether M3 screws can fit into the 3.2mm holes of the parts. If they bind up, you can drill open these holes with a 3.2mm or 3mm drill bit.

.. Attention:: Some holes are meant to be taped into. Namely the mounting holes for TC receiver plates and the securing holes for the cable brace. Do not drill open these holes!
