srl-ethz/hydra-documentation/docs/source/maintenance/update.rst

################################
Updating Firmware
################################

To update the firmware (RepRap) on the Duet3D boards, please refer to the guide  `here <https://duet3d.dozuki.com/Wiki/Getting_Started_With_Duet_3#Section_Updating_Duet_3_main_board_firmware>`_ . Note that the Hydra is using an SBC to connect to the Duet3D boards, which significantly facilitates the updating process, if connected to the internet.
