srl-ethz/hydra-documentation/docs/source/maintenance/uncloggpellet.rst

################################
Unclogging Pellet Extruder
################################

If the pellet extruder is clogged, first try to remove any material from the chamber and extrude some material at the slowest speed. 

If this fails, try raising the temperature by 10-20 degrees (assuming the material is not flammable or deteriorates at said temperatures) and try to extrude some material.

If this fails, remove the nozzle from the extruder and try the same procedure.

If the pellet extruder is still clogged, you will have to take it apart, to clean the extruder screw. This will take between 30 and 60 minutes.

To take apart the V4 Pellet Extruder please follow the assembly guide in reverse order, until both aluminium brackets are removed. The Extruder should now look like this:

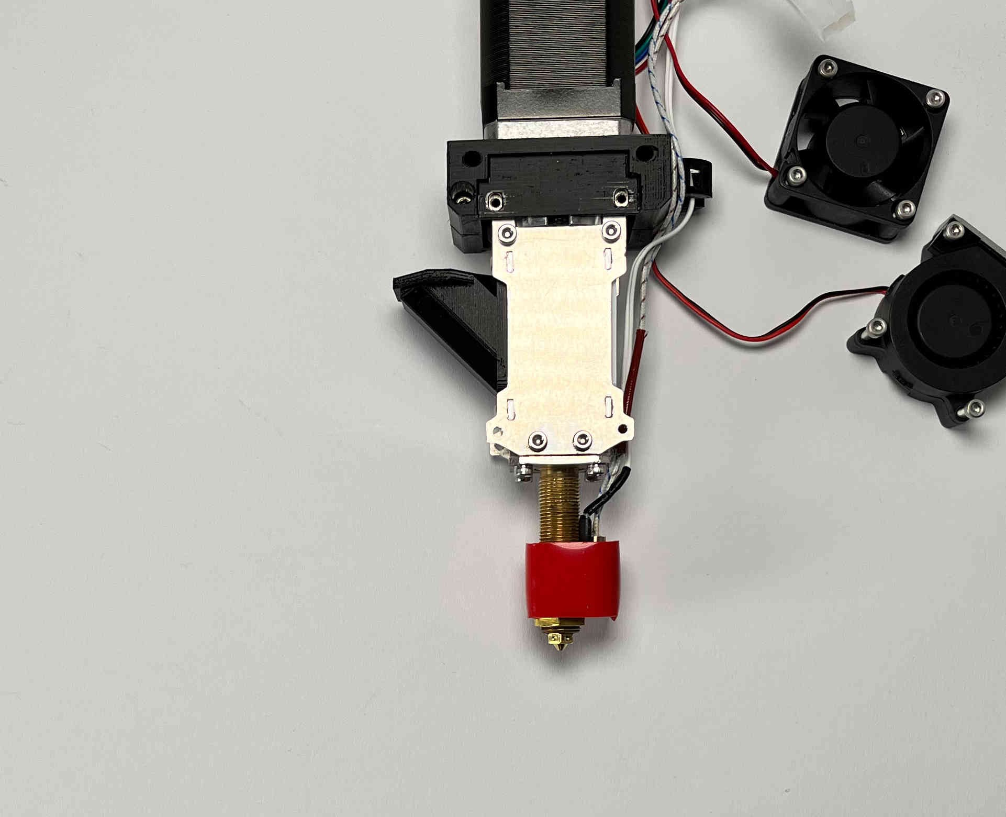
[picture p174: docs/source/maintenance/img/Maint1.jpg]


Now unscrew the four M3 bolts holding the small aluminium plate around the main brass tube.

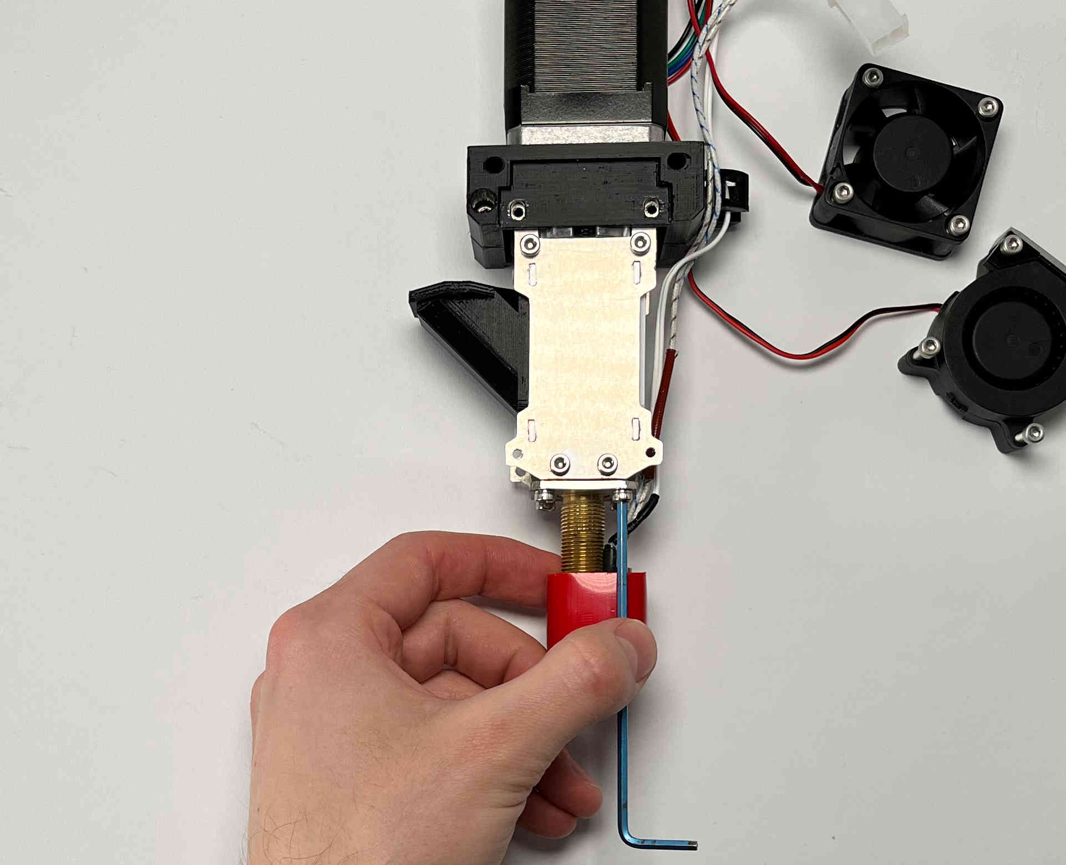
[picture p175: docs/source/maintenance/img/Maint2.jpg]

    
After removing the tube you should be able to slide the brass tube off of the extruder screw.

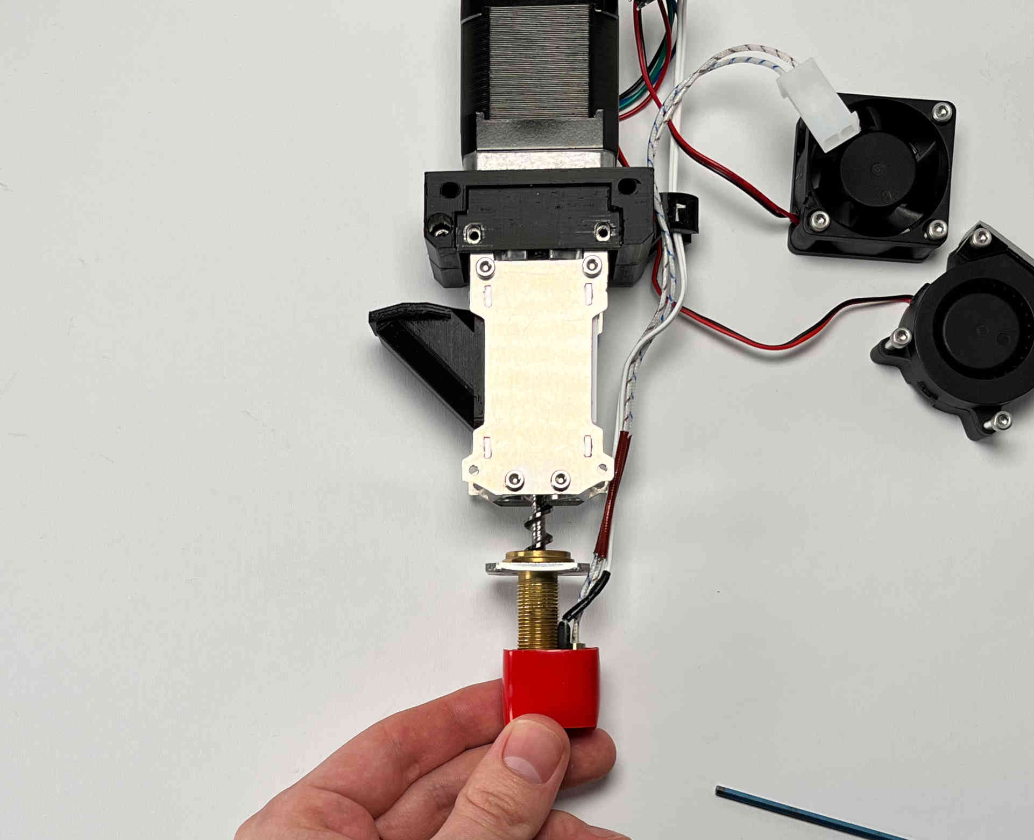
[picture p176: docs/source/maintenance/img/Maint3.jpg]

    
Be careful to not damage the heat cartridge and/or the thermistor. When you have to exert larger forces to remove the clog, it could make sense to remove the heating block, to prevent damage.
