srl-ethz/hydra-documentation/CAD/Machined Parts/TC_Plate_TD.pdf

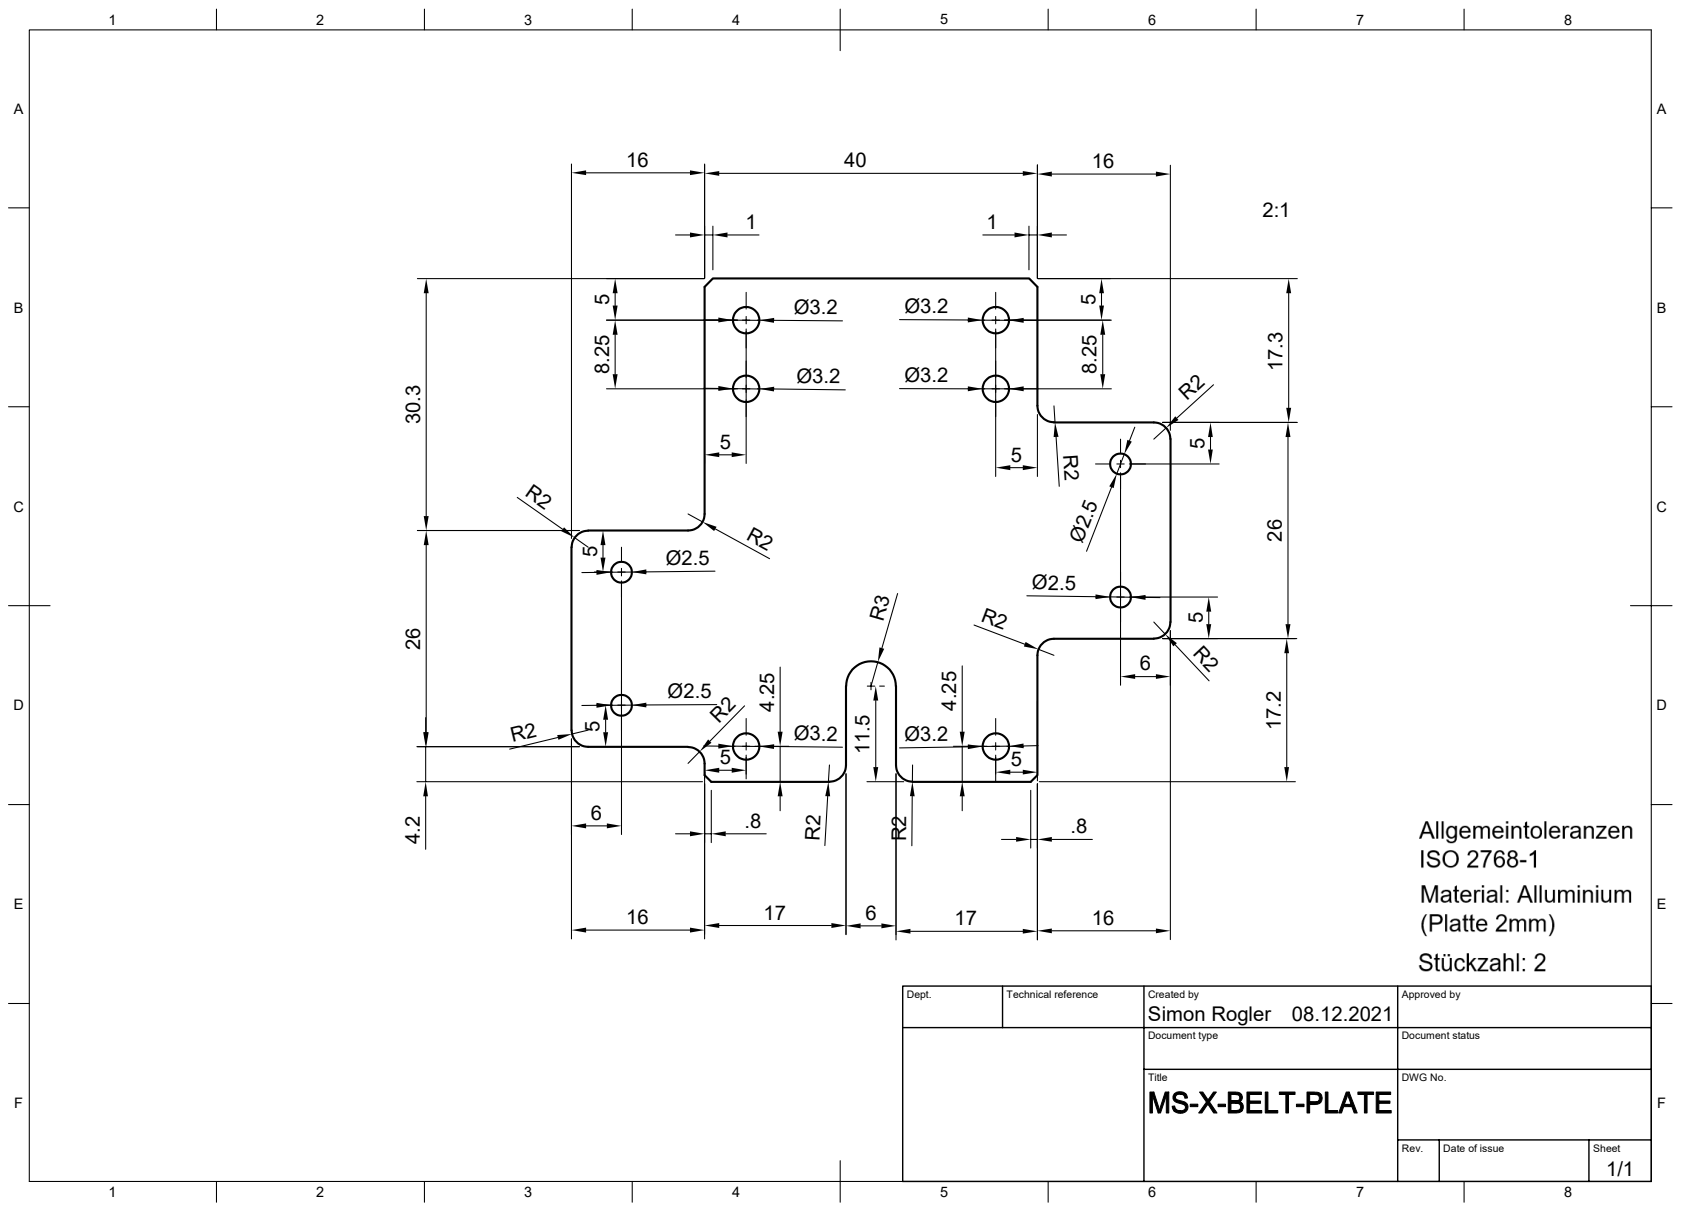
[picture p177: page 1]
8 BCDEF; ABCDEF Dept.; Technical reference; Created by; Approved by Document type; Document status Title; DWG No. Rev.; Date of issue; Sheet 08.12.2021; 1/1 Simon Rogler
