srl-ethz/hydra-documentation/CAD/Machined Parts/TC_Shaft_TD.pdf

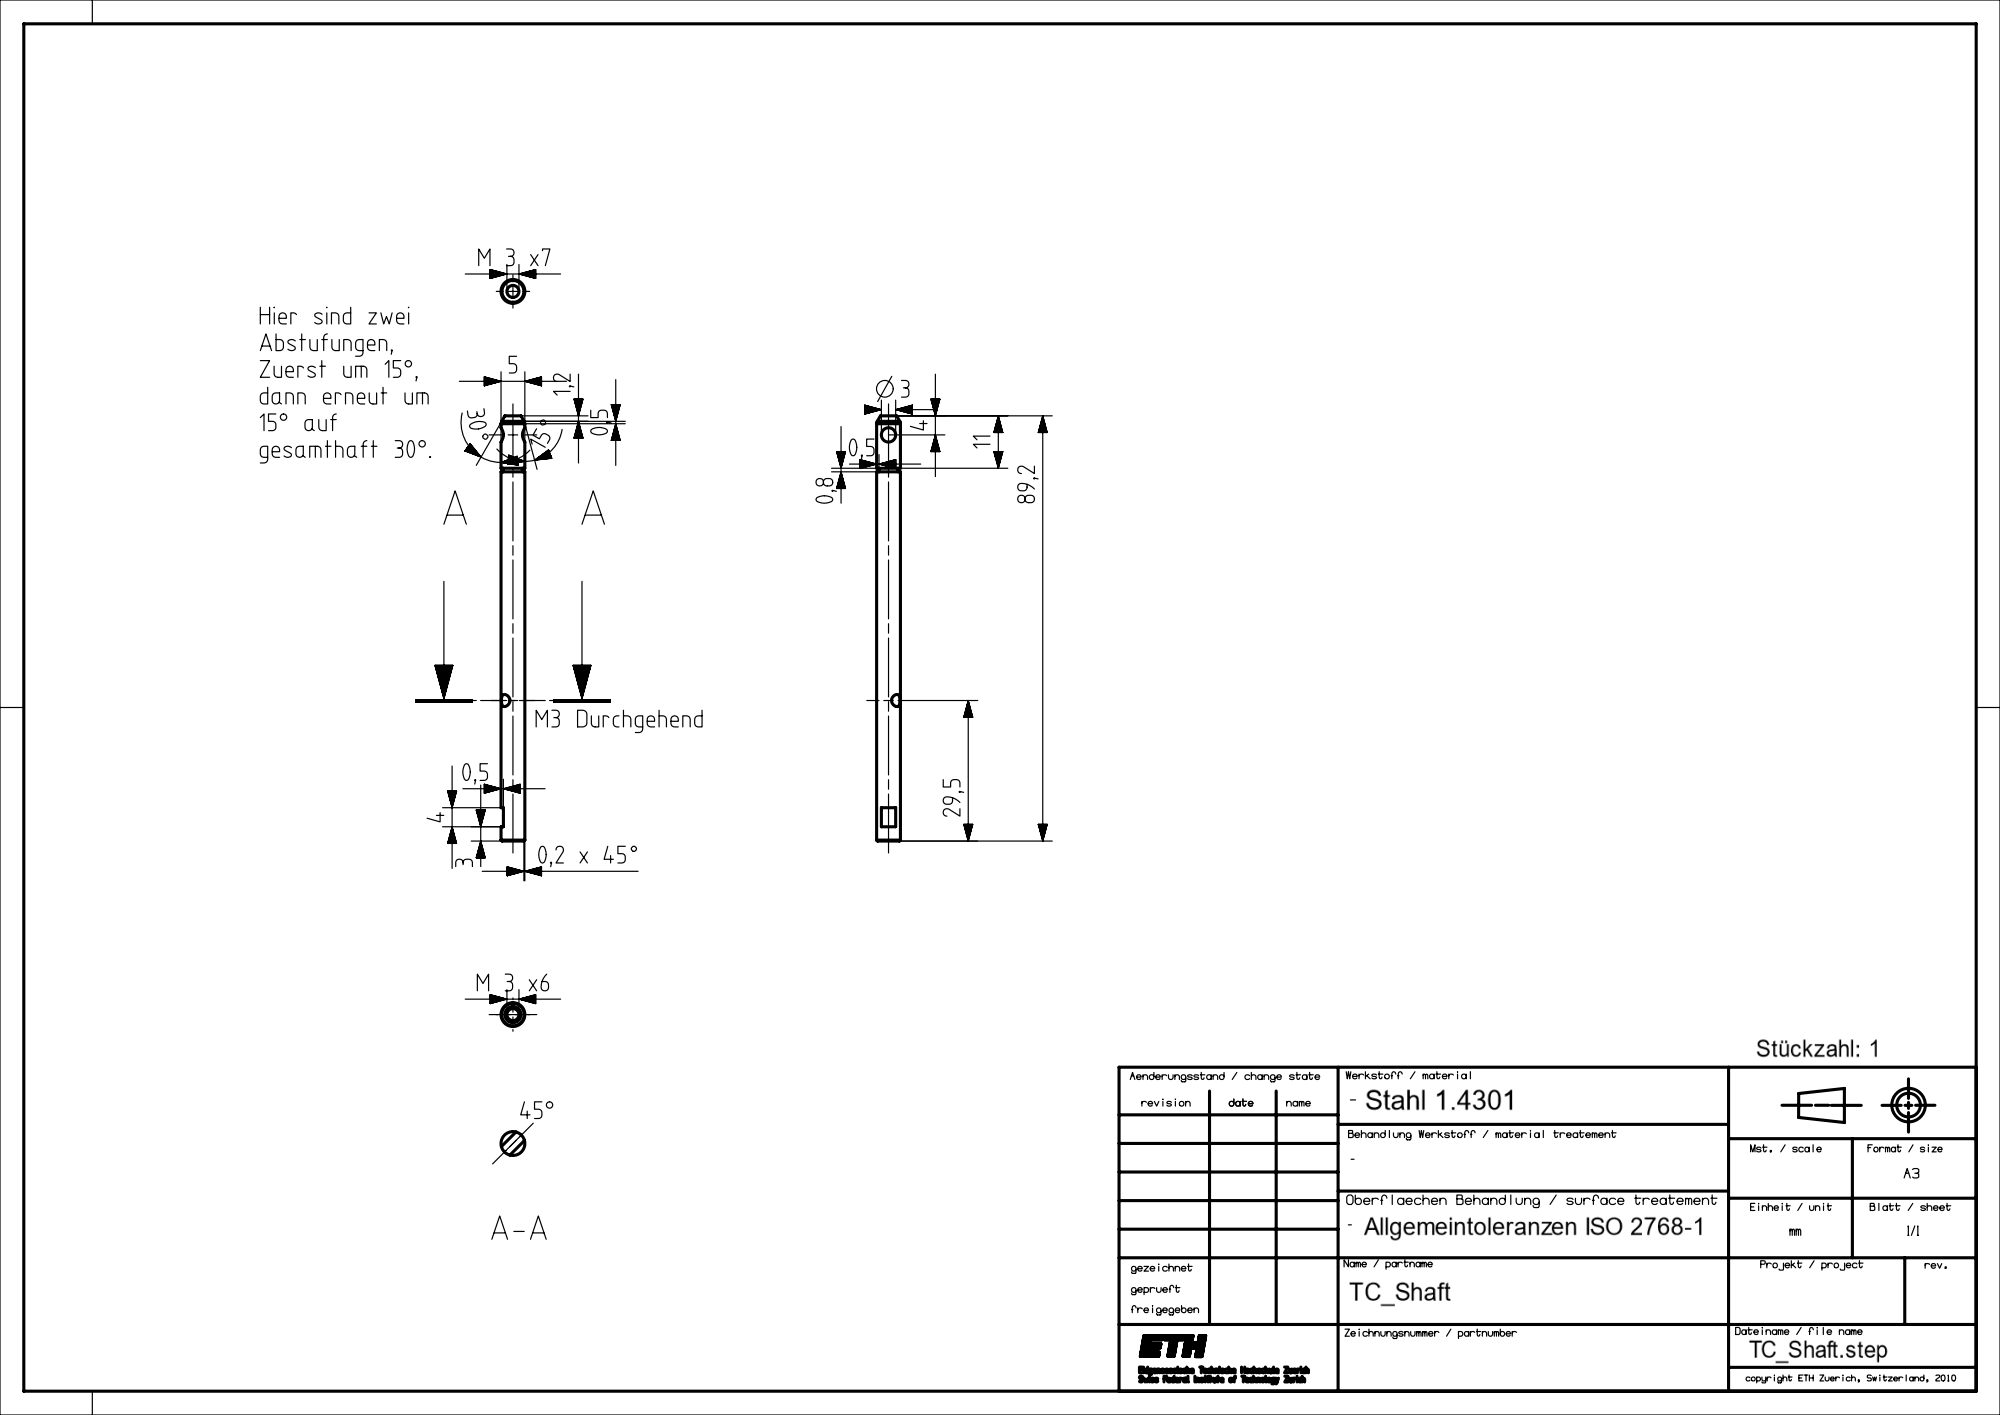
[picture p178: page 1]
